MSTKMAD/MK1/02.Hardware/MK1-ATMEGA/EDCPSU_DUAL_MSTK_M1/00. DUAL M1 MSTK PANEL/Panel Layout.jpg

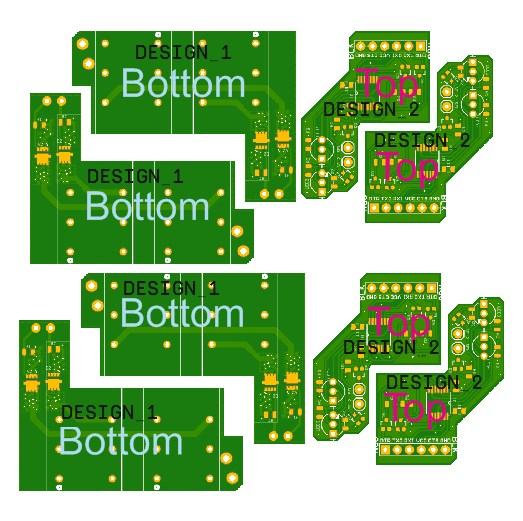
02.Hardware/MK1-ATMEGA/EDCPSU_DUAL_MSTK_M1/00. DUAL M1 MSTK PANEL/Panel Layout.jpg
