MSTKMAD/MK1/README.md

# MK1

Migracion desde Bitbucket del repostorio de la Machete MK1
