MSTKMAD/MK1/01.Documentation/Troubleshoting Display EDCPSU r15.docx

# Troubleshoting Display EDCPSU r15

## Multimeter continuity mode:

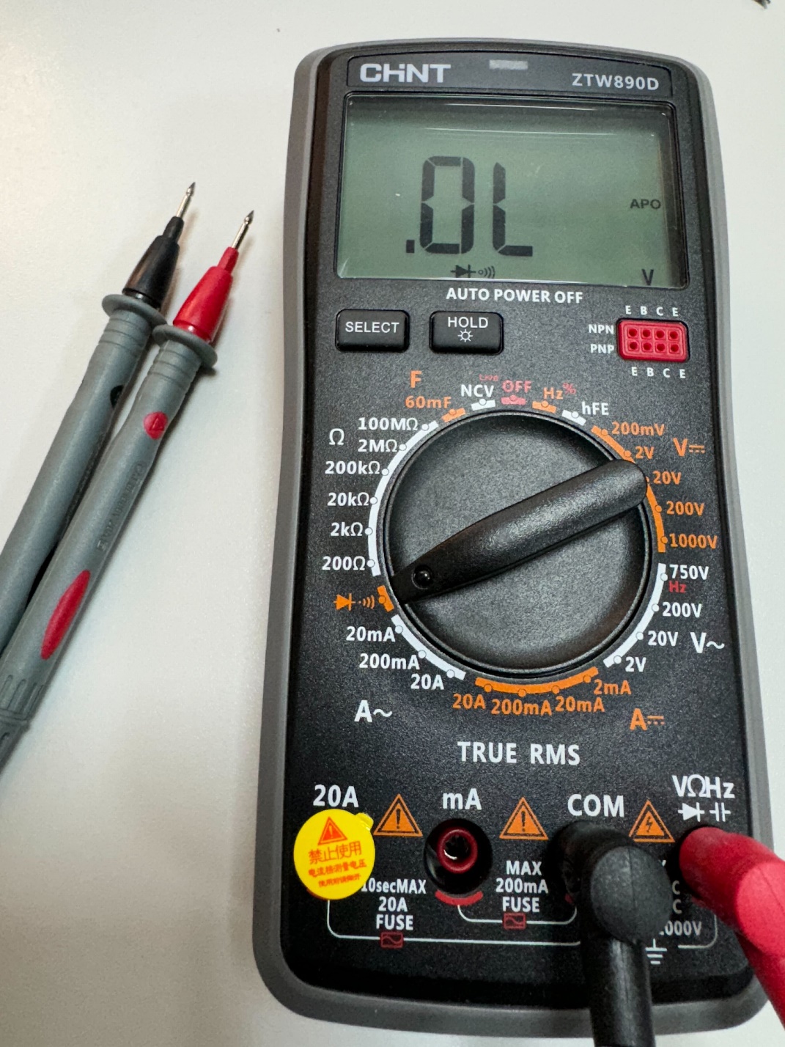
[picture p2: figure]

Pins

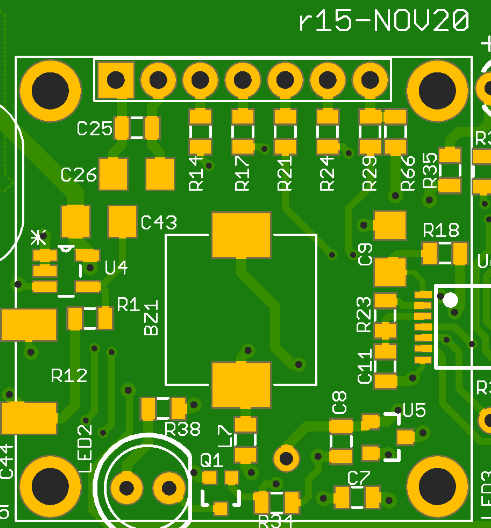
[picture p3: figure]

1

2

3

4

5

6

7

1. GND
2. VCC
3. SCK
4. MOSI
5. DSP_RST
6. MISO
7. SS
1. GND
2. VCC
3. SCK
4. MOSI
5. DSP_RST

4th starting from the Left

6. MISO
7. SS

3th starting from the Right
