MSTKMAD/MK1/02.Hardware/MK1-ATMEGA/EDCPSUr15/GERBER/EUROCIRCUITS-SI_E1262747/EDCPSU r15 files/PI_E1311610.pdf

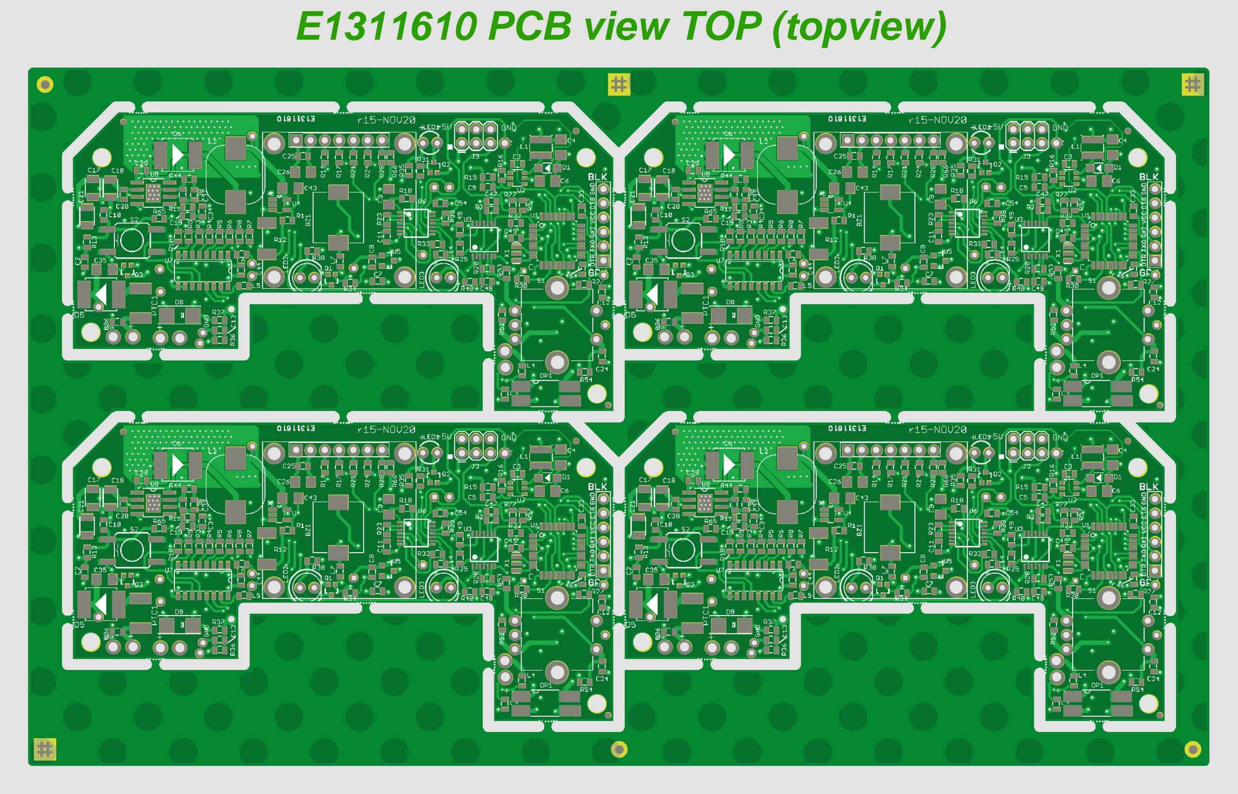
[picture p4: page 1]

E1311610 PCB view TOP (topview)

E1311610 TOP layer Image (topview)

E1311610 Innerlayer 2 Image (topview)

E1311610 Innerlayer 3 Image (topview)

E1311610 BOTTOM layer Image (topview)

E1311610 PCB view BOTTOM (bottomview)

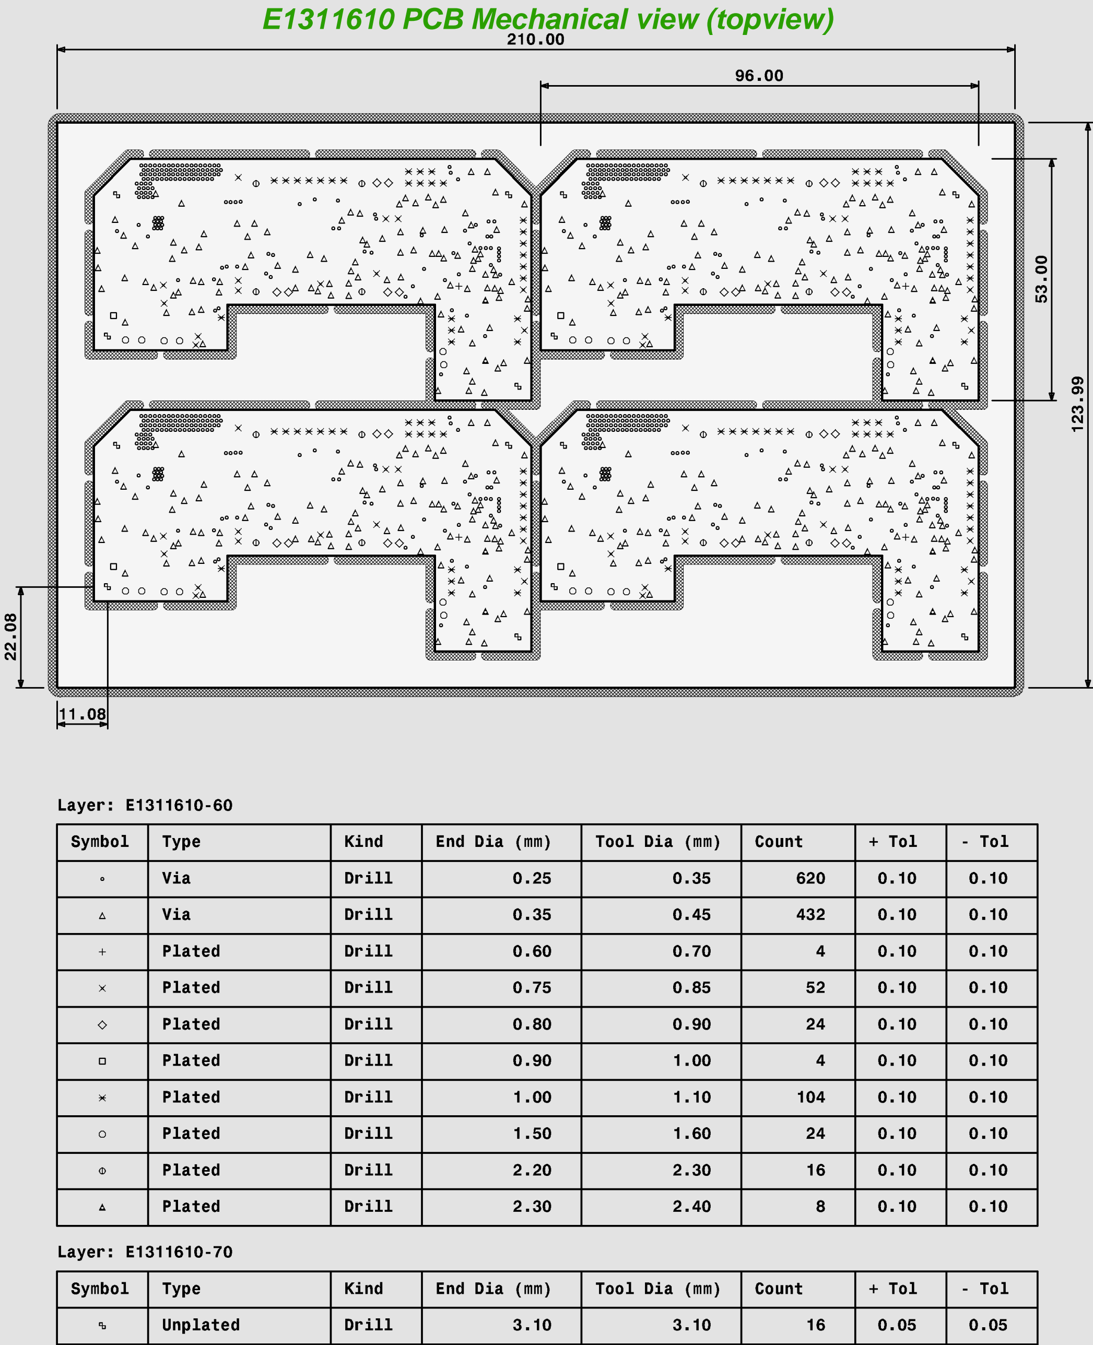
[picture p5: page 7]

E1311610 PCB Mechanical view (topview)
