MSTKMAD/MK1/02.Hardware/MK1-ATMEGA/EDCPSU_DUAL_MSTK_M1/01. DUAL_M1_LEDS/DUAL_M2_LEDS.png

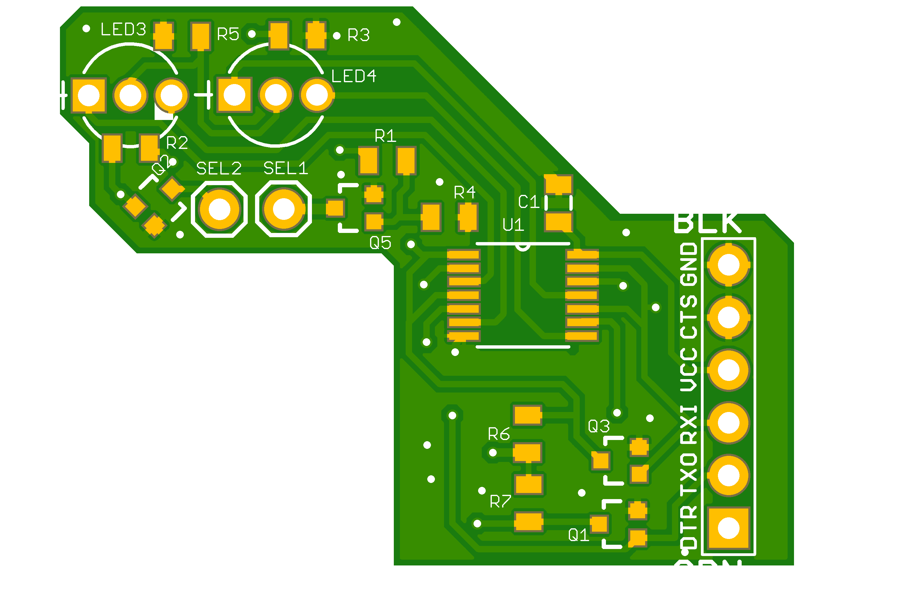
02.Hardware/MK1-ATMEGA/EDCPSU_DUAL_MSTK_M1/01. DUAL_M1_LEDS/DUAL_M2_LEDS.png
