MSTKMAD/MK1/02.Hardware/MK1-ATMEGA/EDCPSUr13/Solucionar Enable.png

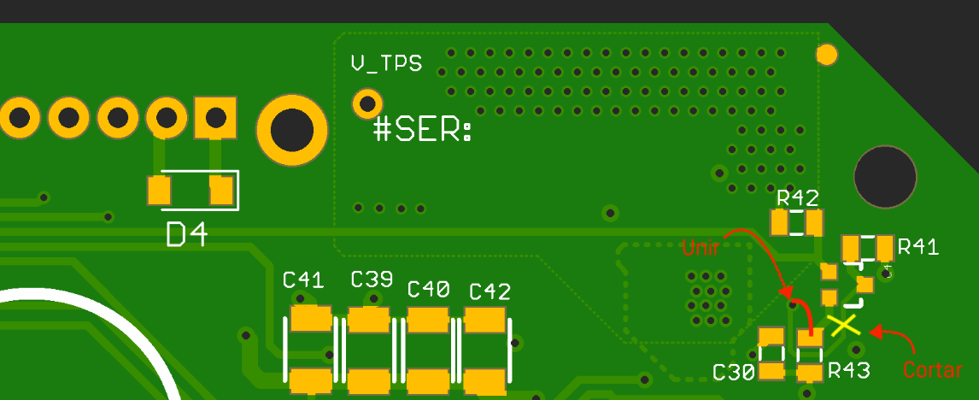
02.Hardware/MK1-ATMEGA/EDCPSUr13/Solucionar Enable.png
