MSTKMAD/MK1/02.Hardware/MK1-ATMEGA/EDCPSUr8v0/EDCPSUr8_BOM_v1.xlsx

Sheet: EDCPSUr7v0enero
 |  |  |  |  |  | BOM VERSION v1
 |  |  |  |  |  | 2016-10-27
 |  |  |  |  |  | EDCPSU_r8v0
Assembly? | Pos | Qty | Parts | Value | Device | Package | Description | Details | DIGIKEY | COST (25pcs) | COST (100pcs) | COST per Board (25pcs)
P | 1 | 1 | R12 | 0.05R / 1W | RESISTOR2512-RES | 2512 | Current sense resistor | 1W, 1%, 75ppm | 985-1555-1-ND | 0.27 | 0.18 | 0.27
P | 2 | 6 | R1, R32, R39, R43, R66, R77 | 10K | RESISTOR0805-RES | 805 | Resistor | 5% |  |  |  | 0
P | 3 | 1 | R11 | 15K | RESISTOR0805-RES | 805 | Resistor | 5%
P | 4 | 1 | R3 | 11K | RESISTOR0805-RES | 805 | Resistor | 5% |  |  |  | 0
P | 5 | 1 | R7 | 180K | RESISTOR0805-RES | 805 | Resistor | 5% |  |  |  | 0
P | 6 | 4 | R2, R19, R20, R25 | 1K | RESISTOR0805-RES | 805 | Resistor | 5% |  |  |  | 0
P | 7 | 1 | R6 | 1K4 | RESISTOR0805-RES | 805 | Resistor | 5% |  |  |  | 0
P | 8 | 1 | R16 | 12K | RESISTOR0805-RES | 805 | Resistor | 5% |  |  |  | 0
P | 9 | 1 | R37 | 220K | RESISTOR0805-RES | 805 | Resistor | 5% |  |  |  | 0
P | 10 | 1 | R10 | 22K | RESISTOR0805-RES | 805 | Resistor | 5% |  |  |  | 0
P | 11 | 7 | R13, R23, R52, R53, R54, R57, R58 | 2K2 | RESISTOR0805-RES | 805 | Resistor | 5% |  |  |  | 0
P | 12 | 1 | R5 | 2K8 | RESISTOR0805-RES | 805 | Resistor | 5% |  |  |  | 0
P | 13 | 10 | R14, R17, R21, R24, R28, R29, R30, R31, R65, R99 | 33 | RESISTOR0805-RES | 805 | Resistor | 5% |  |  |  | 0
P | 14 | 6 | R27, R33, R35, R61 | 330 | RESISTOR0805-RES | 805 | Resistor | 5% |  |  |  | 0
P | 15 | 2 | R22, R26 | 330 | RESISTOR1206-RES | 1206 | Resistor | 5% |  |  |  | 0
P | 16 | 1 | R44 | 33K | RESISTOR0805-RES | 805 | Resistor | 5% |  |  |  | 0
P | 17 | 1 | R9 | 43K | RESISTOR0805-RES | 805 | Resistor | 5% |  |  |  | 0
P | 18 | 1 | R4 | 5K6 | RESISTOR0805-RES | 805 | Resistor | 5% |  |  |  | 0
P | 19 | 1 | R15 | 68K | RESISTOR0805-RES | 805 | Resistor | 5% |  |  |  | 0
P | 20 | 1 | R36 | 75K | RESISTOR0805-RES | 805 | Resistor | 5% |  |  |  | 0
P | 21 | 1 | R8 | 91K | RESISTOR0805-RES | 805 | Resistor | 5% |  |  |  | 0
P | 22 | 30 | C1, C2, C7, C8, C10, C12, C14, C15, C20, C22, C23, C24, C25, C27, C28, C29, C31, C32, C33, C34, C36, C44, C45, C46, C47, C48, C49, C50, C51, C53 | 100n | CAP0805 | 805 | Capacitor | 25V-50V, X7R or XR5 |  |  |  | 0
P | 23 | 6 | C4, C6, C26, C35, C43, C52 | 10uF | CAP1206 | 1206 | Capacitor | 25V-50V, X7R or XR5 |  |  |  | 0
P | 24 | 2 | C3, C30 | 15n | CAP0805 | 805 | Capacitor | 25V-50V, X7R or XR5 |  |  |  | 0
P | 25 | 1 | C38 | 15p | CAP0805 | 805 | Capacitor | 25V-50V, X7R or XR5 |  |  |  | 0
P | 26 | 4 | C11, C13, C16, C54 | 1uF | CAP0805 | 805 | Capacitor | 25V-50V, X7R or XR5 |  |  |  | 0
P | 27 | 1 | C9 | 1uF | CAP1206 | 1206 | Capacitor | 25V-50V, X7R or XR5 |  |  |  | 0
P | 28 | 1 | C37 | 2.2n | CAP0805 | 805 | Capacitor | 25V-50V, X7R or XR5 |  |  |  | 0
P | 29 | 4 | C39, C40, C41, C42 | 22uF | CAP1210 | 1210 | Capacitor | 25V, X5R | 490-6540-1-ND | 0.31 |  | 1.24
P | 30 | 3 | C17, C18, C21 | 4.7uF | CAP1206 | 1206 | Capacitor | 50V, 10% X7R | 1276-2789-1-ND | 0.18 | 0.14 | 0.54
P | 31 | 1 | L2 | 4.7uH | L74437368047 | WE-LHMI |  | 4.7uH, 7A 0.0155 OHM | 732-3389-1-ND | 2.96 | 2.5 | 2.96
P | 32 | 1 | L1 | 6.8uH | L4018 | NR4018T100M | Inductor | 6.8uH, 1A, 0.132R | 587-2657-1-ND | 0.25 | 0.2 | 0.25
P | 33 | 5 | L3, L4, L5, L6, L7 | MMZ2012Y202BT000 | INDUCTOR-0805 | 805 | Inductor | FERRITE CHIP 2000 OHM 400MA | 445-1561-1-ND | 0.08 | 0.045 | 0.4
P | 34 | 2 | U3, U6 | SN74AC14DBR | SN74AC14DBR | SSOP14 | Hex schmitt trigger INVERTER |  | 296-4299-1-ND | 0.38 | 0.28 | 0.76
P | 35 | 1 | U1 | ATMEGA328P-AU | ATMEGA328P-AU | 32-TQFP | MCU 8BIT 32KB FLASH 32TQFP |  | ATMEGA328P-AU-ND (http://www.digikey.es/product-detail/en/ATMEGA328P-AU/ATMEGA328P-AU-ND/1832260) | 2.8 (http://www.digikey.es/product-detail/en/ATMEGA328P-AU/ATMEGA328P-AU-ND/1832260) | 2.56 | 2.8
P | 36 | 1 | U5 | LM3480IM3X-12 | LM3480IM3X-12 | SOT23-3 | Small package linear regulator |  | LM3480IM3X-12/NOPBCT-ND | 0.76 | 0.66 | 0.76
P | 37 | 1 | U4 | MAX9938TEUK+TCT-ND |  | SOT23-5 | Current sense amplifier | X25 GAIN | MAX9938TEUK+TCT-ND | 1 | 0.93 | 1
P | 38 | 1 | U2 | BD9G101G | BD9G101G | SSOP6 | BD9G101G - Simple Step-down |  | BD9G101G-CT-ND | 1.26 | 1.11 | 1.26
P | 39 | 1 | U7 | TPIC2810D | TPIC2810D | SO16 | I2C Led driver |  | 296-21426-5-ND | 1.4 | 1.13 | 1.4
P | 40 | 1 | U8 | TPS54531DDAR | TPS54531DDAR | SOIC8 | BUCK converter |  | 296-40801-1-ND | 2.2 | 1.45 | 2.2
P | 41 | 1 | X1 | 16MHz | RESONATORSMD | 3-SMD, Non-Standard | CER RESONATOR 16.00MHZ SMD | 16MHz | 490-1198-1-ND | 0.39 | 0.31 | 0.39
P | 42 | 1 | S2 | TAC_SWITCH_KSC931G-SMD | TAC_SWITCH_KSC931G-SMD | TAC_SW_SMD_KSC931G | Momentary Switch |  | CKN10432CT-ND | 0.73 | 0.61 | 0.73
P | 43 | 1 | PTC1 | 1,5A HOLD / 3A LIM | PTC | 1812 | PTC RESTTBLE 1.50A 24V CHIP 1812 | 1,5A | 507-1505-1-ND | 0.24 | 0.22 | 0.24
P | 44 | 4 | Q2, Q3, Q9 | 2N7002PW | MOSFET-NCHANNEL2N7002PW | SOT323 | MOSFET N-CH 60V 0.31A, 1.6 Ohm. 2.4 VGS |  | 568-5987-1-ND | 0.24 | 0.18 | 0.96
P | 45 | 2 | D2, D3 | BAV199 | BAV199 | SOT23 | DIODE |  | BAV199INCT-ND | 0.18 | 0.08 | 0.36
P | 46 | 2 | D5, D6 | Diode | DSMC | DO-214AB | SCHOTTKY 40V 5A DO214AB |  | SK54L-TPMSCT-ND | 0.35 | 0.3 | 0.7
P | 47 | 1 | D1 | RB060M-60TR | RB060M-60TR | PMDU | DIODE SCHOTTKY 60V 2A PMDU |  | RB060M-60CT-ND | 0.3 | 0.19 | 0.3
P | 48 | 1 | D8 | B220A-13-F | DIODE | DO-214AC | DIODE SCHOTTKY 20V 2A SMA |  | B220A-FDICT-ND | 0.31 | 0.19 | 0.31
P | 49 | 1 | OP1 | LTV816S | LTV816S | SMD4 Gullwing | OPTO COUPLER | CTRmin=50% @ 5mA, 5KViso | 160-1361-5-ND | 0.28 | 0.18 | 0.28
P | 50 | 1 | BZ1 | PKMCS0909E4000-R1 | PKMCS0909E4000-R1 | SMD | Buzzer 12V |  | 490-9647-1-ND (https://www.digikey.es/product-detail/en/murata-electronics-north-america/PKMCS0909E4000-R1/490-9647-1-ND/4878401) | 1.08 | 0.968 | 1.08
 | 51
NO | 52 | 1 | S1 | ROTARTY_ENCODER | ROTARTY_ENCODER | ROTARY_ENC_PLAIN | Simple no LED rotary encoder
NO | 53 | 1 | LED1 | LED thru hole | LED3MM | LED3MM | LED Yellow
NO | 54 | 13 | TP1, TP2, TP4, TP5, TP6, TP7, TP8, TP9, TP10, TP11, TP12, TP13, TP14 | Test point
NO | 55 | 1 | DC1 | 12V to 5V | NME | NME | DC-DC CONVERTER
NO | 56 | 2 | C5, C19 | N.C. | CAP0805 | 805 | Capacitor
NO | 57 | 1 | R18 | N.C. | RESISTOR0805-RES | 805 | Resistor
NO | 58 | 1 | BZ2 | MCKPT-1340 | BUZZER_MCKPT-1340 | MCKPT-1340 | Buzzer 12V
NO | 59 | 1 | J4 | Connector | Connnector |  | Connector which mates to FTDI basic or FTDI cable.
NO | 60 | 1 | K1 | G6K-2F-RF | RELAY | G6K-RF | OMRON High Frequency Relay G6K-RF
NO | 61 | 1 | LK1 | ISO_12V | LINK | PAD-JUMPER-2-NO_YES_SILK
NO | 62 | 1 | J6 | Display | OLED_LCD | OLED_LCD
NO | 63 | 1 | J3 | Connector | CONNECTOR | 2X3_LOCK | AVR ISP 6 Pin
NO | 64 | 1 | LED2 | LED thru hole | LED 5MM | LED 5MM
NO | 65 |  | LED3

Sheet: Historico
HISTÓRICO
VERSIÓN | FECHA | AUTOR | CAMBIO
0 | 2016-10-17 | D. Garrido | Creación
1 | 2016-10-27 | D. Garrido | Se añade columna de Posicion. Pos30, se corrige encapsulado de condensadores de SMD1210 a 1206 Pos40 , se corrige denominacion de integrado (antes:74HC14). Pos42 , se corrige denominación de integrado (antes: LM3480IM4) Se añade Pos64,65 (sin completar aún)
