MSTKMAD/MK1/02.Hardware/MK1-RP2040/01.EDCPSU/BOM/EDCPSU_MK1_RP2040_BOM-SETI.xlsx

Sheet: EDCPSUMK1
 |  |  | BOM VERSION | 2
 |  |  | 18-ene-24
 |  |  | MK1-RP2040
Assembly? | Pos | Qty | Parts | Value | Device | Package | Description | Details | COST (500pcs) | COST per Board (500 pcs) | DIGIKEY
P | 2 | 1 | BZ1 | PKMCS0909E4000-R1 | PKMCS0909E4000-R1 | PKMCS0909 | PKMCS0909E4000-R1 |  | 0.48 € | 0.48 € | https://www.digikey.es/es/products/detail/murata-electronics/PKMCS0909E4000-R1/4878400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
P | 3 | 3 | C17, C18, C21 | 4.7uF 50V X7R | CAP1210 | SMD1210 | Capacitor |  | 0.11 € | 0.32 € | https://www.digikey.es/en/products/detail/samsung-electro-mechanics/CL32B475KBUYNNE/3886950
NO | 4 | 0 | C19, C65 | N.C. | CAP0805 | SMD0805 | Capacitor |  |  | 0.00 €
P | 5 | 33 | C1, C2, C4, C5, C6, C7, C8, C10, C12, C14, C16, C20, C22, C23, C24, C25, C27, C28, C29, C31, C32, C33, C34, C36, C44, C47, C48, C49, C50, C53, C58, C60, C66 | 100n 50v X7R/X5R | CAP0805 | SMD0805 | Capacitor |  |  | 0.00 €
P | 6 | 4 | C26, C35, C43, C51 | 10uF 50V X5R/X7R | CAP1206 | SMD1206 | Capacitor |  | 0.07 € | 0.28 € | https://www.digikey.es/en/products/detail/samsung-electro-mechanics/CL31A106MBHNNNE/5961220
P | 7 | 2 | C3, C62 | 22uF 10V X5R | CAP0805 | SMD0805 | Capacitor |  | 0.06 € | 0.11 € | https://www.digikey.es/en/products/detail/murata-electronics/GRM21BR61A226ME51L/5027595
P | 8 | 1 | C30 | 33n | CAP0805 | SMD0805 | Capacitor |  |  | 0.00 €
P | 9 | 1 | C37 | 10nF | CAP0805 | SMD0805 | Capacitor |  |  | 0.00 €
P | 10 | 1 | C38 | 16pF | CAP0805 | SMD0805 | Capacitor |  |  | 0.00 €
P | 11 | 4 | C39, C40, C41, C42 | 22uF 25V X5R | CAP1210 | SMD1210 | Capacitor |  | 0.12 € | 0.49 € | https://www.digikey.es/en/products/detail/samsung-electro-mechanics/CL32A226KPJNNNE/3889030
NO | 12 | 0 | C52 | N.C | CAP0805 | SMD0805 | Capacitor |  |  | 0.00 €
P | 13 | 2 | C59, C61 | 27p | CAP0805 | SMD0805 | Capacitor |  |  | 0.00 €
P | 14 | 2 | C63, C64 | 4.7uF 50V X5R | CAP0805 | SMD0805 | Capacitor |  | 0.04 € | 0.09 € | https://www.digikey.es/en/products/detail/murata-electronics/GRT21BR61H475ME13L/5416817
P | 15 | 7 | C9, C11, C13, C15, C45, C46, C54 | 1uF 50V X7R | CAP0805 | SMD0805 | Capacitor |  |  | 0.00 €
NO | 18
P | 17 | 2 | D2, D7 | BAV199 | BAV199 | SOT23 | DIODE |  | 0.11 € | 0.23 € | https://www.digikey.es/es/products/detail/infineon-technologies/BAV199E6327HTSA1/506263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
NO | 18
P | 19 | 1 | D5 | 3SMAJ5923B-TP | 3SMAJ5923B-TP | SMA-DO214 | Zener Diodes 3W 8.2V |  | 0.12 € | 0.12 € | https://www.digikey.es/es/products/detail/micro-commercial-co/3SMAJ5923B-TP/1793169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
NO | 20 | 0 | D6 | N.C | DSMC | DO-214AB |  |  |  | 0.00 €
P | 21 | 1 | D8 | SMAJ18A | SMAJ18A | SMA-DO214 | TVS 18V 400W Unidirectional |  | 0.13 € | 0.13 € | https://www.digikey.es/en/products/detail/littelfuse-inc/SMAJ18A/762282
P | 22 | 1 | DZ1 | MMSZ5228B | MMSZ5228B | SOD123F | Diode Zener 3.9 5% 500mW 2Pin SOD123 Diodes Inc MMSZ5227B-7-F Zener Diode, 3.9V 5% 500 mW SMT 2-Pin SOD-123 |  | 0.09 € | 0.09 € | https://eu.mouser.com/ProductDetail/Diotec-Semiconductor/MMSZ5228B?qs=OlC7AqGiEDkIT4mCF6hrjg%3D%3D
NO | 25 |  |  |  |  |  |  |  | 1.08 € | 0.00 € | https://www.digikey.es/es/products/detail/jae-electronics/DX07S016JA1R1500/11585731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
NO | 26 | 1 | J6 | Display | OLED_LCD | OLED_LCD |  |  |  | 0.00 €
P | 27 | 1 | JP1 | 20021521-00010T1LF | 20021521-00010T1LF | 20021521-00010T1LF | MINITEK 127 SHROUDED HDR |  | 0.64 € | 0.64 € | https://www.digikey.es/en/products/detail/amphenol-cs-fci/20021521-00010T1LF/2414951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
P | 29 | 1 | L1 | NRS4018T4R7MDGJ | NRS4018T4R7MDGJ | NRS4018T100MDGJ | Inductor SMD wirewound 4.7uH |  | 0.12 € | 0.12 € | https://www.digikey.es/en/products/detail/taiyo-yuden/NRS4018T100MDGJ/2648964
P | 30 | 1 | L2 | 4.7uH | L74437368047 | WE-LHMI |  |  | 0.72 € | 0.72 € | https://www.digikey.es/en/products/detail/pulse-electronics/PA4342-472NLT/5436333
P | 31 | 5 | L3, L4, L5, L6, L7 | MMZ2012Y202BT000 | SMD0805 | SMD0805 | Ferrite bead |  | 0.02 € | 0.11 € | https://www.digikey.es/en/products/detail/tdk-corporation/MMZ2012Y202BT000/571868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
P | 32 | 1 | LED1 | LTL1NHSH6D | LTL1NHSH6D | LTL1NHSH6D | LED 3MM LITEON YELLOW 65mcd 60º |  | 0.03 € | 0.03 € | https://www.tme.eu/es/en/details/ltl1nhsh6d/tht-leds-round/liteon/
NO | 33 | 0 | LS1 | SMT-0540-S-R | SMT-0540-S-R | SMT0540SR | Speakers & Transducers SMD TRANSDUCER 3VP-P 100MA |  |  | 0.00 €
P | 34 | 1 | OP1 | LTV816S | LTV816S | SMD4 | OPTO COUPLER |  | 0.13 € | 0.13 € | https://www.digikey.es/es/products/detail/liteon/LTV-816S/385831?s=N4IgTCBcDaIIwDYAMBaOBmBcUFYUDkAREAXQF8g
P | 35 | 1 | PTC1 | 2A NOM / 3.5A LIM | 0ZCC0150BF2C | SMD1812 | PTC RESTTBLE 1.50A 24V CHIP 1812 |  | 0.13 € | 0.13 € | https://www.digikey.es/es/products/detail/bel-fuse-inc/0ZCC0150BF2C/2165288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
P | 36 | 3 | Q2, Q4, Q9 | 2N7002PW | MOSFET-NCHANNEL2N7002PW | SOT323 | N-MOSFET VGS=2.4V 500mA, VDS=60V |  | 0.09 € | 0.26 € | https://www.digikey.es/es/products/detail/nexperia-usa-inc/2N7002PW-115/2296328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
P | 37 | 6 | R1,R32, R39, R40, R42, R66 | 10K | RESISTOR0805 | SMD0805 | Generic Resistor Package |  |  | 0.00 €
P | 38 | 1 | R10 | 22K | RESISTOR0805 | SMD0805 | Generic Resistor Package |  |  | 0.00 €
P | 39 | 1 | R12 | 0.025R / 1W | RR2512 | SMD2512 | 25mR Sensing resistor |  | 0.19 € | 0.19 € | https://www.digikey.es/en/products/detail/yageo/RL2512FK-070R025L/3885847
P | 40 | 7 | R13, R23, R52, R53, R54,R64,R67 | 2K2 | RESISTOR0805 | SMD0805 | Generic Resistor Package |  |  | 0.00 €
P | 41 | 7 | R14, R17, R21, R24, R28, R29, R65 | 33R | RESISTOR0805 | SMD0805 | Generic Resistor Package |  |  | 0.00 €
NO | 42 | 6 | R16, R18, R30, R45, R58, R60 | N.C | RESISTOR0805 | SMD0805 | Generic Resistor Package |  |  | 0.00 €
P | 43 | 6 | R2, R19, R20, R25, R27, R46 | 1K | RESISTOR0805 | SMD0805 | Generic Resistor Package |  |  | 0.00 €
P | 44 | 7 | R22, R26, R31, R33, R61, R99, R57 | 330R | RESISTOR0805 | SMD0805 | Generic Resistor Package |  |  | 0.00 €
P | 45 | 2 | R3, R43 | 11K | RESISTOR0805 | SMD0805 | Generic Resistor Package |  |  | 0.00 €
P | 46 | 2 | R37, R41 | 150K | RESISTOR0805 | SMD0805 | Generic Resistor Package |  |  | 0.00 €
NO | 18
P | 48 | 1 | R4 | 5K6 | RESISTOR0805 | SMD0805 | Generic Resistor Package |  |  | 0.00 €
NO | 49 | 0 | - | - | - | - | - |  |  | 0.00 €
P | 50 | 1 | R36 | 27K | RESISTOR0805 | SMD0805 | Generic Resistor Package |  |  | 0.00 €
P | 51 | 1 | R44 | 25K | RESISTOR0805 | SMD0805 | Generic Resistor Package |  |  | 0.00 €
NO | 52 |  |  |  |  |  |  |  |  | 0.00 €
P | 53 | 1 | R5 | 2K8 | RESISTOR0805 | SMD0805 | Generic Resistor Package |  |  | 0.00 €
P | 54 | 1 | R50 | 56K | RESISTOR0805 | SMD0805 | Generic Resistor Package |  |  | 0.00 €
P | 55 | 1 | R51 | 390K | RESISTOR0805 | SMD0805 | Generic Resistor Package |  |  | 0.00 €
NO | 56 |  |  |  |  |  |  |  |  | 0.00 €
NO | 57 | 0 | - | - | - | - | - |  |  | 0.00 €
P | 58 | 1 | R6 | 1K4 | RESISTOR0805 | SMD0805 | Generic Resistor Package |  |  | 0.00 €
NO | 59 |  |  |  |  |  |  |  |  | 0.00 €
P | 60 | 1 | R7 | 180K | RESISTOR0805 | SMD0805 | Generic Resistor Package |  |  | 0.00 €
P | 61 | 1 | R8 | 91K | RESISTOR0805 | SMD0805 | Generic Resistor Package |  |  | 0.00 €
P | 62 | 1 | R9 | 43K | RESISTOR0805 | SMD0805 | Generic Resistor Package |  |  | 0.00 €
P | 63 | 1 | R35 | 130R | RESISTOR0805 | SMD0805 | Generic Resistor Package |  |  | 0.00 €
NO | 64 |  |  |  |  |  |  |  | 0.06 € | 0.00 € | https://www.digikey.es/en/products/detail/bourns-inc/CRL1206-FW-R100ELF/3593165
P | 65 | 1 | S1 | PEC12R-3220F-S0024 | ROTARTY_ENCODER | PEC12R-3220F-S0024 | ROTARY ENCODER MECHANICAL 24PPR |  | 0.91 € | 0.91 € | https://www.digikey.es/en/products/detail/bourns-inc/PEC12R-3220F-S0024/4699265
P | 66 | 1 | S2 | KSC931G LFS | KSC931G LFS | KSC931G LFS | Momentary switch |  | 0.54 € | 0.54 € | https://www.digikey.es/en/products/detail/c-k/KSC931G-LFS/3533878
P | 67 | 1 | U1 | RP2040TR7 | RP2040TR7 | 56-QFN (7x7) | ARM MCU, RP2040 Series Microcontrollers, ARM Cortex-M0+, 32 bit, 133 MHz, 16 MB, 56 Pins |  | 0.65 € | 0.65 € | https://www.digikey.es/es/products/detail/raspberry-pi/SC0914-13/14306010?s=N4IgTCBcDaIE4AcwAYAsyQF0C%2BQ
NO | 68 |  |  |  |  |  |  |  |  | 0.00 €
P | 69 | 1 | U11 | AP63203 | AP63203WU-7 | SOT23-6 | Switching Voltage Regulators DCDC Conv HV Buck TSOT26 T&R 3K |  | 0.43 € | 0.43 € | https://www.digikey.es/es/products/detail/diodes-incorporated/AP63203WU-7/9858426
P | 70 | 1 | U12 | AP64501SP-13 | AP64501SP-13 | SOIC8 | Conv DC-DC 3.8V to 40V Synchronous Step Down Single-Out 0.8V to 39V 5A 8-Pin SO EP T/R |  | 1.25 € | 1.25 € | https://www.digikey.es/es/products/detail/diodes-incorporated/AP64501SP-13/10419715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
NO | 71 | 0 | U2 | MCP4725A1T-E/CH | MCP4725A1T-E/CH | SOT23-6 | MCP4725 DAC |  |  | 0.00 € | https://www.digikey.es/es/products/detail/microchip-technology/MCP4725A1T-E-CH/1827895
P | 72 | 2 | U3, U6 | SN74AC14PWR | 7414 | TSSOP14 | Hex schmitt trigger INVERTER |  | 0.27 € | 0.54 € | https://www.digikey.es/es/products/detail/texas-instruments/SN74AC14PWR/376031
P | 73 | 1 | U4 | MAX9938TEUK+TCT-ND | integrated Circuit | SOT23-5 | Current sense amplifier. GAIN=25 |  | 1.08 € | 1.08 € | https://www.digikey.es/es/products/detail/analog-devices-inc-maxim-integrated/MAX9938TEUK-T/1937784
P | 74 | 1 | U5 | W25Q64JVSSIQ | W25Q64JVSSIQ | SOIC8-WIDE | 64M-bit Serial Flash Memory with uniform 4KB sectors and Dual/Quad SPI |  | 0.76 € | 0.76 € | https://www.digikey.es/es/products/detail/winbond-electronics/W25Q64JVSSIQ/5803992
P | 75 | 1 | U7 | TPIC2810D | TPIC2810D | SOIC16 |  |  | 1.03 € | 1.03 € | https://www.digikey.es/es/products/detail/texas-instruments/TPIC2810D/509926
P | 76 | 1 | U8 | LM4040C30FTA | LM4040C30FTA | SOT23 | Diodes Inc LM4040C30FTA, Shunt Precision Voltage Reference 3V, 0.5%, 3-Pin SOT-23 |  | 0.28 € | 0.28 € | https://www.digikey.es/es/products/detail/diodes-incorporated/LM4040C30FTA/4249970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
NO | 77 |  |  |  |  |  |  |  | 0.86 € | 0.00 € | https://www.digikey.es/es/products/detail/analog-devices-inc-maxim-integrated/MAX9064EUK-T/1937852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
P | 78 | 1 | X1 | ABM3C-12.000MHZ-D4Y-T | ABM3C-12.000MHZ-D4Y-T | ABM3C-12.000MHZ-D4Y-T | Abracon 12MHz Crystal +/-30ppm 4-SMD, No Lead 5 x 3 x 1.3mm |  | 0.57 € | 0.57 € | https://www.digikey.es/es/products/detail/abracon-llc/ABM3C-12-000MHZ-D4Y-T/2639882
P | 79 | 1 | R15 | 0R | RESISTOR0805 | SMD0805 | Generic Resistor Package |  |  | 0.00 €
NO | 80 | 0 | D3 | N.C | BAV199 | SOT23 | DIODE |  |  | 0.00 €
P | 81 | 1 | R11 | 15K | RESISTOR0805 | SMD0805 | Generic Resistor Package |  |  | 0.00 €
 |  |  |  |  |  |  |  |  | 13.18 € | 12.72 €

Sheet: Historico
HISTÓRICO
VERSIÓN | FECHA | AUTOR | CAMBIO
1 | 2023-11-16 | JRC | Creacion.
 |  |  | Modificaciones frente a la v4 de la MK2-RP2040: La posicion 5 pasa de Qty 34 a 32. Se eliminan los parts C55 y C57. La posicion 15 pasa de Qty 8 a 7. Se elimina el part C56. La posicion 36 pasa de Qty 4 a 3. Se elimina el part Q5. La posicion 37 pasa de Qty 7 a 6. Se elimina el part R49. La posicion 40 pasa de Qty 5 a 7. Se agregan los parts R64 y R67. La posicion 42 pasa de Qty 7 a 6. Se elimina el part R34 La posicion 43 pasa de Qty 7 a 6. Se elimna el part R59. Se elimina la posicion 18, part D4. Se elimina la posicion 25, part J1 Se elimina la posicion 52, parts R47 y R48 Se elimina la posicion 56, parts R55. R56 Se elimina la posicion 59, part R62 Se elimina la posicion 64, part RSENSE Se elimina la posicion 68, part U10 Se elimina la posicion 77, part U9 Se elimina la posicion 16, part D1 Se elimina la posicion 47, part R38 y R63
2 | 18-ene-24 | DGB | Se añade C1 Pos.5
