MSTKMAD/MK1/02.Hardware/MK1-ATMEGA/EDCPSU_DUAL_MSTK_M1/03. BOM/BOM-DUAL-MCHT.xlsx

Sheet: BOM-DUAL-MCHT
 |  |  | VERSION | 2
 |  | PCB-LEDs
Qty | Value | Device | Package | Parts | Description | Link
1 | 100n | CAPACITOR | SMD-0805 | C1
4 | 2N7002PW | TRANSISTOR | SOT323 | Q1, Q2, Q3, Q5 | Common NMOSFET Parts | https://www.digikey.es/product-detail/es/infineon-technologies/2N7002H6327XTSA2/2N7002H6327XTSA2CT-ND/5409977
1 | 74AC08MTCX | INTEGRATED CIRCUIT | SOP65P640X120-14N | U1 | Quad 2-Input AND Gate | https://www.digikey.es/product-detail/es/texas-instruments/SN74AC08PWR/296-4292-1-ND/375335
2 | xlvgmyk34m | DIODE LED | xlvgmyk34m | LED3, LED4 |  | https://www.digikey.es/products/en?keywords=xlvgmyk34m
2 | 1k | RESISTOR | SMD-0805 | R1,R2
3 | 10k | RESISTOR | SMD-0805 | R4, R6,R7
1 | 240 | RESISTOR | SMD-0805 | R5
1 | Not mounted | RESISTOR | SMD-0805 | R3 |  | Do not mount
 |  | PCB-JACK
Qty | Value | Device | Package | Parts | Description | Columna1
2 | 10k | RESISTOR | SMD-0805 | R1, R2 | Generic Resistor Package
2 | NVTFS9D6P04M8LTAG | TRANSISTOR | NVTFS5124PLTWG | Q1, Q2 | MOSFET MV8 P INITIAL PROGRAM | https://www.digikey.es/product-detail/es/on-semiconductor/NVTFS9D6P04M8LTAG/488-NVTFS9D6P04M8LTAGCT-ND/11593208

Sheet: History
 | HISTORY
BOM version | PCB version | PBA version | Date | Author | Description
1 | 1 | 1 | 2021-07-20 | JRC | Creacion
2 | 1 | 1 | 2022-03-14 | DGB | Se consolidan las unidades de 10k en una sola linea (LEDS PCB). R3 no debe de montarse pq forma un divisor resistivo con R6 q hace que no funcione

Sheet: Contact
Document property of:
EXINOM CORE SL
Calle Aranjuez, 513
28805
Alcala de Henares
Spain
mail | david@exinom.com
mobile | +34 603486681
