MSTKMAD/MK1/03.Firmware/MK1-ATMEGA/HW_R9. dual/728/BOM-DUAL-MCHT.xlsx

Sheet: DUAL_M2_LEDS
 |  | PCB-LEDs
Qty | Value | Device | Package | Parts | Description | Link
1 | 100n | Capacitor | SMD-0805 | C1
4 | 2N7002PW | Transistor | SOT323 | Q1, Q2, Q3, Q5 | Common NMOSFET Parts | https://www.digikey.es/product-detail/es/infineon-technologies/2N7002H6327XTSA2/2N7002H6327XTSA2CT-ND/5409977
1 | 74AC08MTCX | integrated circuit | SOP65P640X120-14N | U1 | Quad 2-Input AND Gate | https://www.digikey.es/product-detail/es/texas-instruments/SN74AC08PWR/296-4292-1-ND/375335
2 | XLVGMYK34M | Led | 3mm | LED3, LED4 | bi-color led yellow-green | https://www.digikey.es/products/en?keywords=xlvgmyk34m
2 | 1k | RESISTOR | SMD-0805 | R1,R2
2 | 10k | RESISTOR | SMD-0805 | R3,R4
1 | 240 | RESISTOR | SMD-0805 | R5
2 | 10k | RESISTOR | SMD-0805 | R6,R7

Sheet: JACK_DUAL_M2
 |  | PCB-JACK
Qty | Value | Device | Package | Parts | Description
2 | 10k | RESISTOR0805 | 805 | R1, R2 | Generic Resistor Package
2 | NVTFS9D6P04M8LTAG | NVTFS9D6P04M8LTAG | NVTFS5124PLTWG | Q1, Q2 | MOSFET MV8 P INITIAL PROGRAM | https://www.digikey.es/product-detail/es/on-semiconductor/NVTFS9D6P04M8LTAG/488-NVTFS9D6P04M8LTAGCT-ND/11593208
