MSTKMAD/MK1/02.Hardware/MK1-ATMEGA/EDCPSUr12/EDCPSU.dxf

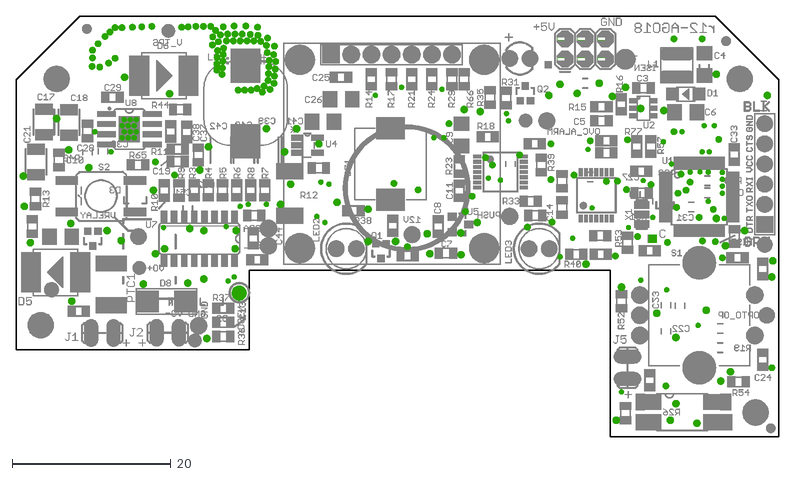
[picture p8: CAD file, 2023-06-05]
02.Hardware/MK1-ATMEGA/EDCPSUr12/EDCPSU.dxf
96.0 x 53.0
