MSTKMAD/MK1/02.Hardware/MK1-ATMEGA/EDCPSUr14/EDCPSUr14.dxf

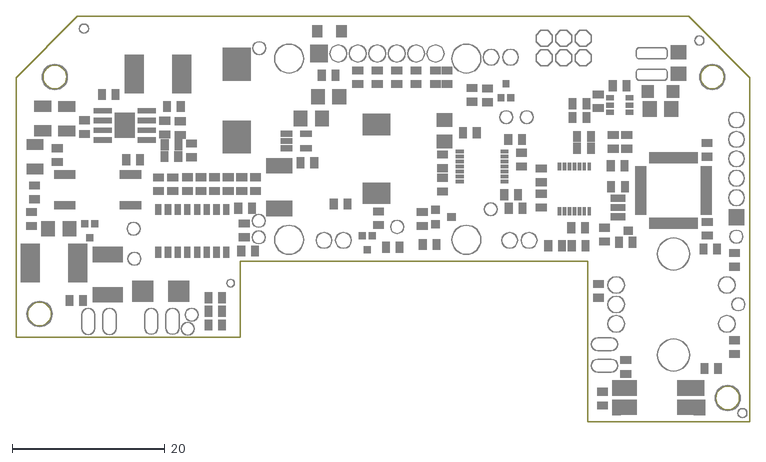
[picture p9: CAD file, 2023-06-05]
02.Hardware/MK1-ATMEGA/EDCPSUr14/EDCPSUr14.dxf
96.0 x 53.0
