MSTKMAD/MK1/02.Hardware/MK1-ATMEGA/EDCPSUr9/EDCPSUr9v0.dxf

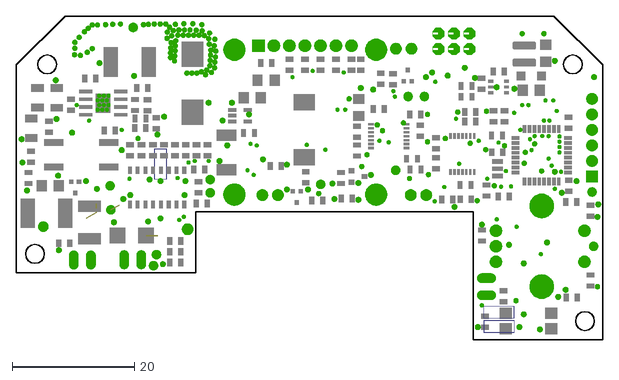
[picture p11: CAD file, 2023-06-05]
02.Hardware/MK1-ATMEGA/EDCPSUr9/EDCPSUr9v0.dxf
96.0 x 53.0
