MSTKMAD/MK1/02.Hardware/MK1-ATMEGA/EDCPSUr15/EDCPSU_r15.dxf

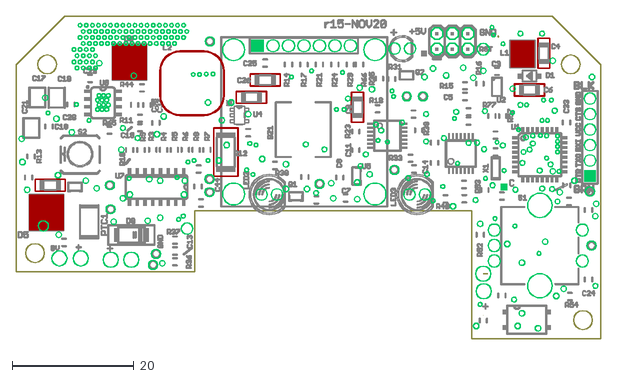
[picture p12: CAD file, 2023-06-05]
02.Hardware/MK1-ATMEGA/EDCPSUr15/EDCPSU_r15.dxf
96.0 x 53.0
