MSTKMAD/MK1/02.Hardware/MK1-ATMEGA/EDCPSUr9/EDCPSUr9v0_bot.dxf

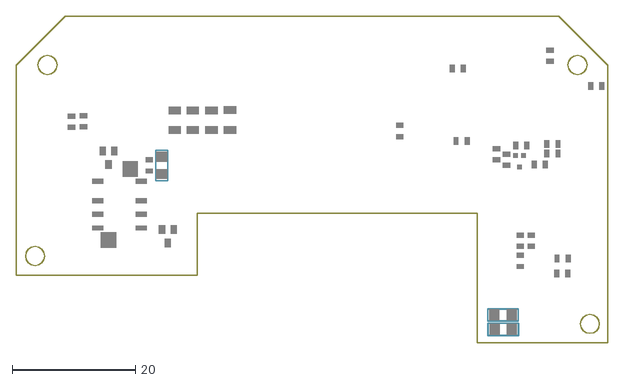
[picture p13: CAD file, 2023-06-05]
02.Hardware/MK1-ATMEGA/EDCPSUr9/EDCPSUr9v0_bot.dxf
96.0 x 53.0
