MSTKMAD/MK1/02.Hardware/MK1-ATMEGA/EDCPSUr14/EDCPSUr14_bot.dxf

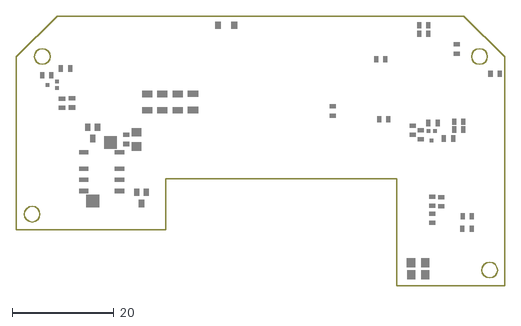
[picture p14: CAD file, 2023-06-05]
02.Hardware/MK1-ATMEGA/EDCPSUr14/EDCPSUr14_bot.dxf
96.0 x 53.0
