MSTKMAD/MK1/02.Hardware/MK1-ATMEGA/EDCPSU_DUAL_MSTK_M1/01. DUAL_M1_LEDS/HISTORY/V1/DUAL_OUT_LEDs.dxf

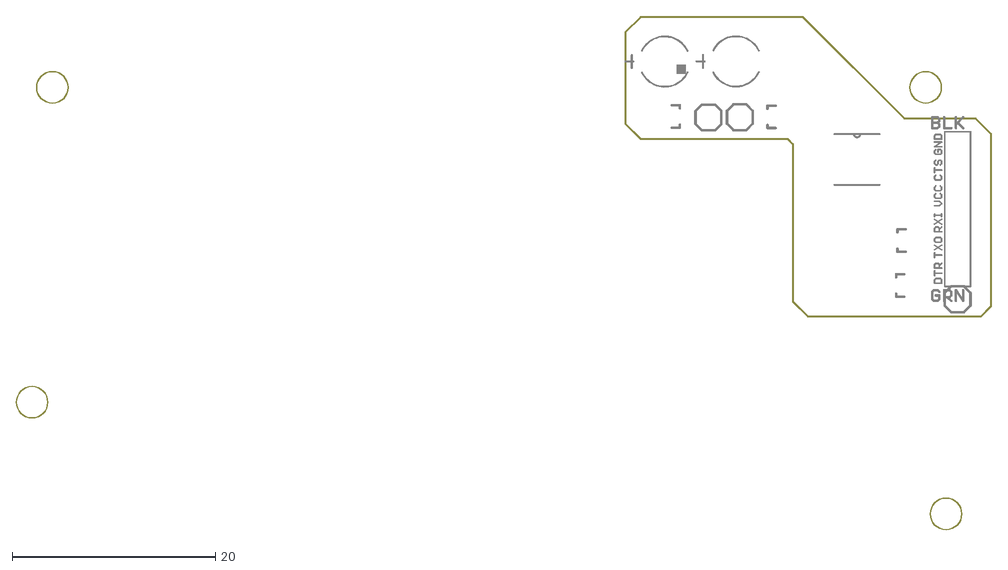
[picture p15: CAD file, 2023-06-05, an earlier design]
02.Hardware/MK1-ATMEGA/EDCPSU_DUAL_MSTK_M1/01. DUAL_M1_LEDS/HISTORY/V1/DUAL_OUT_LEDs.dxf
96.0 x 50.5
