MSTKMAD/MK1/02.Hardware/MK1-ATMEGA/EDCPSU_DUAL_MSTK_M1/01. DUAL_M1_LEDS/HISTORY/V1/Top v22.dxf

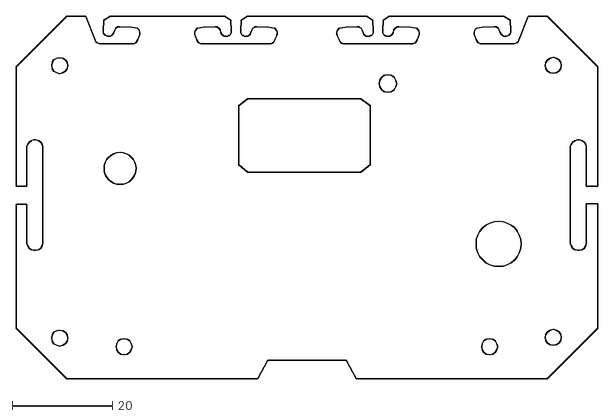
[picture p16: CAD file, 2023-06-05, an earlier design]
02.Hardware/MK1-ATMEGA/EDCPSU_DUAL_MSTK_M1/01. DUAL_M1_LEDS/HISTORY/V1/Top v22.dxf
116.0 x 72.3
