MSTKMAD/MK1/02.Hardware/MK1-ATMEGA/EDCPSUr15/Montaje de pantalla r15 sobre PCB r14-como solucionar.docx

Cambios EDCSPU 14 –A – EDCPSU15

El circuito de sensado de voltaje para el ENABLE está mal diseñado y siempre deja encendida el pedal.

Cambio

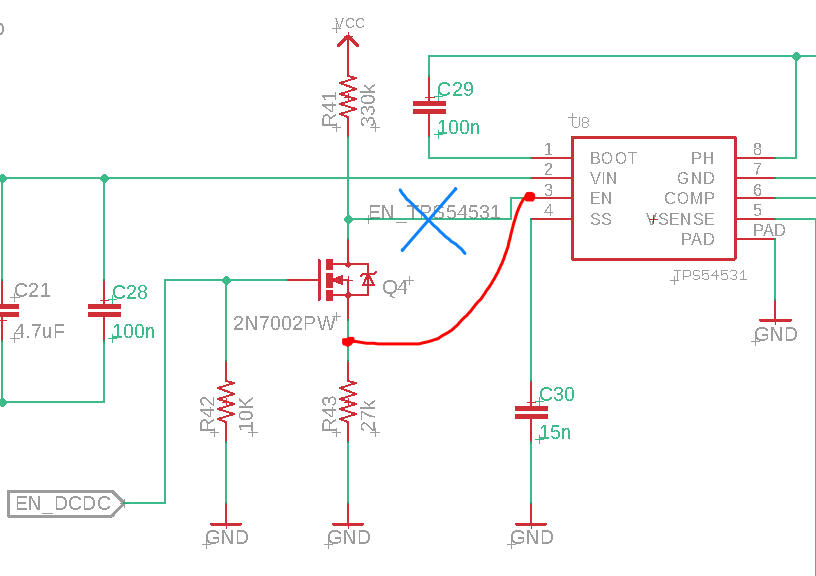
[picture p17: figure]

El enable del DCDC está mal enganchado al MOSFET. Hay que llevar el pin 3 de U8 a N$35 como se ve en la imagen.

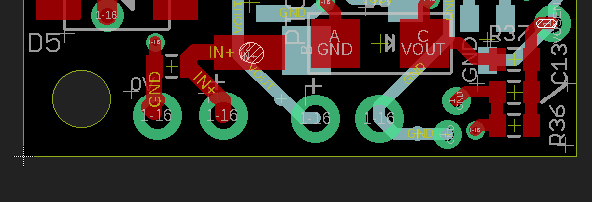
[picture p18: figure]

Hacer los pines de los cables de entrada más grandes

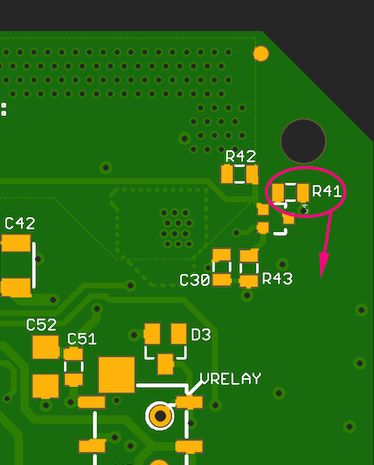
[picture p19: figure]

Mover R41 fuera del alcance del separador

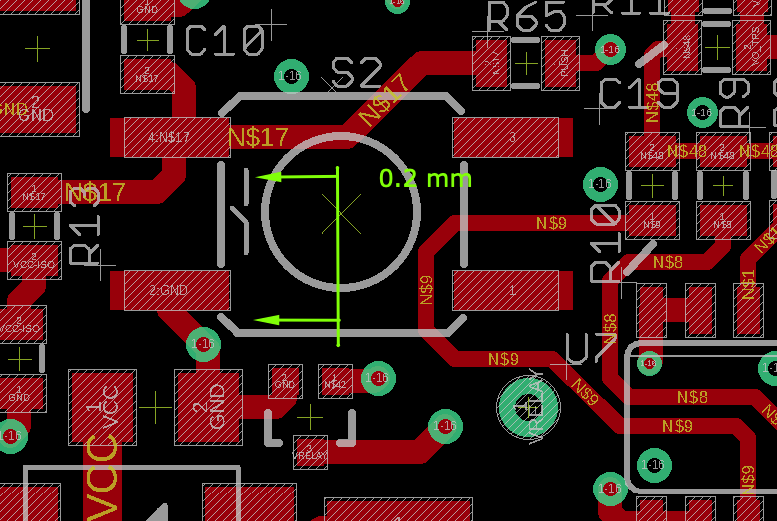
[picture p20: figure]

Desplazamos a la izquierda S2 0,2mm. He intentado añadir soldermask pero no es posible, solo retirarlo. También he probado a hacer un tRestrict para que retire cobre, pero no lo hace.

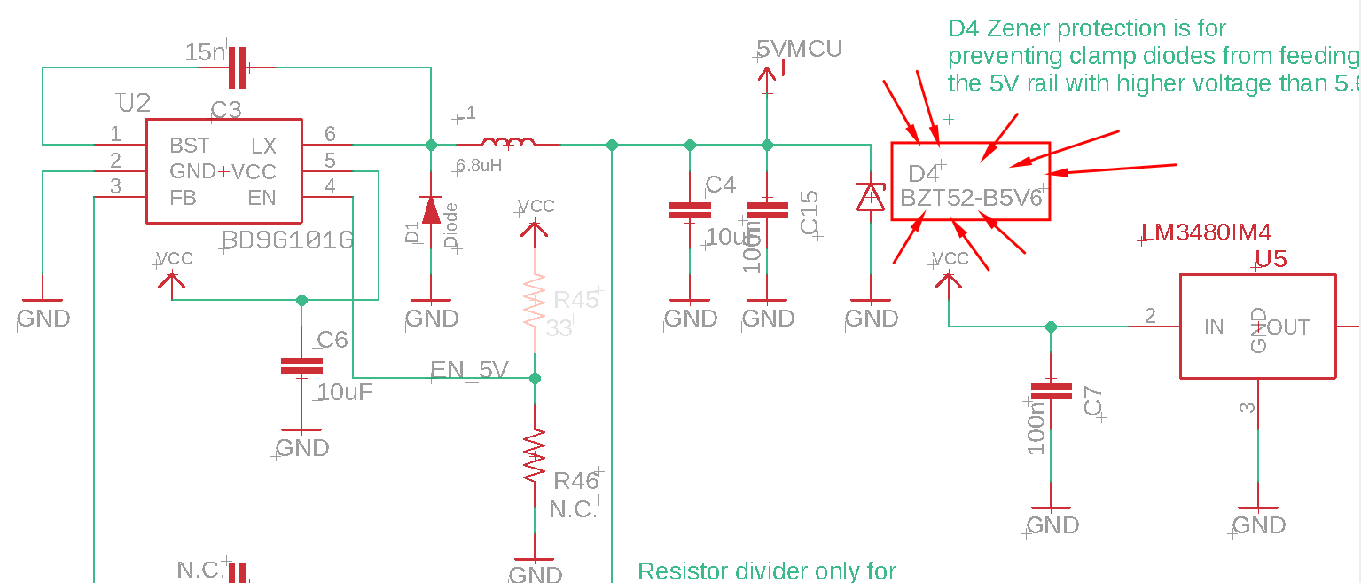
[picture p21: figure]

Añadimos zener de 5v6 en paralelo a 5V para evitar que pueda subir el voltaje cuando los diodos de clamp entran en funcionamiento por una sobre corriente

Nuevas aberturas en la pantalla BOTTOM

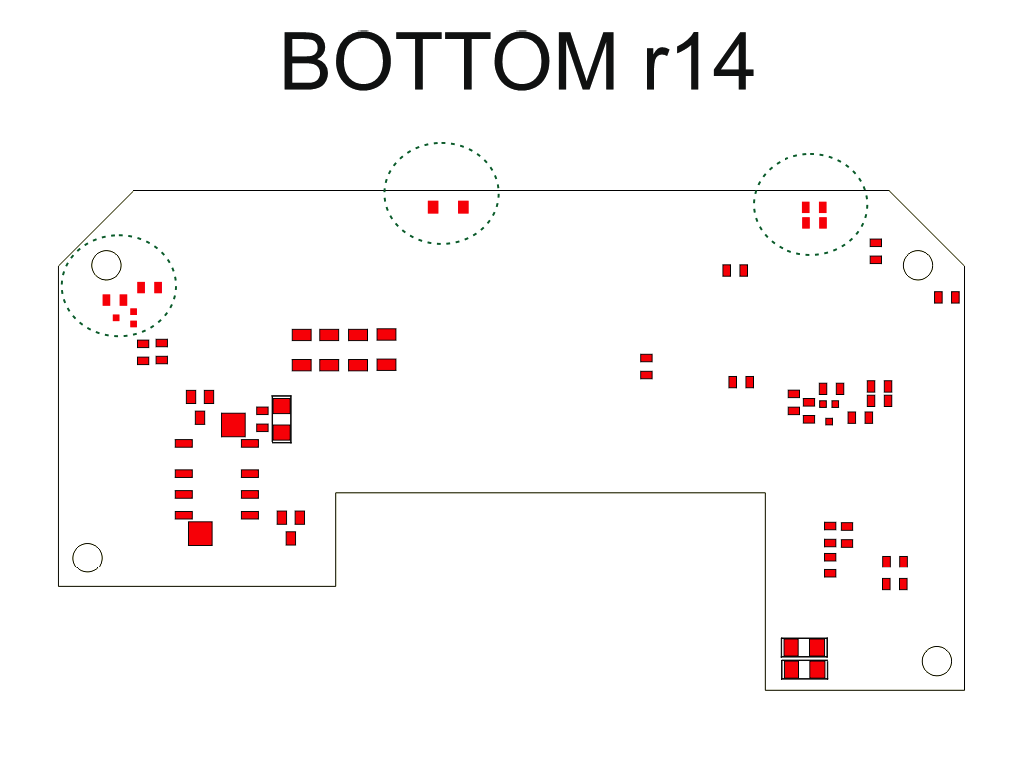
[picture p22: figure]
