MSTKMAD/MK1/02.Hardware/MK1-ATMEGA/EDCPSUr8v0/PRINT/POWER.png

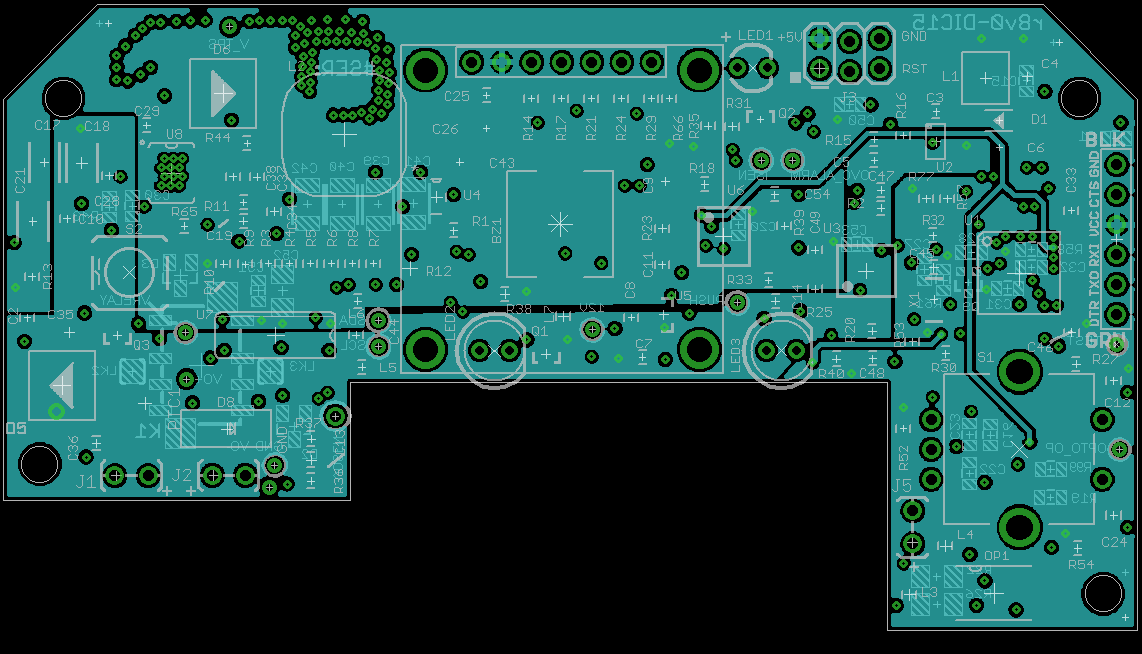
02.Hardware/MK1-ATMEGA/EDCPSUr8v0/PRINT/POWER.png
