MSTKMAD/MK1/02.Hardware/MK1-ATMEGA/EDCPSUr12/Cambios EDCSPU r11 a r12.docx

Cambios EDCSPU 11 –A – EDCPSU12

  - ISENSE al lado de conector de programación con la idea de dejarlo preparado para M2
- PIN de Test (ahora maneja los leds) con un pad “soldable” para usarlo conjuntamente con una posible tarjeta hija en M2 que controle la detección de cambio de memoria del HUB

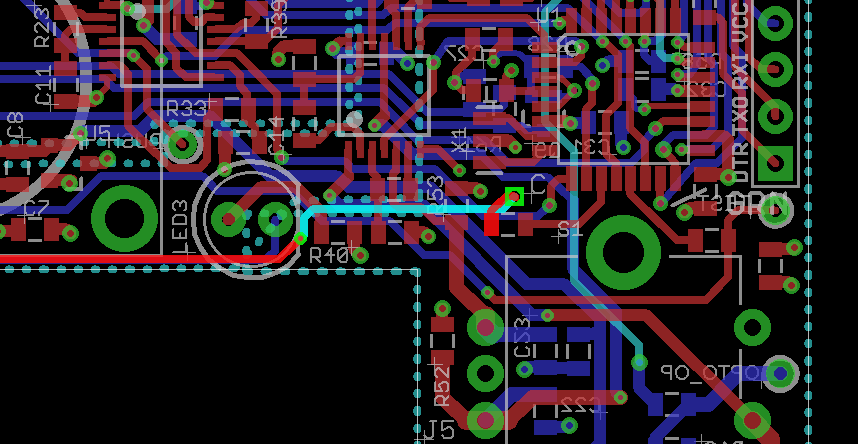
[picture p24: figure]
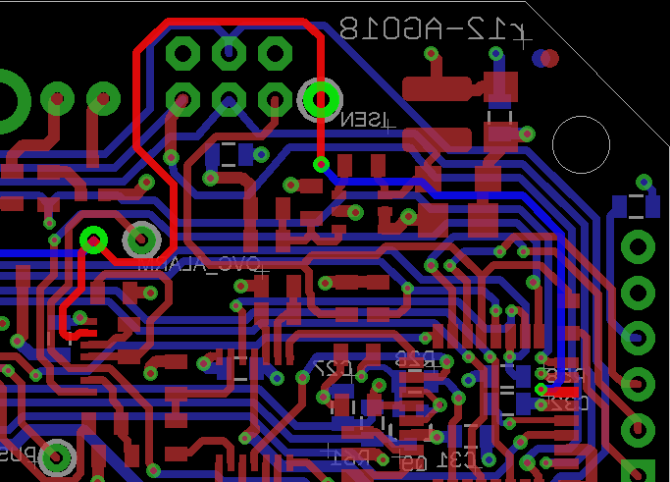
[picture p25: figure]
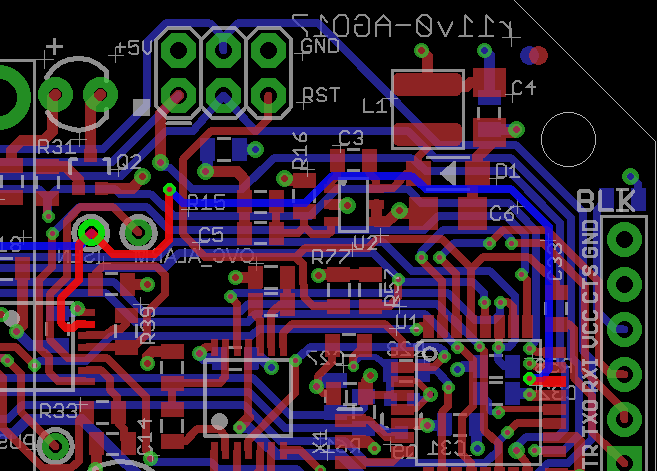
[picture p26: figure]
