MSTKMAD/MK1/02.Hardware/MK1-ATMEGA/EDCPSUr14/Cambios EDCSPU r13 a r14.docx

Cambios EDCSPU 13 –A – EDCPSU14

He intentado hacer una comparación de gerbers entre la versión r12 a r13 pero ni siquiera tienen la misma referencia espacial, es decir que no es fácil superponerlos y ver qué ha cambiado.

En un principio, como no sé qué ha cambiado en r13, así que voy a dejarlo en barbecho y daré un salto de la r12 a r14 sin haber cambio en la r13 porque no sé qué es lo que hay.

Cambio

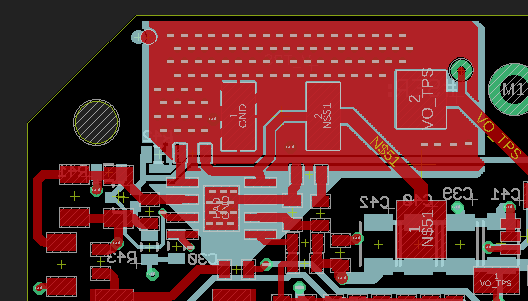
[picture p27: figure]

El pad térmico de disipación del DCDC voy a unirlo a GND en vez de dejarlo unido al OUT. Este diseño es un error que descubrí haciendo la MSTK muscle para bishop.

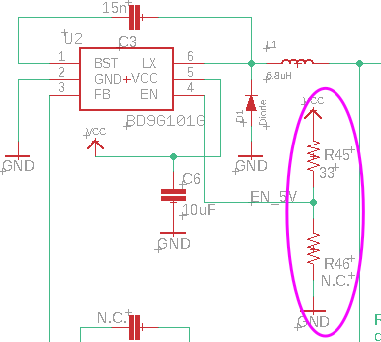
[picture p28: figure]

Añadir una resistencia para hacer un divisor de tensión en el ENABLE del DCDC de 5V para que sea compatible con otros modelos de DCDC que no aguantan tanto voltaje en esta entrada

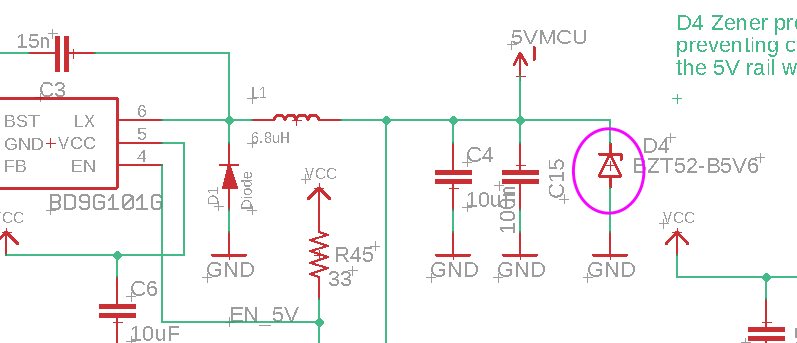
[picture p29: figure]

Añadir un zéner de 5.6V en paralelo al rail de 5V para evitar que subidas de tensión en el medidor de corriente de salida hagan conducir los diodos de clamp de CPU y Schmidth trigger y subir el voltaje de todo el rail

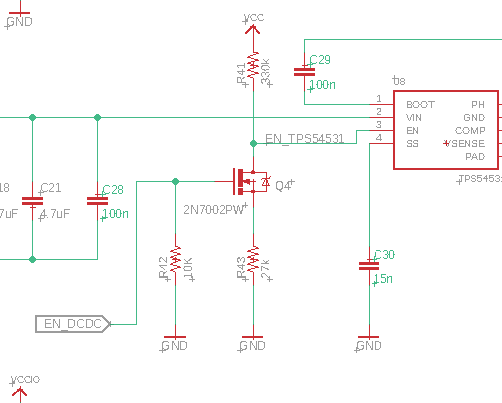
[picture p30: figure]

Añadir un circuito de Enable con sensado de Vin en la entrada del DCDC de voltaje de salida para que si la tensión de entrada cae se deshabilite la salida.

Nuevas aberturas en la pantalla BOTTOM
