MSTKMAD/MK1/02.Hardware/MK1-ATMEGA/EDCPSUr15/Cambios EDCSPU r14 a r15.docx

Cambios EDCSPU 14 –A – EDCPSU15

El circuito de sensado de voltaje para el ENABLE está mal diseñado y siempre deja encendida el pedal.

Cambio


El enable del DCDC está mal enganchado al MOSFET. Hay que llevar el pin 3 de U8 a N$35 como se ve en la imagen.


Hacer los pines de los cables de entrada más grandes


Mover R41 fuera del alcance del separador


Desplazamos a la izquierda S2 0,2mm. He intentado añadir soldermask pero no es posible, solo retirarlo. También he probado a hacer un tRestrict para que retire cobre, pero no lo hace.

Nuevas aberturas en la pantalla BOTTOM
