MSTKMAD/MK1/02.Hardware/MK1-RP2040/02.JACKS_EDCPSU/GERBER v5/Cambios Jack v4 a v5.docx

Cambios PCB JACK – de GERBER v4 a v5

23 agosto 2021

Cambio

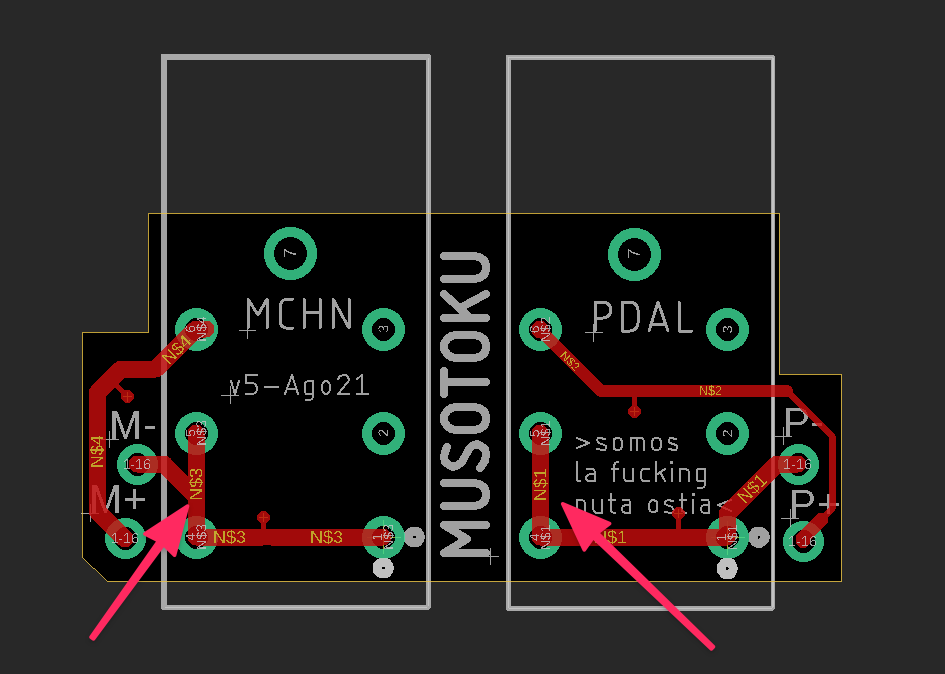
[picture p31: figure]
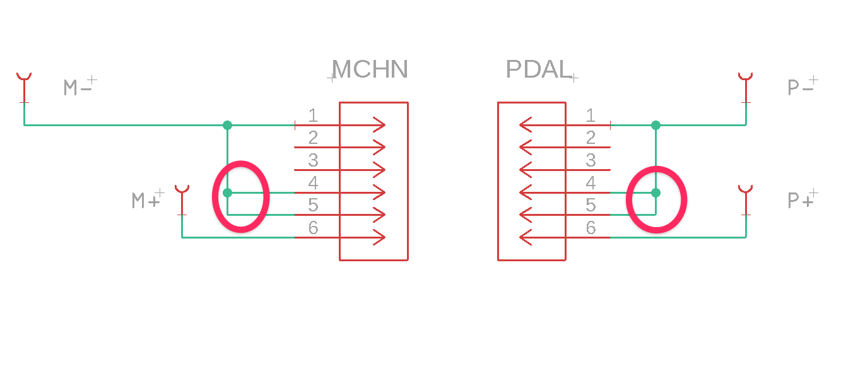
[picture p32: figure]

El GND del jack hace contacto practicamente por proximidad y el ancho del jack va a depender mucho de como de bueno sea el contacto. El pin intermedio de los conectores de audio que hace contacto también en la zona del macho para los conectores mono lo vamos a unir a este punto y así tener una doble conexión
