MSTKMAD/MK1/02.Hardware/MK1-RP2040/02.JACKS_EDCPSU/GERBER v4/Cambios Jack v3 a v4.docx

Cambios PCB JACK – de GERBER v3 a v4

1 marzo 2021

Cambio

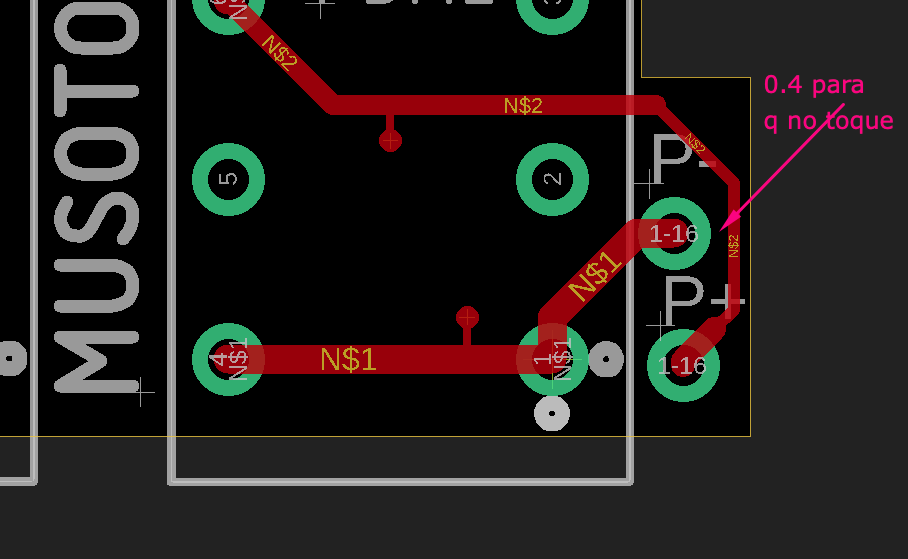
[picture p33: figure]

La fabricación en China da fallos en este punto, hay cortocircuitos de PCB así que se hace la pista más estrecha.
