MSTKMAD/MK1/02.Hardware/MK1-ATMEGA/EDCPSU_DUAL_MSTK_M1/02. JACK_DUAL_M1/HISTORY/v2/HISTORY JACK_DUAL_M2_v3.docx

HISTORY JACK_DUAL_M2

V2 → V3

VERSION
V3 | 16 sept 2021 | Los agujeros de los conectores jack son demasiado pequeños para que pueda entrar el conector. Se cambia el componente para que los taladros sean más grandes.
