MSTKMAD/MK1/(threads)

Thread 1 (2023-12-14):

Fallo del Nitro en los modelos de RP2040.

Jmusotoku, 2023-12-14:
Se observado que en los modelos MK1 y MK2 el Nitro es excesivamente corto (<10ms). AL conectar una maquina en la salida es inapreciable la presencia de dicho NITRO.

Es necesario realizar una modificación en el código para asegurar un mínimo de 200ms en el periodo de arranque.

Jmusotoku, 2023-12-14:
Durante la inspeccion del codigo se descubre que este carece de delay durante la escalera ascendente del NITRO.
Esto puede haber pasado desapercibido en el modelo ATMEGA debido a que la comunicacio I2C y la ejecucion de las instrucciones podian estar durando el tiempo suficiente (~5ms) como para que la escalera fuera observable y nostable.
Al pasar a un uControlador mas rapido, este tiempo se habria reducido drasticamente.

Se decide incluir un delay de 5 ms para recuperar el Nitro Previo.

Jmusotoku, 2023-12-14:
Tras la modificacion y con el testeo sobre maquina se decide aumentar el delay hasta 15ms (aprox) para conseguir que la escalera ascente del Nitro durase un minimo de 200ms y fuese claramente apreciable en el arranque de las maquinas.

Jmusotoku, 2023-12-14:
670cd97033ff4cc34f19513ee4c990023002b1e9

Jmusotoku, 2023-12-14:
Nuevo Nitro para la version RP2040 b8968b4c17f73f6b3615b1d3bd8d975693161ef1

Closed 2024-04-02.

Thread 3 (2024-04-02):

Fallo en MK1 RP2040 Code

Jmusotoku, 2024-04-02:
Debido a un fallo de transcripción de la versión MK2 rp2040, el protección de Undervoltage quedaba supeditada a un sentencia condicional que nunca permitiría que la protección se chequear y por lo tanto nunca salaria.

La solución era la eliminación de la sentencia else del condicional previo.

Solución en commit:
c5dcad650f31a7d970b2462c0603de8243b23b94

Closed 2024-04-02.

Thread 4 (2024-04-09):

Cambio de timing en la proteccion de cortocircuito.

Jmusotoku, 2024-04-09:
Observacion:

Tras la programación, se comprueba que  SOLO entorno a los 3 voltios, la fuenta de cortocircuito. A partir e 3,6v ya no salta el aviso.
Se comprueban y validan los valores softaware sean correctos. Posteriormente se verifica con el voltimetro que la tension en la linea de VOSEN sea correcta, validando asi los valores del divisor de tension.
Posteriormente se conecta el osciloscopio a la linea de VOSEN y se observa que la tension sube realtivamente despacio,

Diagnostico:
La proteccion detecta si la tension no sube por encima de los 2 voltios en menos de 20ms. Debido a la red RC del sensado de la tension de salida, la tension en la linea VOSEN tarda mas de 20ms en subir cuando la tension de salida es menos a 3,5 v aporximadamente, dispartando la proteccion.

Solucion:
La proteccion tiene esa temporalidad derivada de la version de la MK2, donde es necesario que sean valores tan pequeños para prevenir malfuncionamiento en los transistores de la salida. En el caso de la MK1, dichos transistores no estan por lo que es factible aumentar los tiempos de la proteccion y de esta manera no tener que eliminar el consensador de la red de sensado.
Los valores seleecionados son 80ms para el minimo y una ventana de comprobacion de 100ms.

Thread 5 (2024-04-09):

Serigrafia del Pedal Curzada en la EDCPSU

Jmusotoku, 2024-04-09:
Observación:

Al montar la placa de conectores a la EDCPSU, la fuente marca como que la salida esta permanentemente activada.

Diagnostico:

Al seguir la linea y los posibles agentes que activaran la salida se comprueba que proviene de la placa de conectores. Tras timbrar y comprobar que las conexiones de la placa de conectores sea correcta, se pasa a examinar el camino eléctrico de las señales del pedal en la placa EDCPSU. En este punto se verifica que la serigrafia de las conexiones del pedal se encuentran intercambiadas con sus respectivos conectores.

Solucion:

Se recoloca la serigrafia correctamente para que se corresponda con su conector correcto.

Thread 6 (2024-04-09):

La señal PEDAL - de la placa de conectores se encuentra en corto con el chasis

Jmusotoku, 2024-04-09:
Observación:

Investigando el issue #5 se descubre que el chasis se encentra cortocircuitado a la señal P- de la placa de conectores.

Del mismo modo, el chasis se encuentra conectado a la señal GND.

Diagnostico:

Esta situación produce que en el diseño del pedal, la resistencia que une la señal Pedal - con GND, se encuentra cortocircuita y por lo tanto resulta inutilizada.

Solucion:

De momento, se considera un problema endémico y cuya solución no esta clara ser necesaria.
