MSTKMAD/MK1/02.Hardware/MK1-ATMEGA/EDCPSUr8v0/PRINT/BOTTOM.pdf

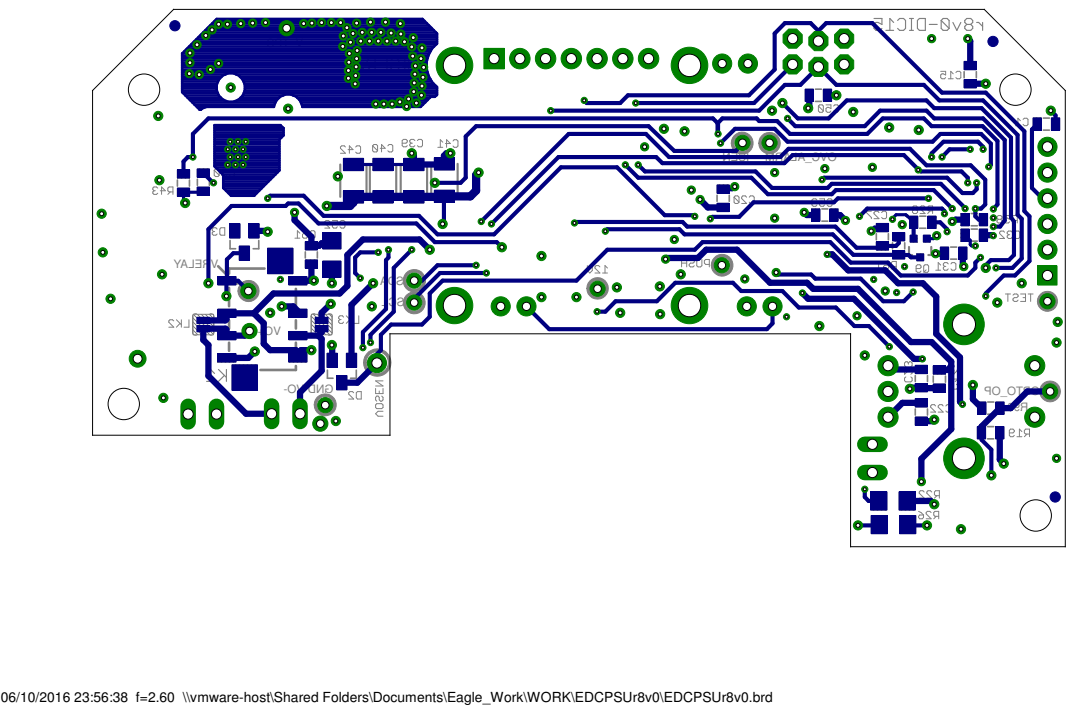
[picture p34: page 1]
V_TPS; GND; SDA; SCL; ISEN; VRELAY; OVC_ALARM OPTO_OP

06/10/2016 23:56:38 f=2.60 \\vmware-host\Shared Folders\Documents\Eagle_Work\WORK\EDCPSUr8v0\EDCPSUr8v0.brd
