MSTKMAD/MK1/02.Hardware/MK1-ATMEGA/EDCPSUr8v0/PRINT/GND.pdf

+

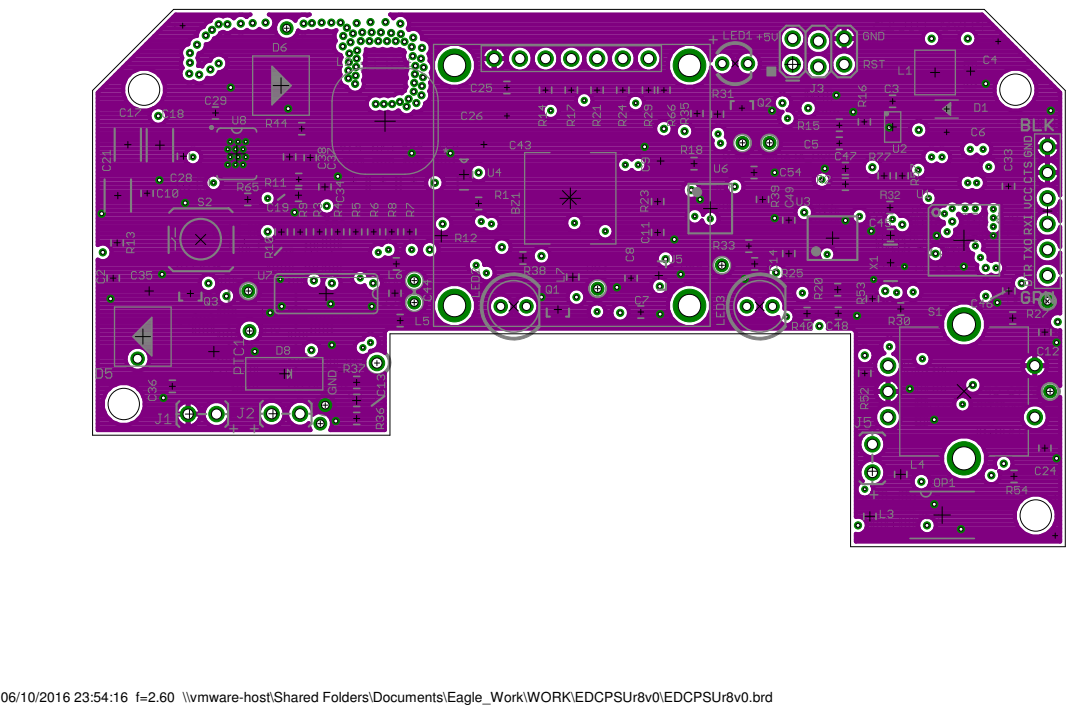
[picture p35: page 1]
GND OPTO_OP

06/10/2016 23:54:16 f=2.60 \\vmware-host\Shared Folders\Documents\Eagle_Work\WORK\EDCPSUr8v0\EDCPSUr8v0.brd
