MSTKMAD/MK1/02.Hardware/MK1-ATMEGA/EDCPSUr8v0/PRINT/POWER.pdf

+

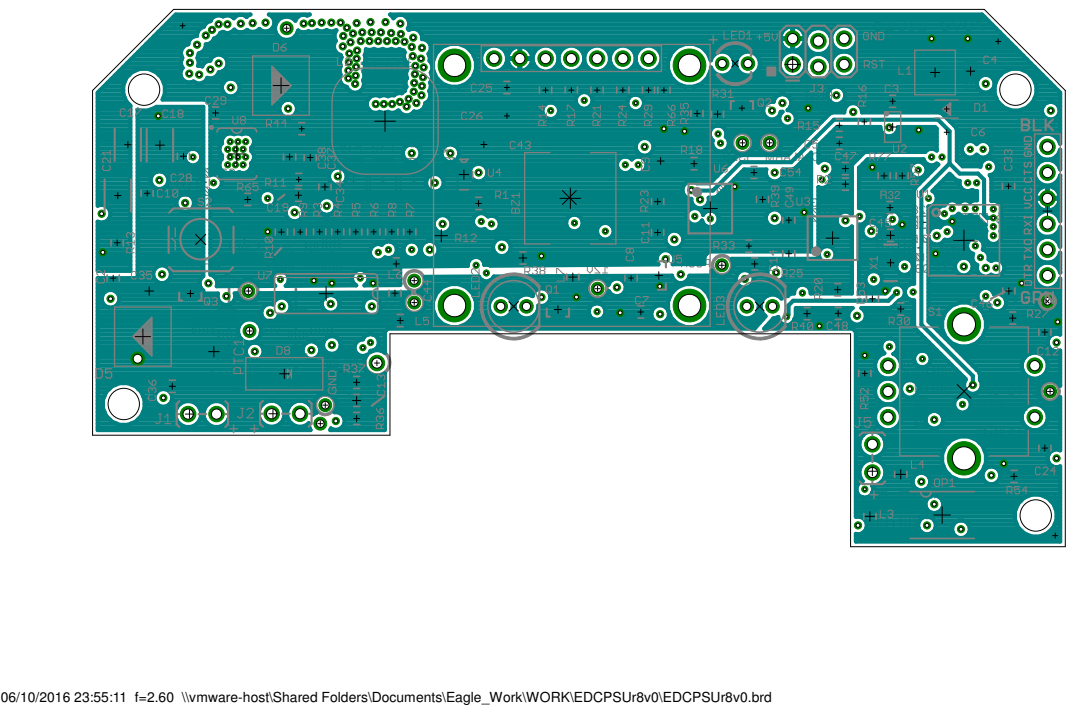
[picture p36: page 1]
GND OPTO_OP

06/10/2016 23:55:11 f=2.60 \\vmware-host\Shared Folders\Documents\Eagle_Work\WORK\EDCPSUr8v0\EDCPSUr8v0.brd
