MSTKMAD/MK1/02.Hardware/MK1-ATMEGA/EDCPSUr8v0/PRINT/TOP.pdf

+

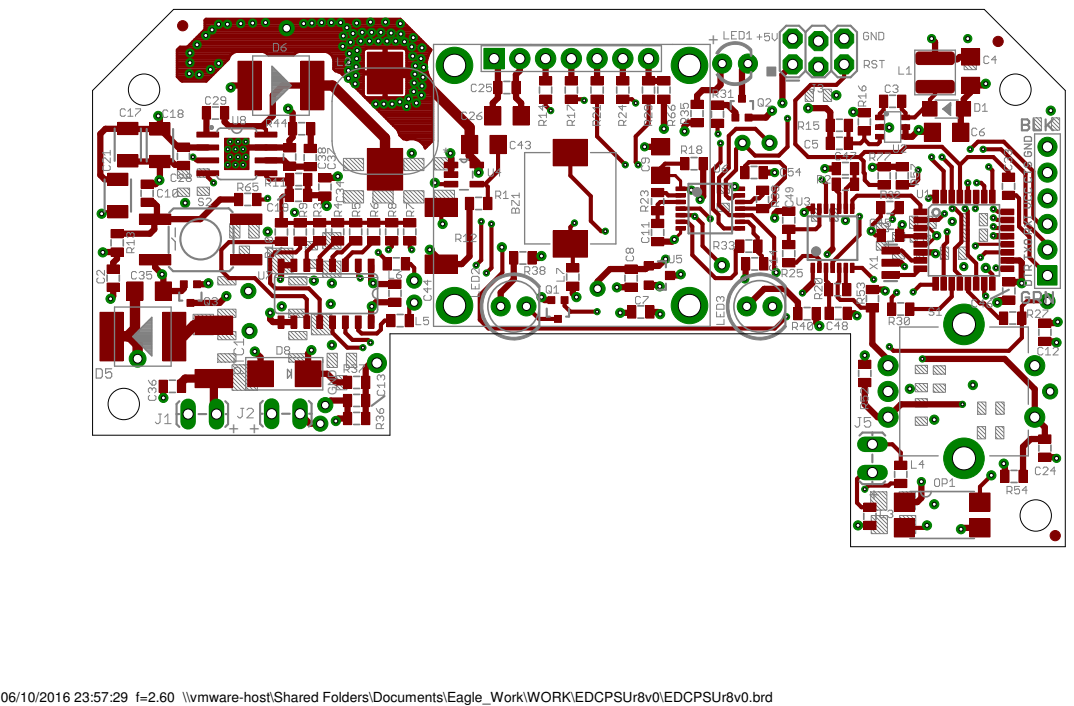
[picture p37: page 1]
GND

06/10/2016 23:57:29 f=2.60 \\vmware-host\Shared Folders\Documents\Eagle_Work\WORK\EDCPSUr8v0\EDCPSUr8v0.brd
