MSTKMAD/MK1/02.Hardware/MK1-ATMEGA/EDCPSUr8v0/PRINT/Schematic EDCPSUr8v0.pdf

# DIGITAL LDO + ROUTING + ISENSING

# EDCPSU r7V0

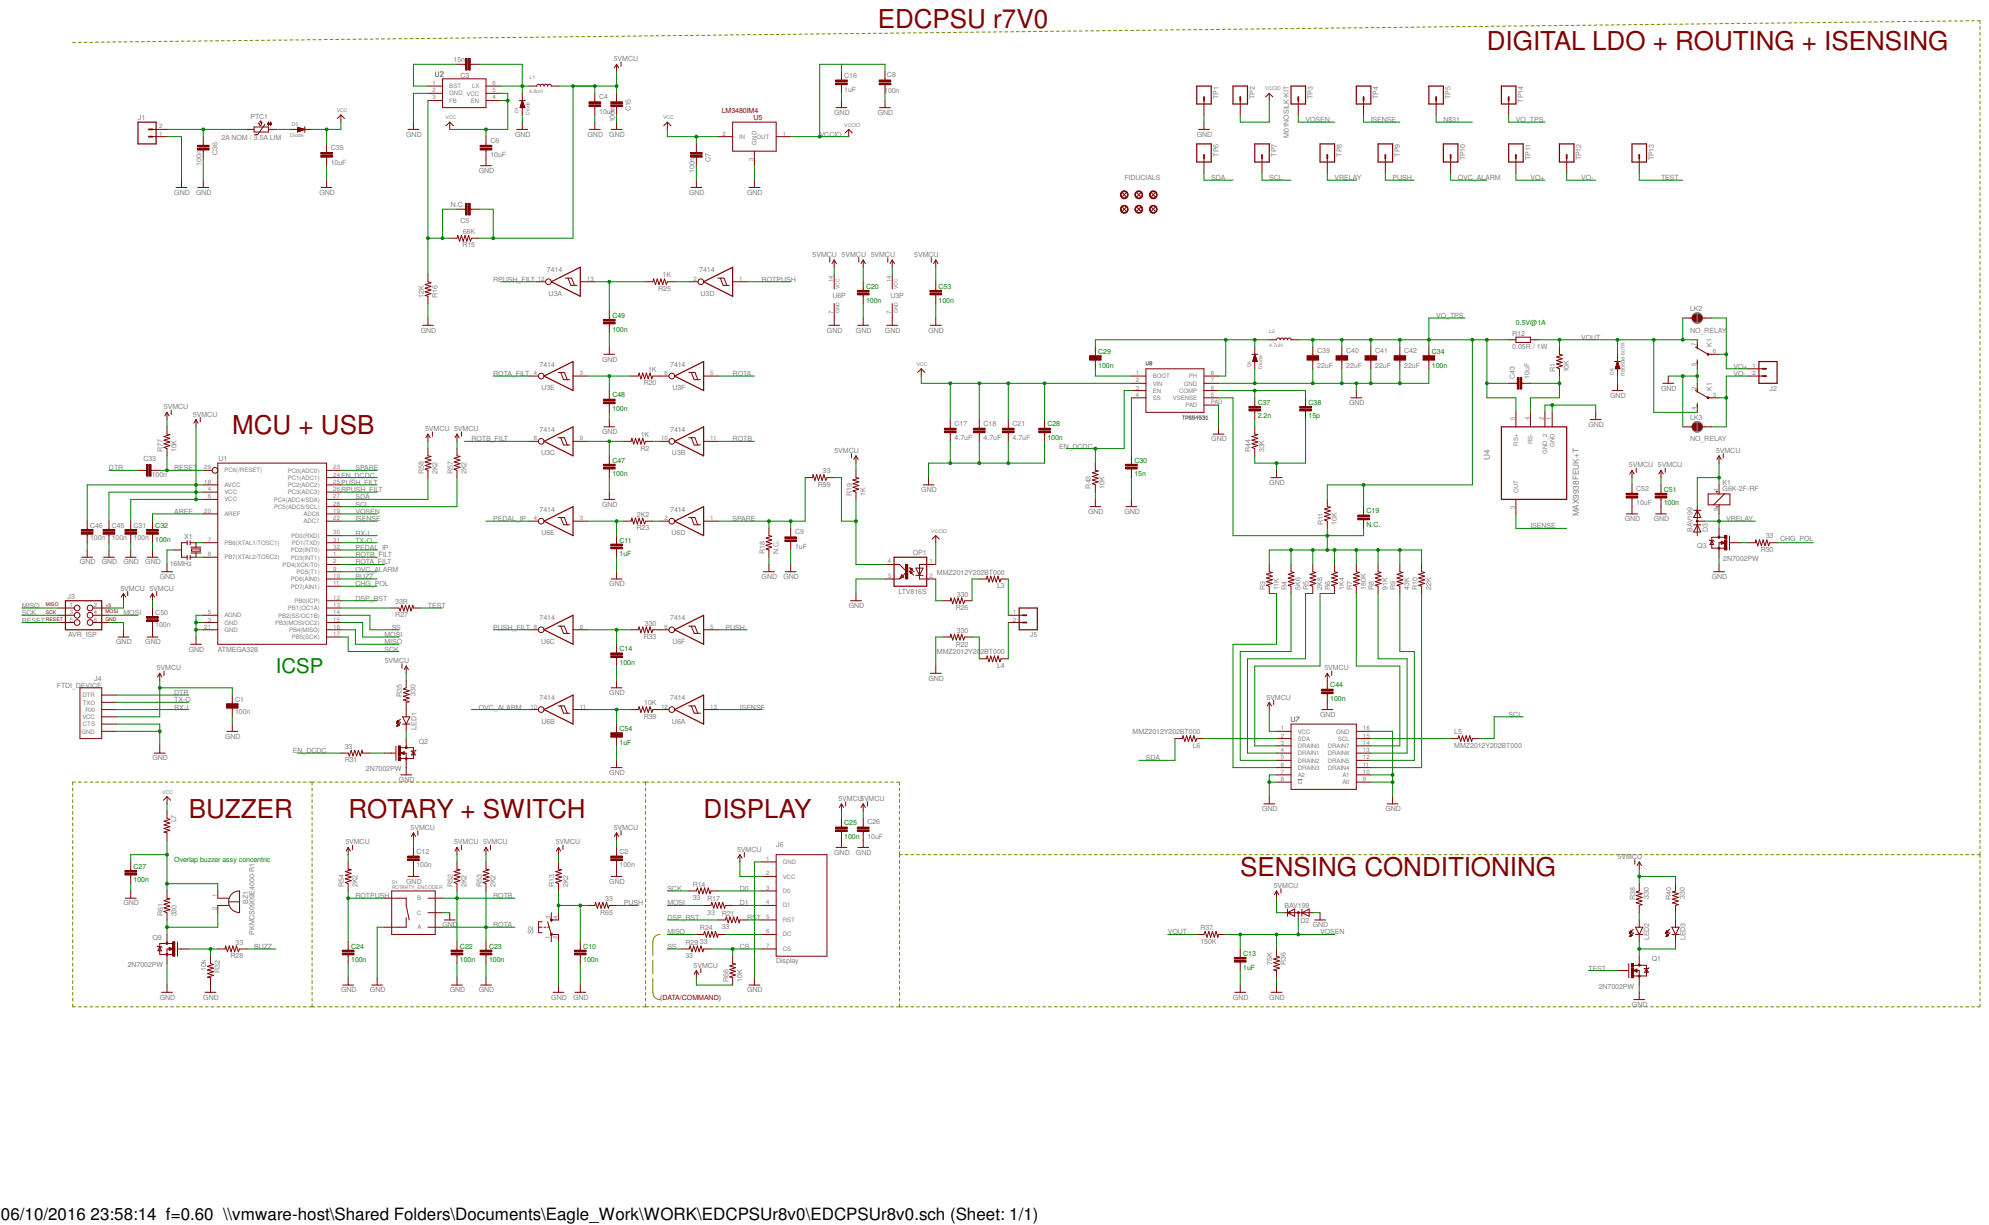
[picture p38: page 1]

AREF | AREF 20 | SCL

VCC 6 | SDA

Overlap buzzer assy concentric

06/10/2016 23:58:14 f=0.60 \\vmware-host\Shared Folders\Documents\Eagle_Work\WORK\EDCPSUr8v0\EDCPSUr8v0.sch (Sheet: 1/1)
