MSTKMAD/MK1/02.Hardware/MK1-ATMEGA/EDCPSU_DUAL_MSTK_M1/00. DUAL M1 MSTK PANEL/MANUFACTURING FILES PCBWAY/W29700AXK47 panel files.pdf

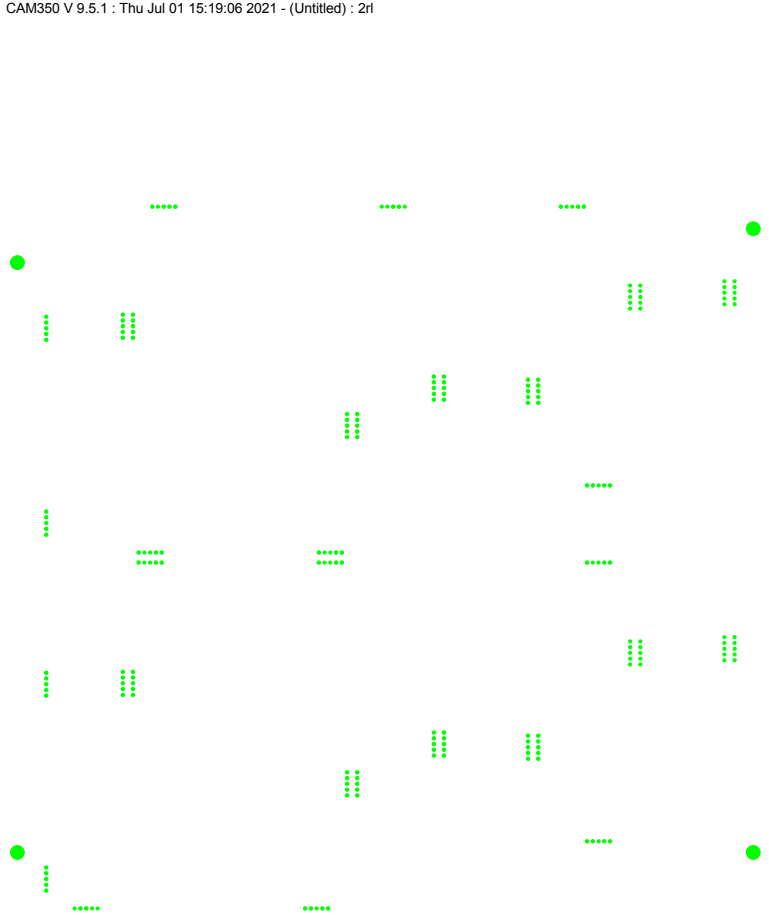
[picture p39: page 1]

CAM350 V 9.5.1 : Thu Jul 01 15:19:06 2021 - (Untitled) : 2rl

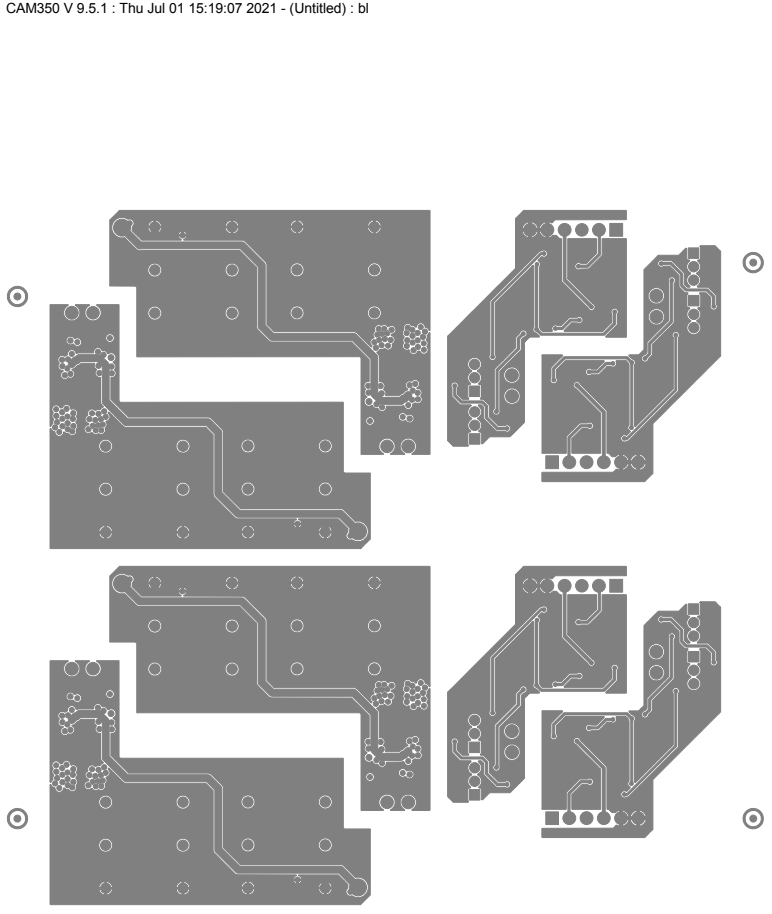
[picture p40: page 2]

CAM350 V 9.5.1 : Thu Jul 01 15:19:07 2021 - (Untitled) : bl

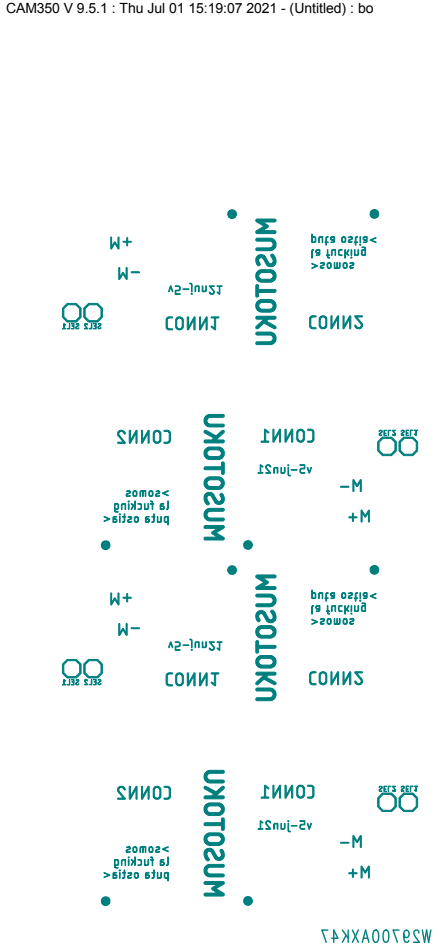
[picture p41: page 3]

CAM350 V 9.5.1 : Thu Jul 01 15:19:07 2021 - (Untitled) : bo

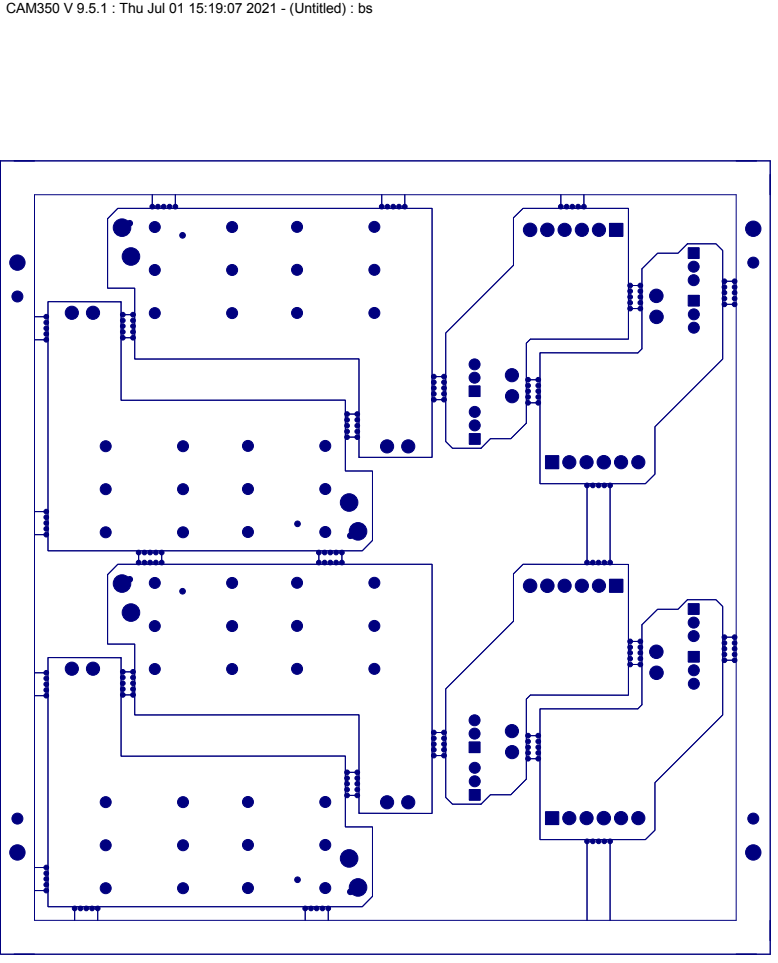
[picture p42: page 4]

CAM350 V 9.5.1 : Thu Jul 01 15:19:07 2021 - (Untitled) : bs

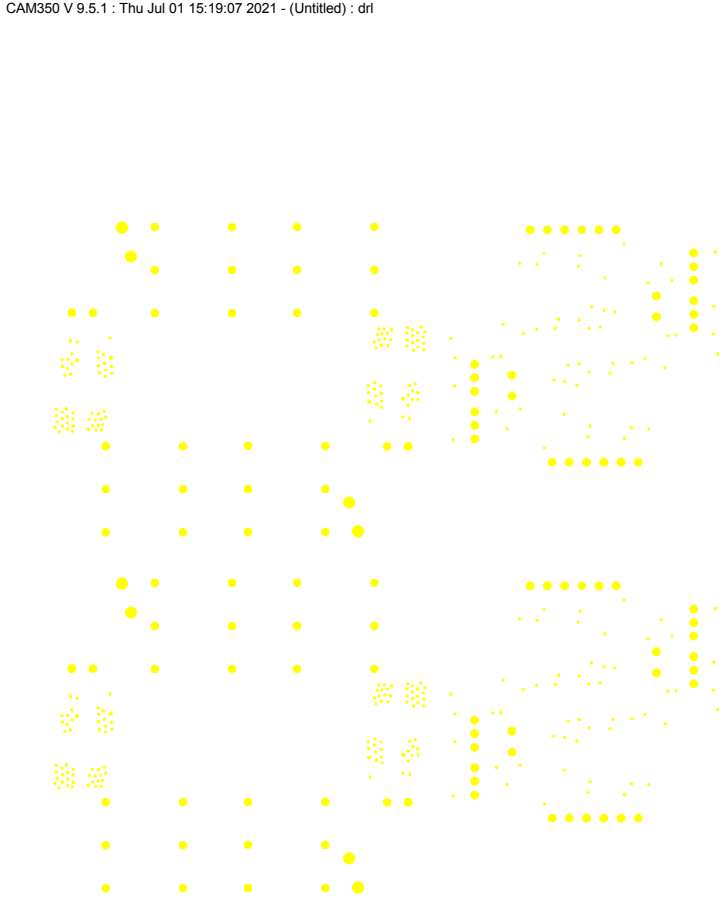
[picture p43: page 5]

CAM350 V 9.5.1 : Thu Jul 01 15:19:07 2021 - (Untitled) : drl

CAM350 V 9.5.1 : Thu Jul 01 15:19:07 2021 - (Untitled) : gtp

CAM350 V 9.5.1 : Thu Jul 01 15:19:07 2021 - (Untitled) : ko

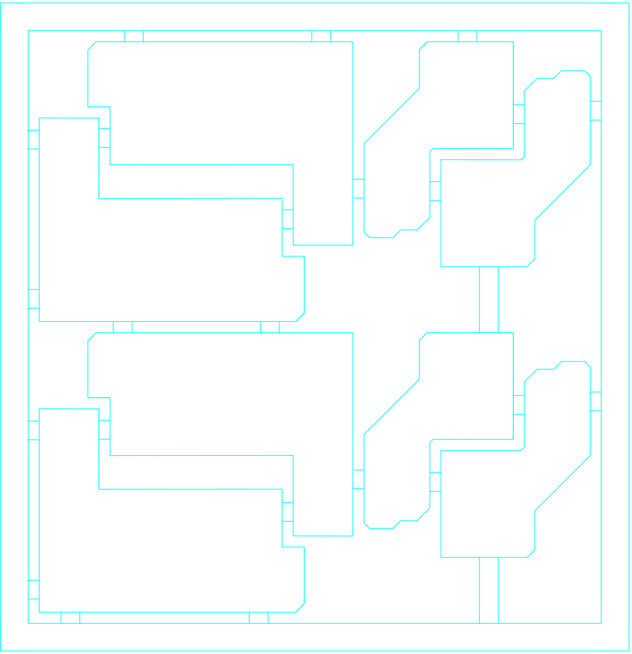
[picture p44: figure]
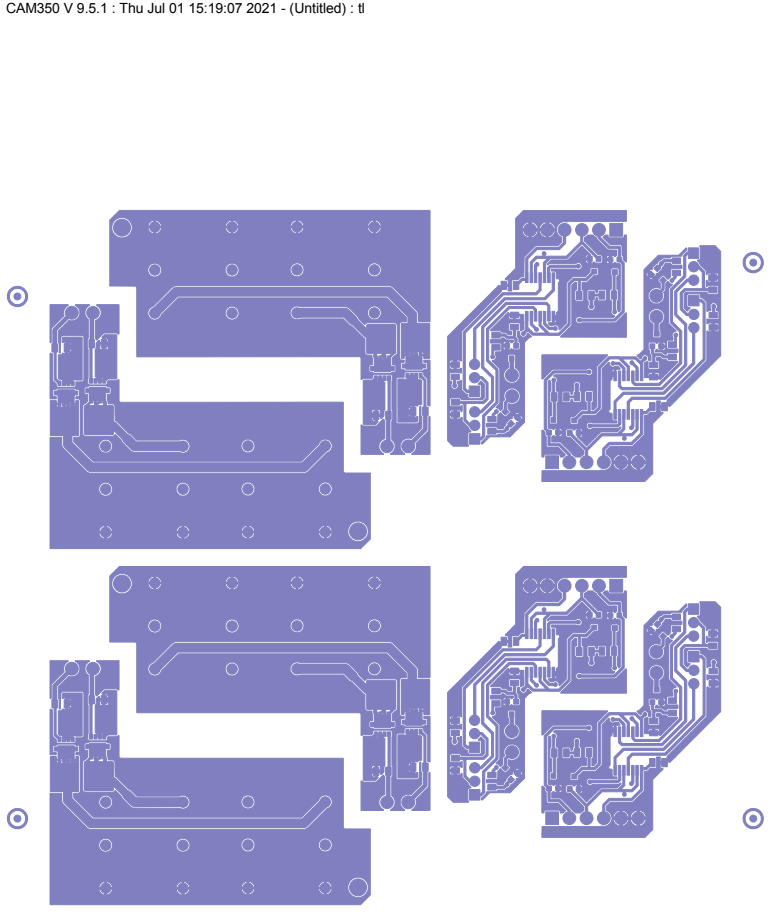
[picture p45: page 8]

CAM350 V 9.5.1 : Thu Jul 01 15:19:07 2021 - (Untitled) : tl

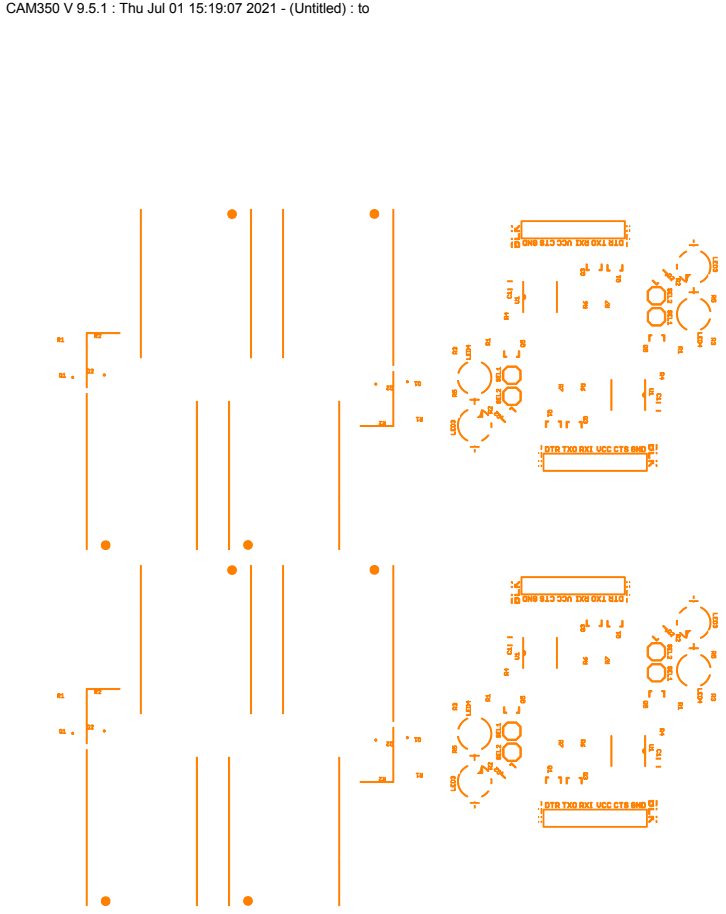
[picture p46: page 9]

CAM350 V 9.5.1 : Thu Jul 01 15:19:07 2021 - (Untitled) : to

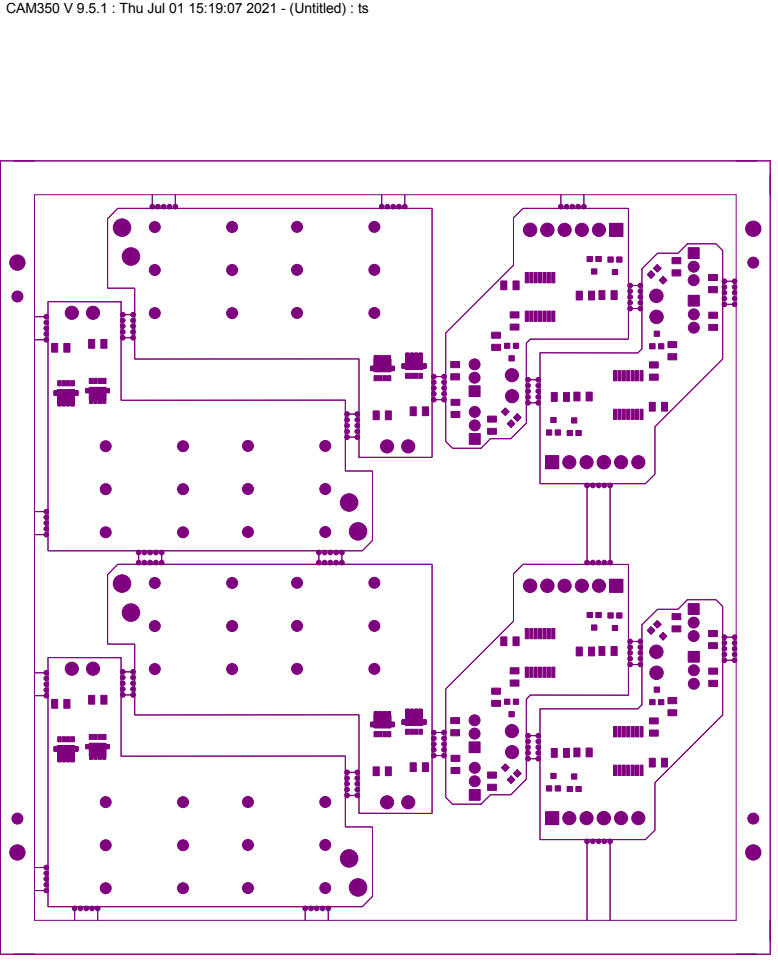
[picture p47: page 10]

CAM350 V 9.5.1 : Thu Jul 01 15:19:07 2021 - (Untitled) : ts
