MSTKMAD/MK1/02.Hardware/MK1-RP2040/02.JACKS_EDCPSU/GERBER v4/panel design.pdf

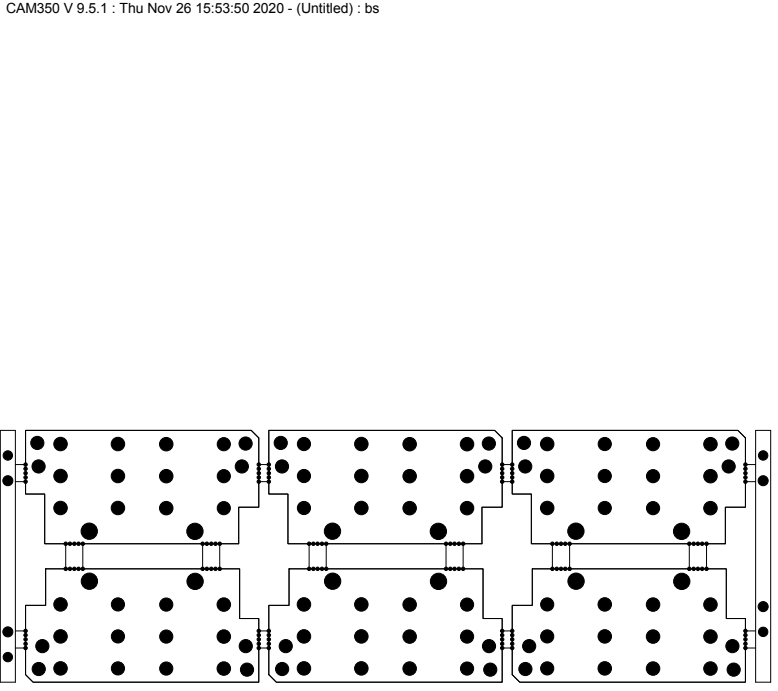
[picture p48: page 1]

CAM350 V 9.5.1 : Thu Nov 26 15:53:50 2020 - (Untitled) : bs
