MSTKMAD/MK1/02.Hardware/MK1-RP2040/02.JACKS_EDCPSU/GERBER v4/W29700AXJ29/PDF.pdf

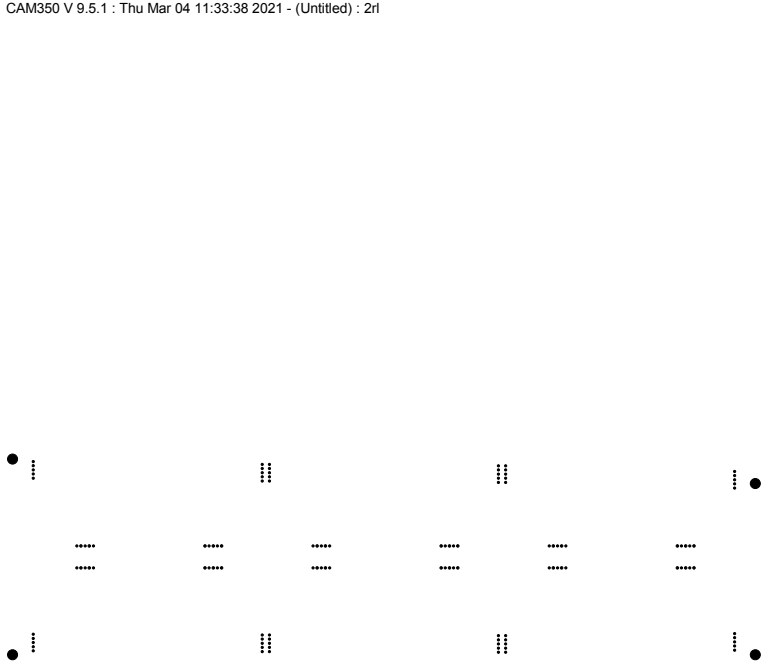
[picture p49: page 1]

CAM350 V 9.5.1 : Thu Mar 04 11:33:38 2021 - (Untitled) : 2rl

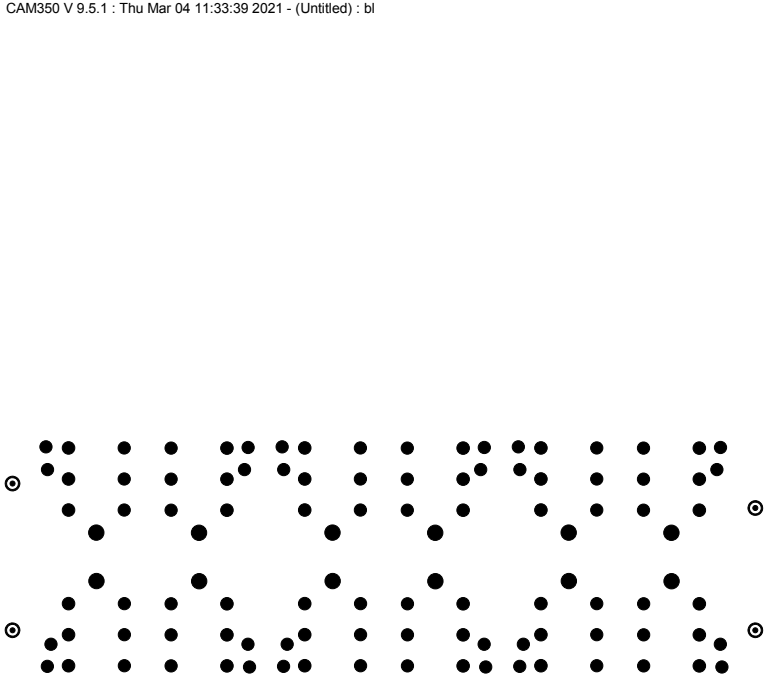
[picture p50: page 2]

CAM350 V 9.5.1 : Thu Mar 04 11:33:39 2021 - (Untitled) : bl

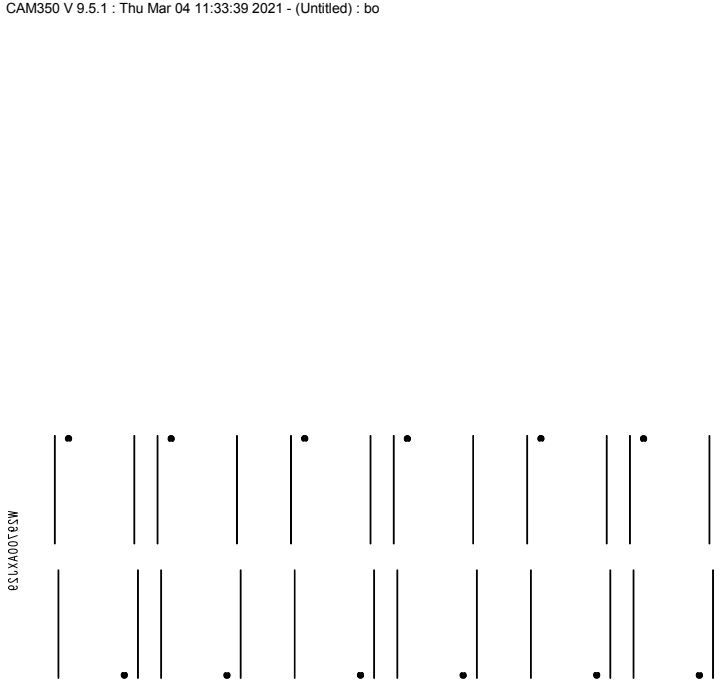
[picture p51: page 3]

CAM350 V 9.5.1 : Thu Mar 04 11:33:39 2021 - (Untitled) : bo

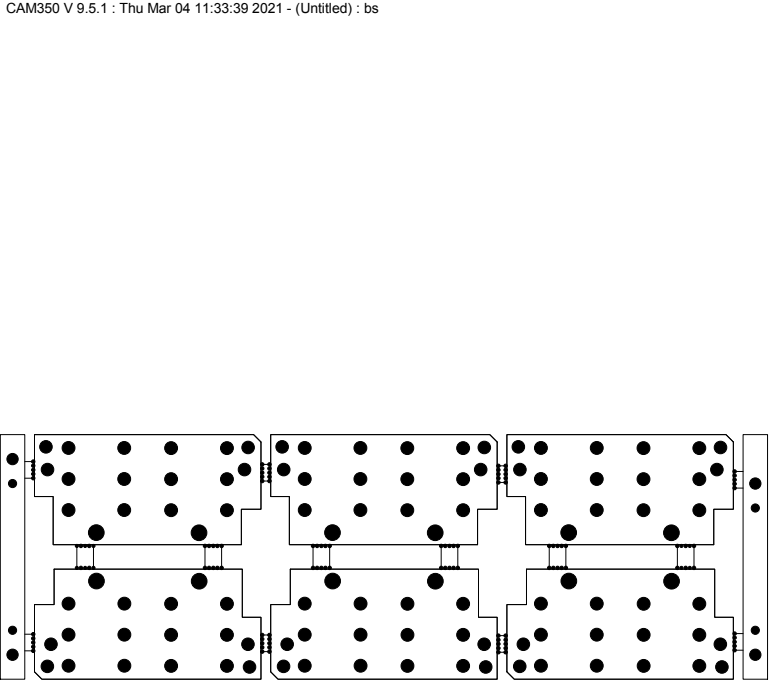
[picture p52: page 4]

CAM350 V 9.5.1 : Thu Mar 04 11:33:39 2021 - (Untitled) : bs

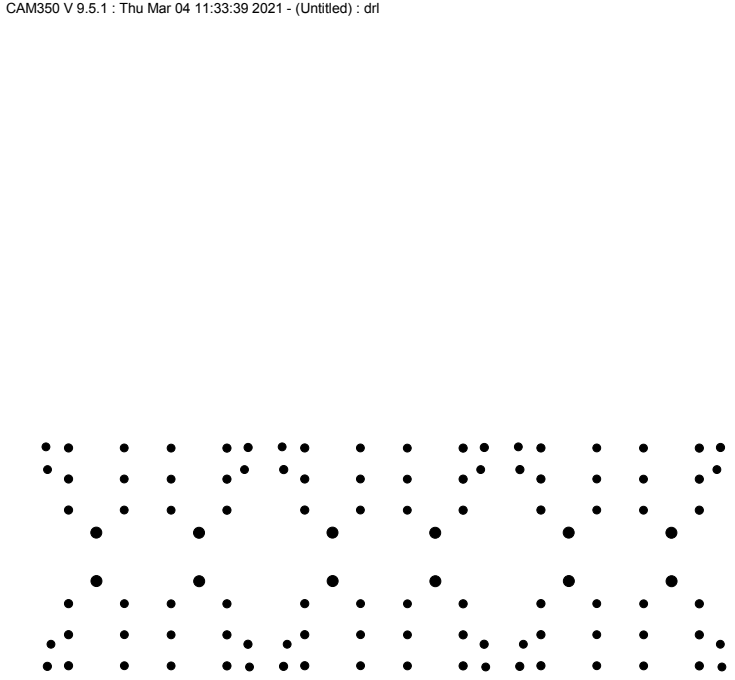
[picture p53: page 5]

CAM350 V 9.5.1 : Thu Mar 04 11:33:39 2021 - (Untitled) : drl

CAM350 V 9.5.1 : Thu Mar 04 11:33:39 2021 - (Untitled) : ko

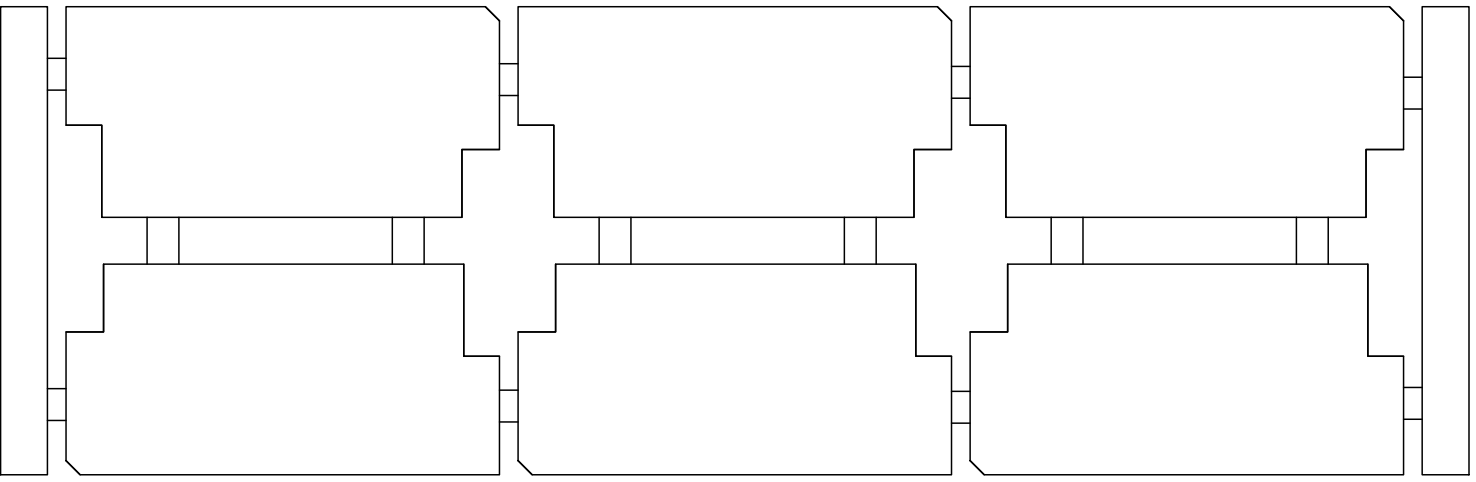
[picture p54: figure]
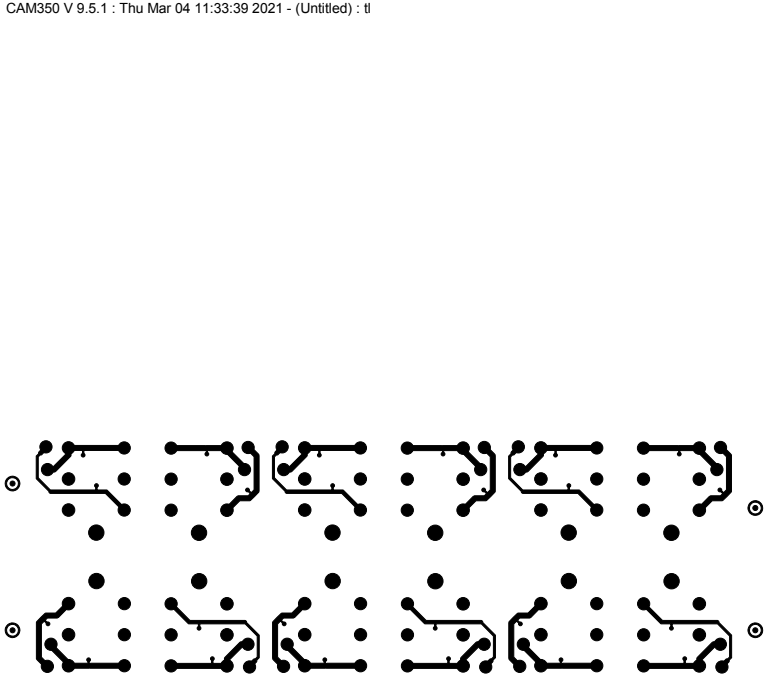
[picture p55: page 7]

CAM350 V 9.5.1 : Thu Mar 04 11:33:39 2021 - (Untitled) : tl

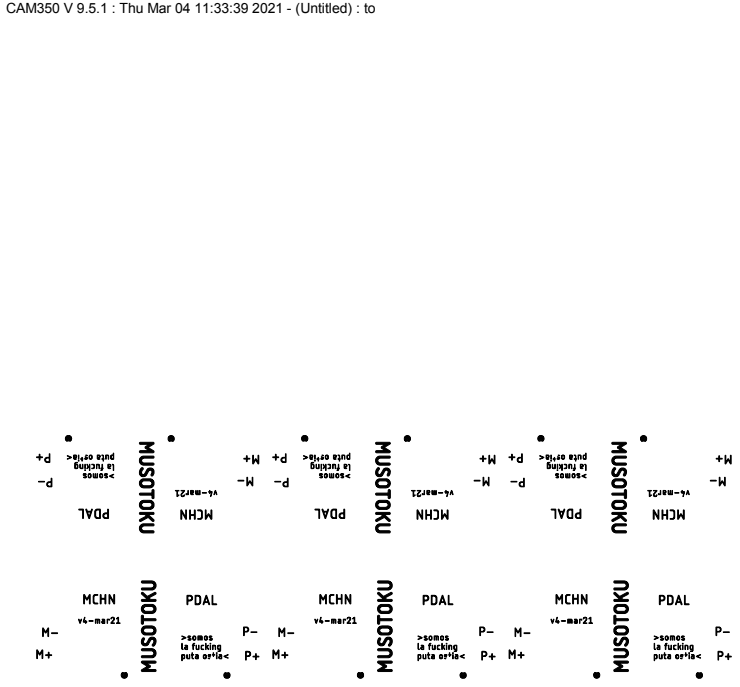
[picture p56: page 8]

CAM350 V 9.5.1 : Thu Mar 04 11:33:39 2021 - (Untitled) : to

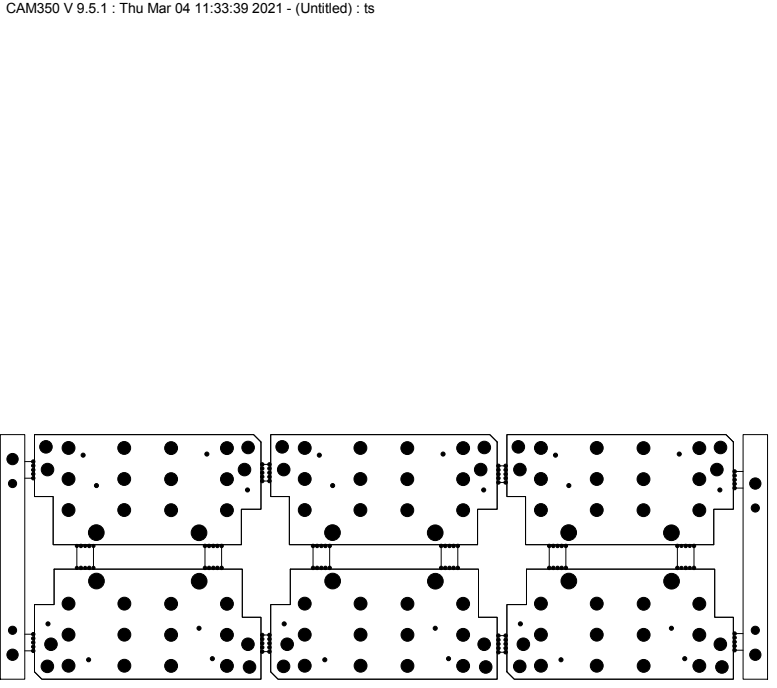
[picture p57: page 9]

CAM350 V 9.5.1 : Thu Mar 04 11:33:39 2021 - (Untitled) : ts
