MSTKMAD/MK1/02.Hardware/MK1-RP2040/02.JACKS_EDCPSU/GERBER v3/PANEL PCBWAY/Panel de pcbway. W29700AXJ25/pdf.pdf

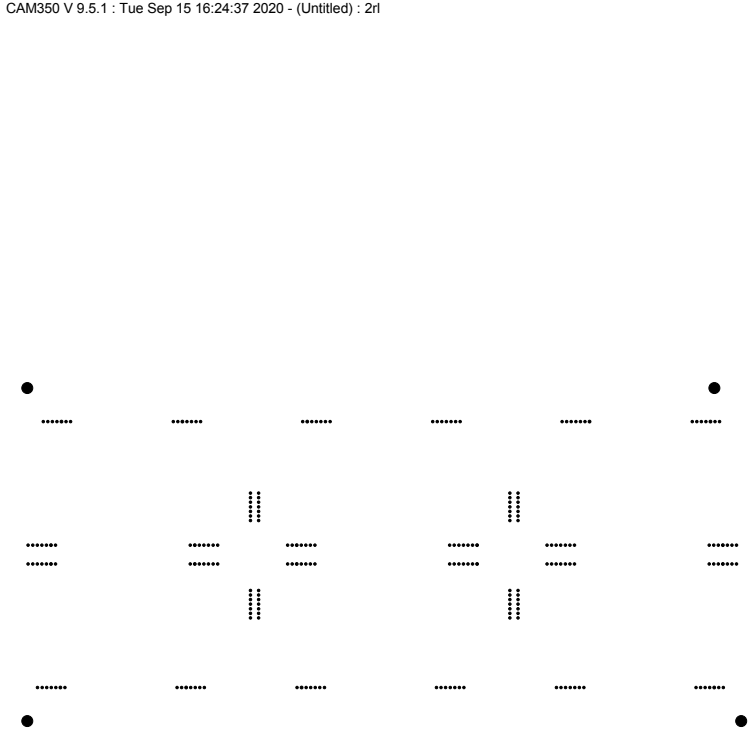
[picture p58: page 1]

CAM350 V 9.5.1 : Tue Sep 15 16:24:37 2020 - (Untitled) : 2rl

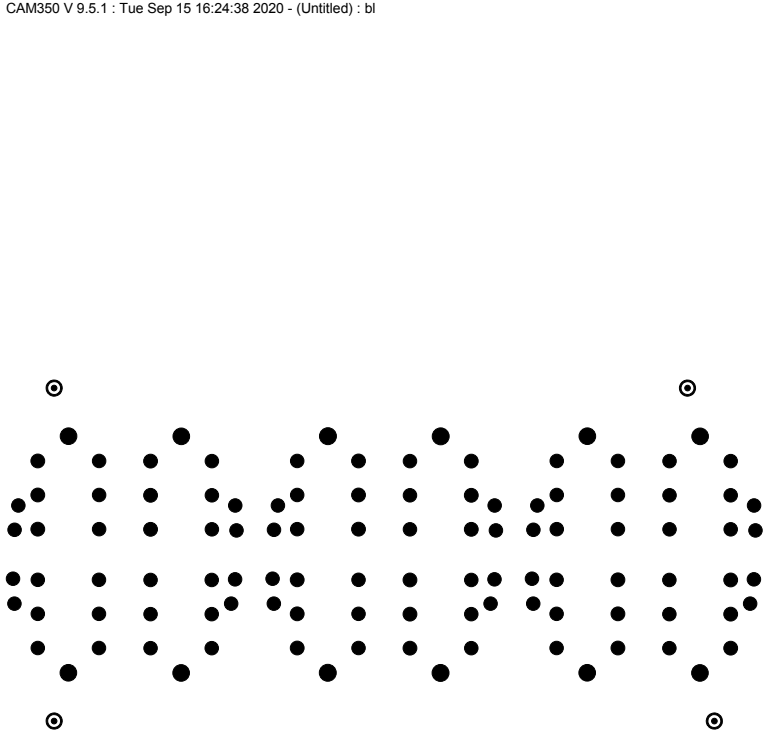
[picture p59: page 2]

CAM350 V 9.5.1 : Tue Sep 15 16:24:38 2020 - (Untitled) : bl

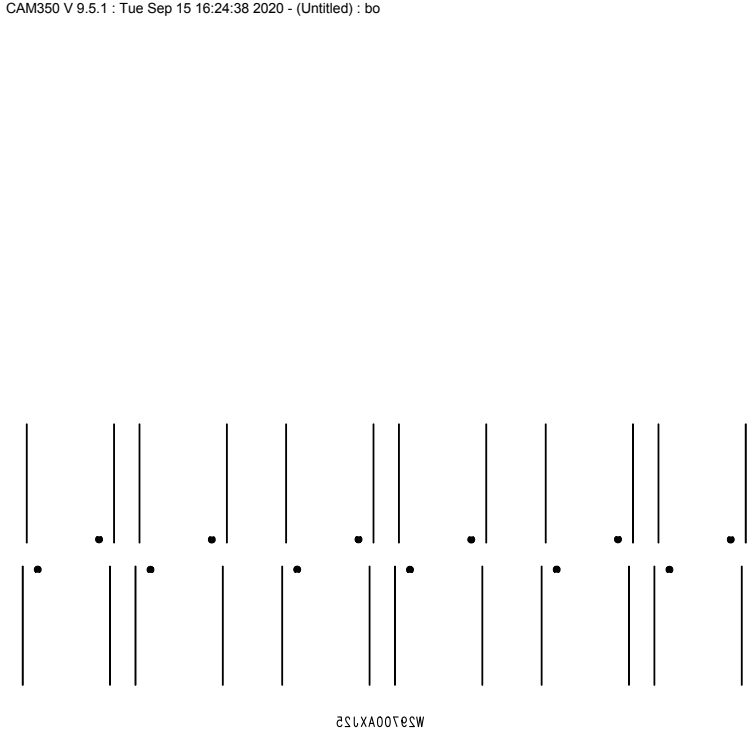
[picture p60: page 3]

CAM350 V 9.5.1 : Tue Sep 15 16:24:38 2020 - (Untitled) : bo

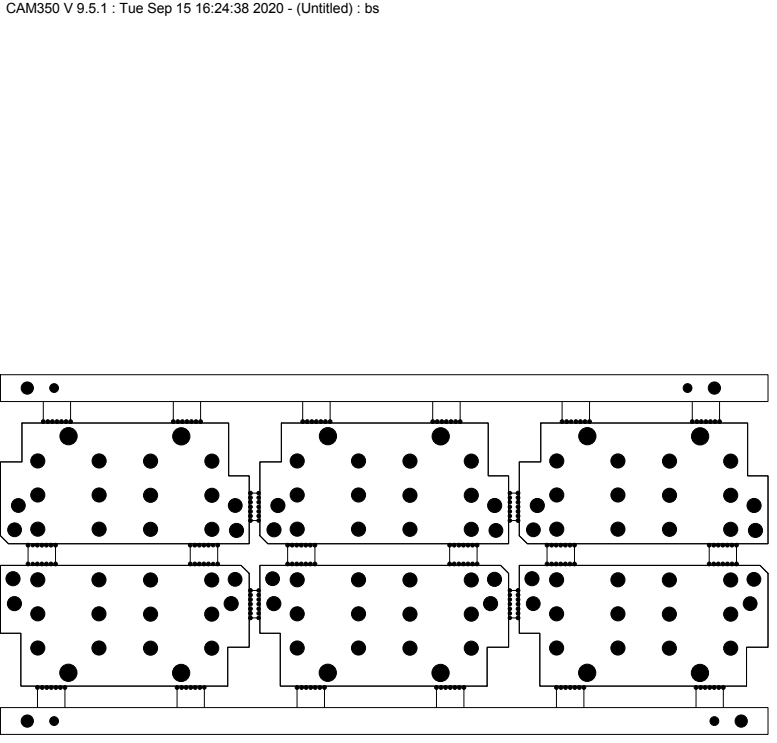
[picture p61: page 4]

CAM350 V 9.5.1 : Tue Sep 15 16:24:38 2020 - (Untitled) : bs

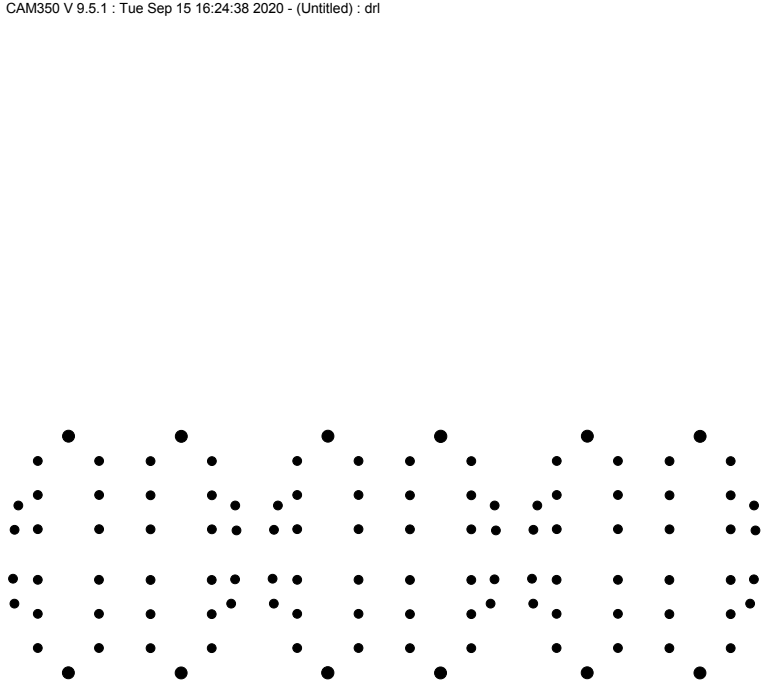
[picture p62: page 5]

CAM350 V 9.5.1 : Tue Sep 15 16:24:38 2020 - (Untitled) : drl

CAM350 V 9.5.1 : Tue Sep 15 16:24:38 2020 - (Untitled) : ko

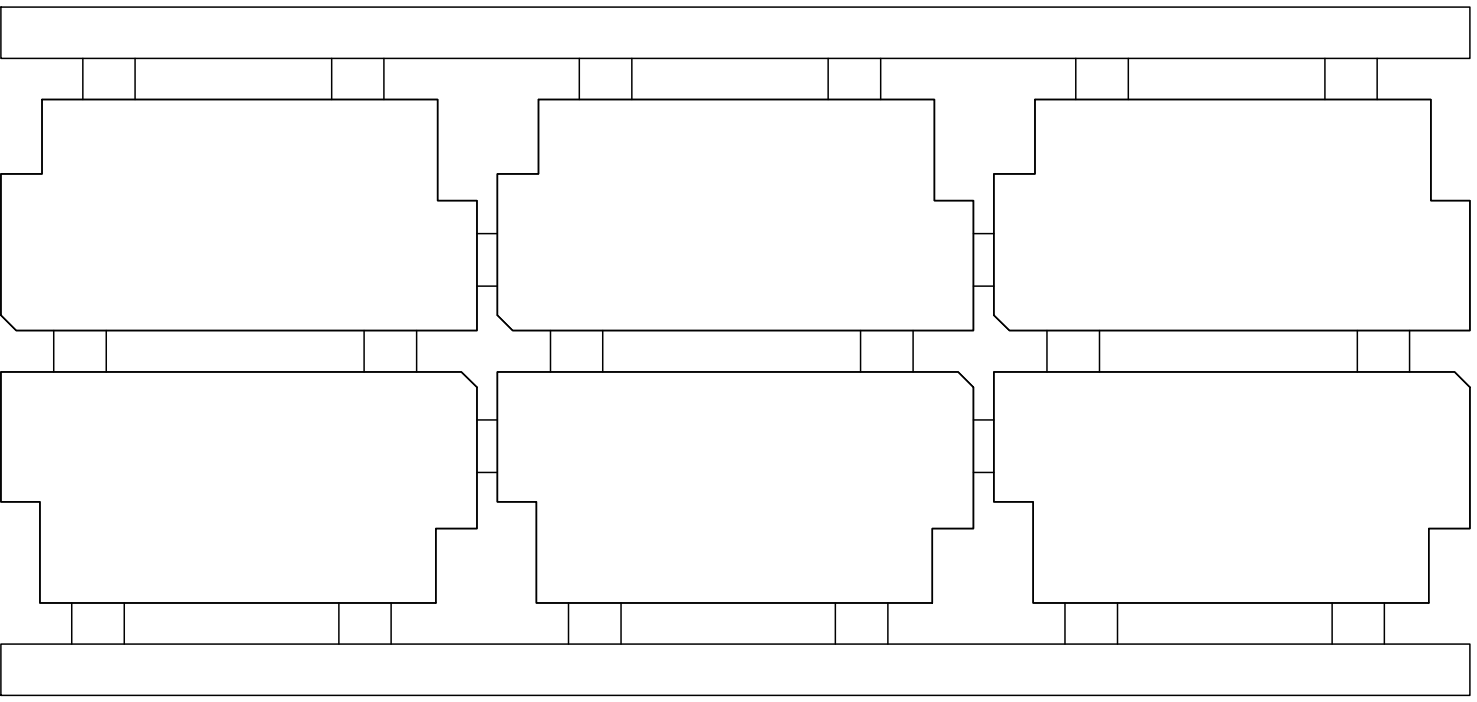
[picture p63: figure]
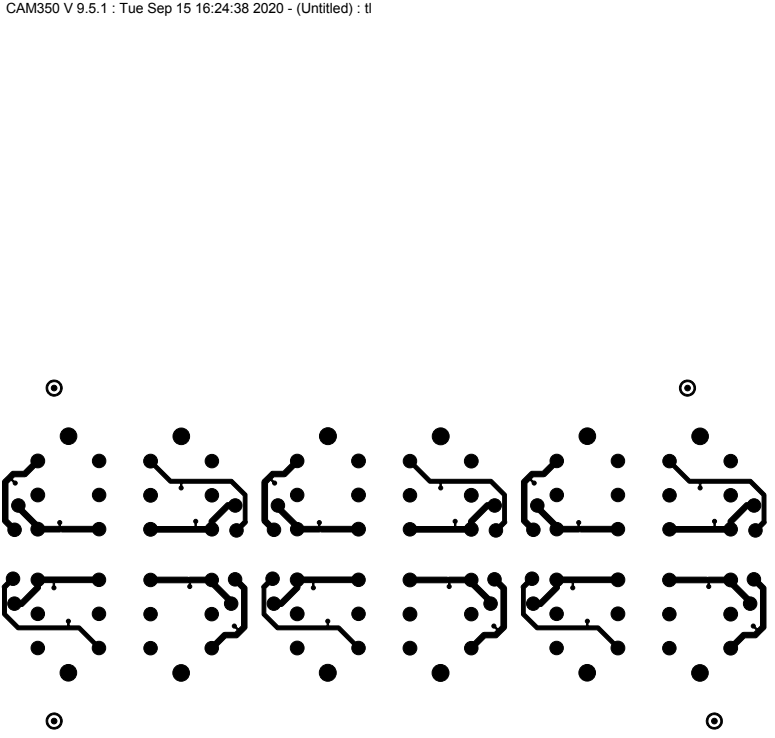
[picture p64: page 7]

CAM350 V 9.5.1 : Tue Sep 15 16:24:38 2020 - (Untitled) : tl

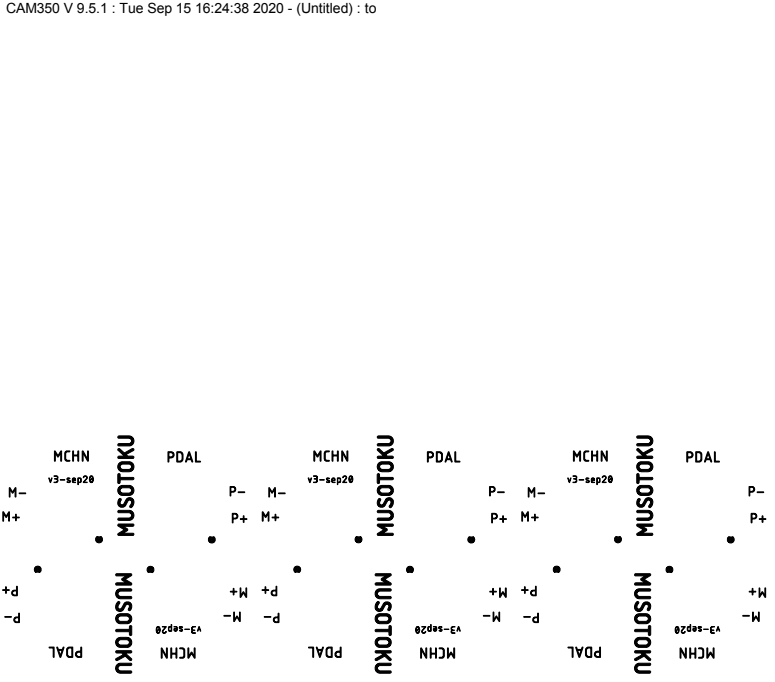
[picture p65: page 8]

CAM350 V 9.5.1 : Tue Sep 15 16:24:38 2020 - (Untitled) : to

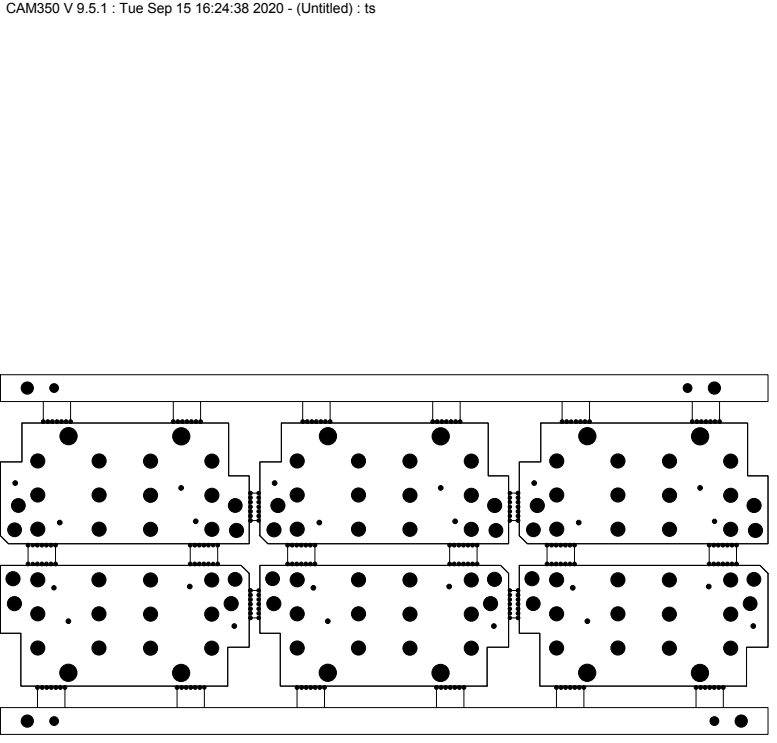
[picture p66: page 9]

CAM350 V 9.5.1 : Tue Sep 15 16:24:38 2020 - (Untitled) : ts
