MSTKMAD/MK1/02.Hardware/MK1-RP2040/01.EDCPSU/EDCPSUMK1-RP2040.brd

## EAGLE design 02.Hardware/MK1-RP2040/01.EDCPSU/EDCPSUMK1-RP2040.brd (2026-01-16)

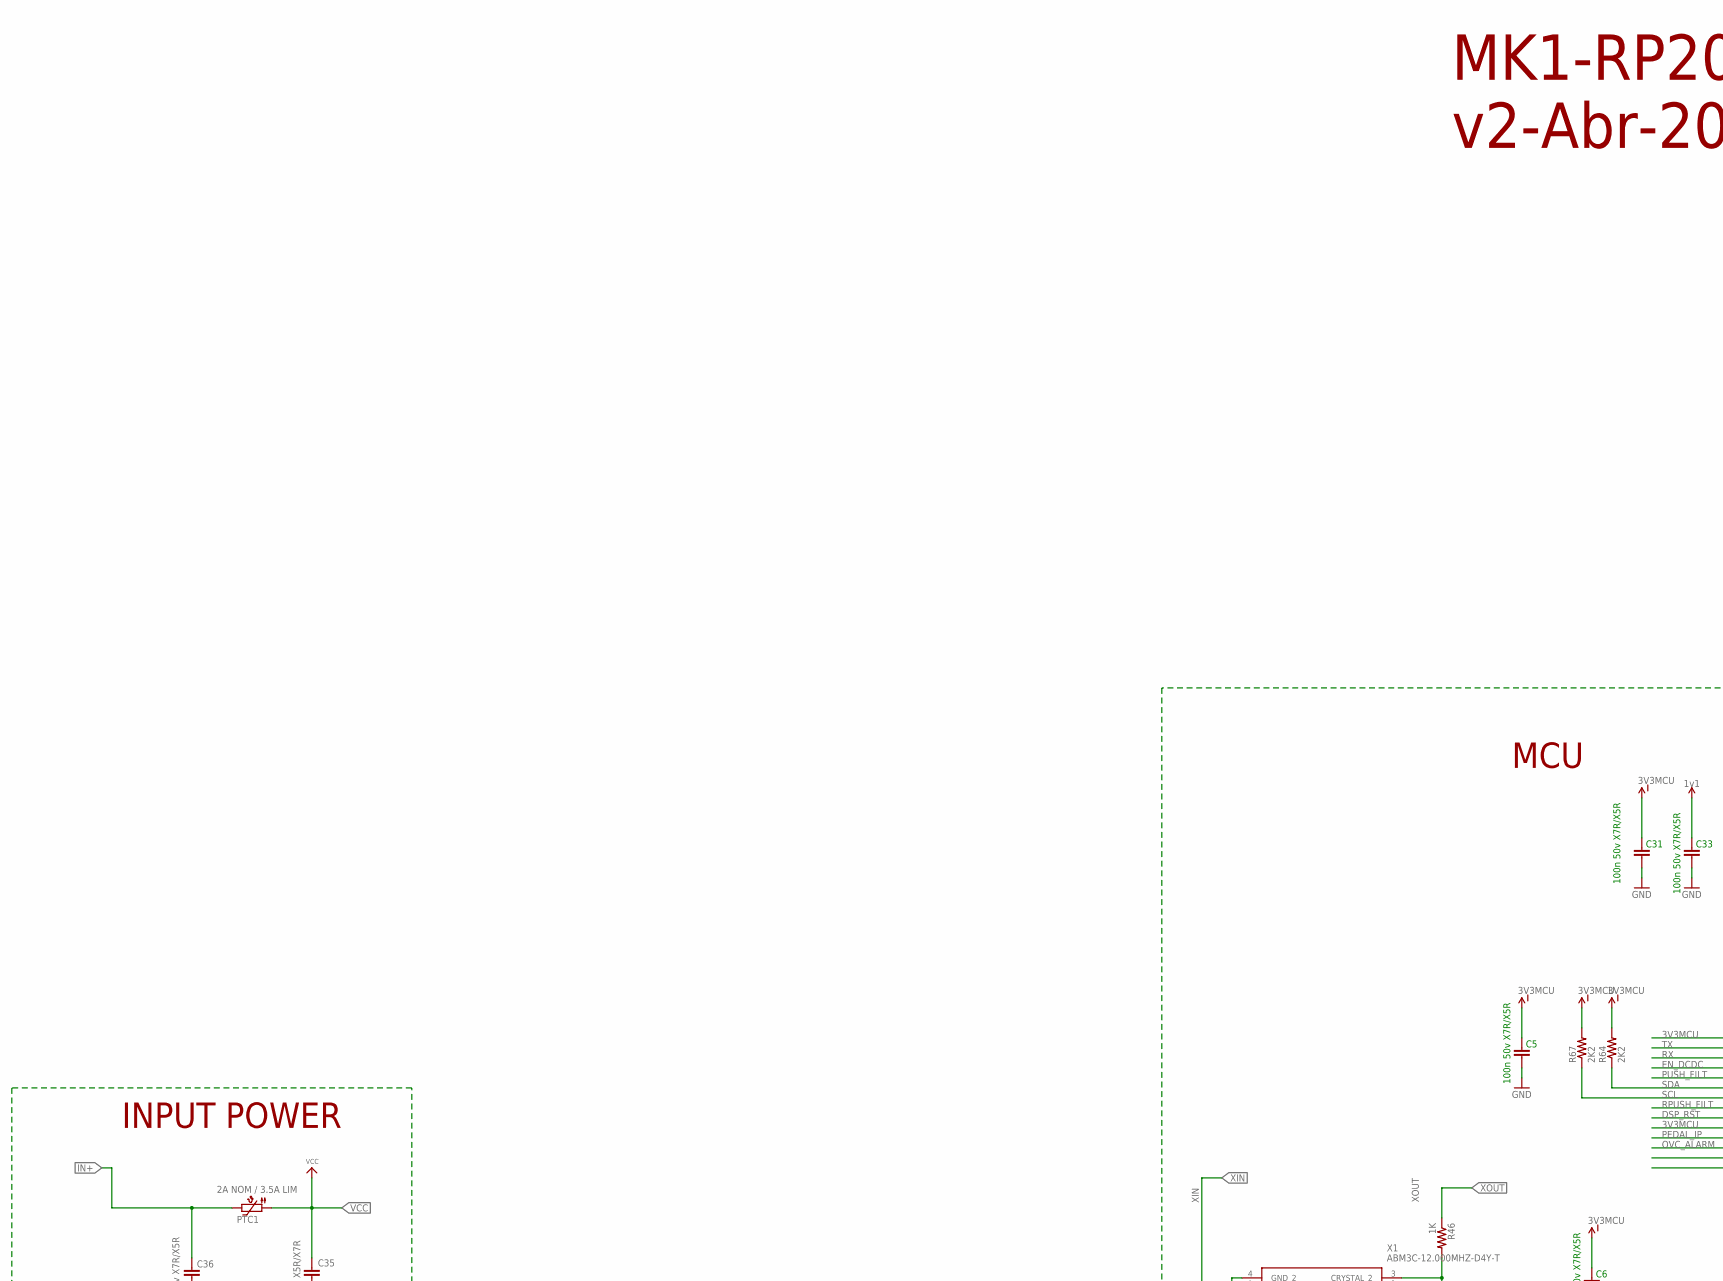
[picture p67: schematic EDCPSUMK1-RP2040.sch, part in row 1, column 1]

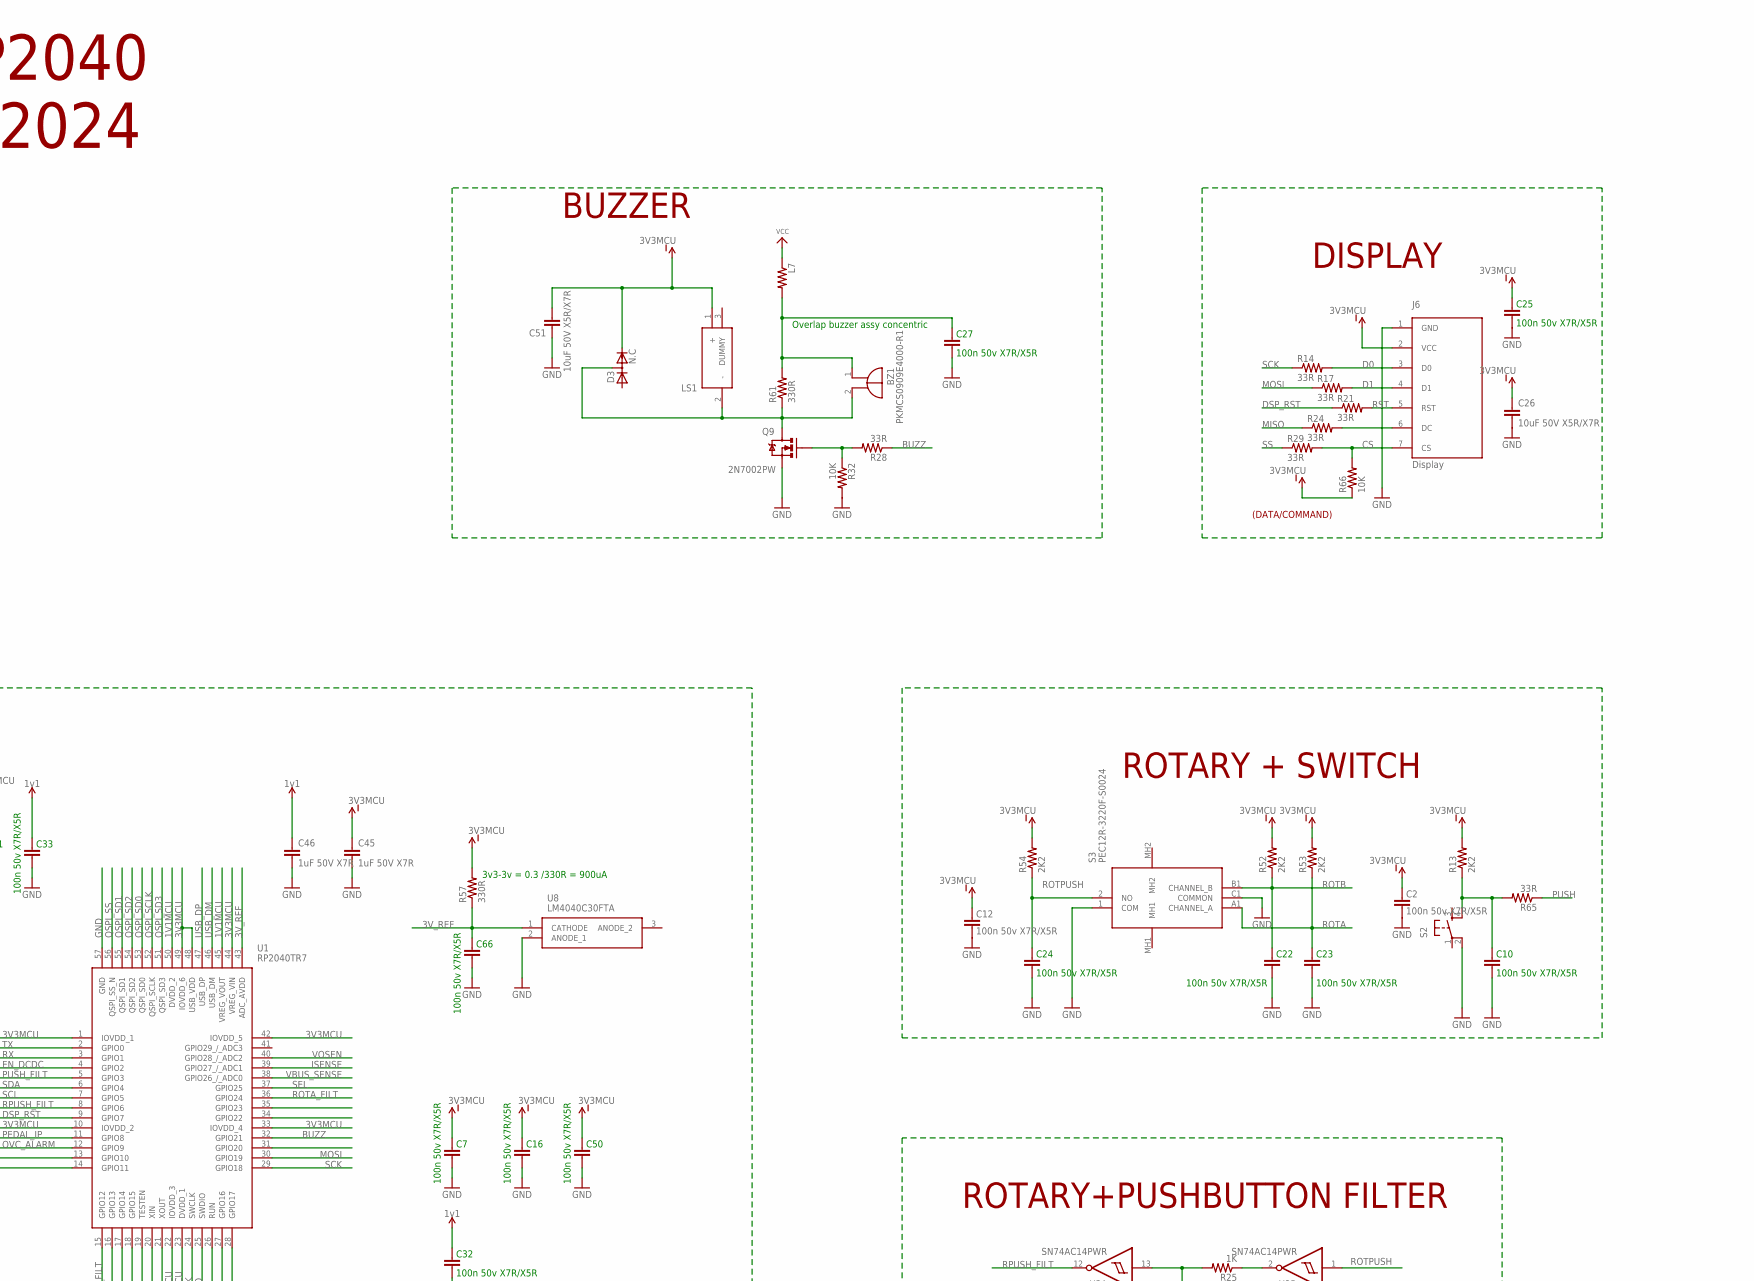
[picture p68: schematic EDCPSUMK1-RP2040.sch, part in row 1, column 2]

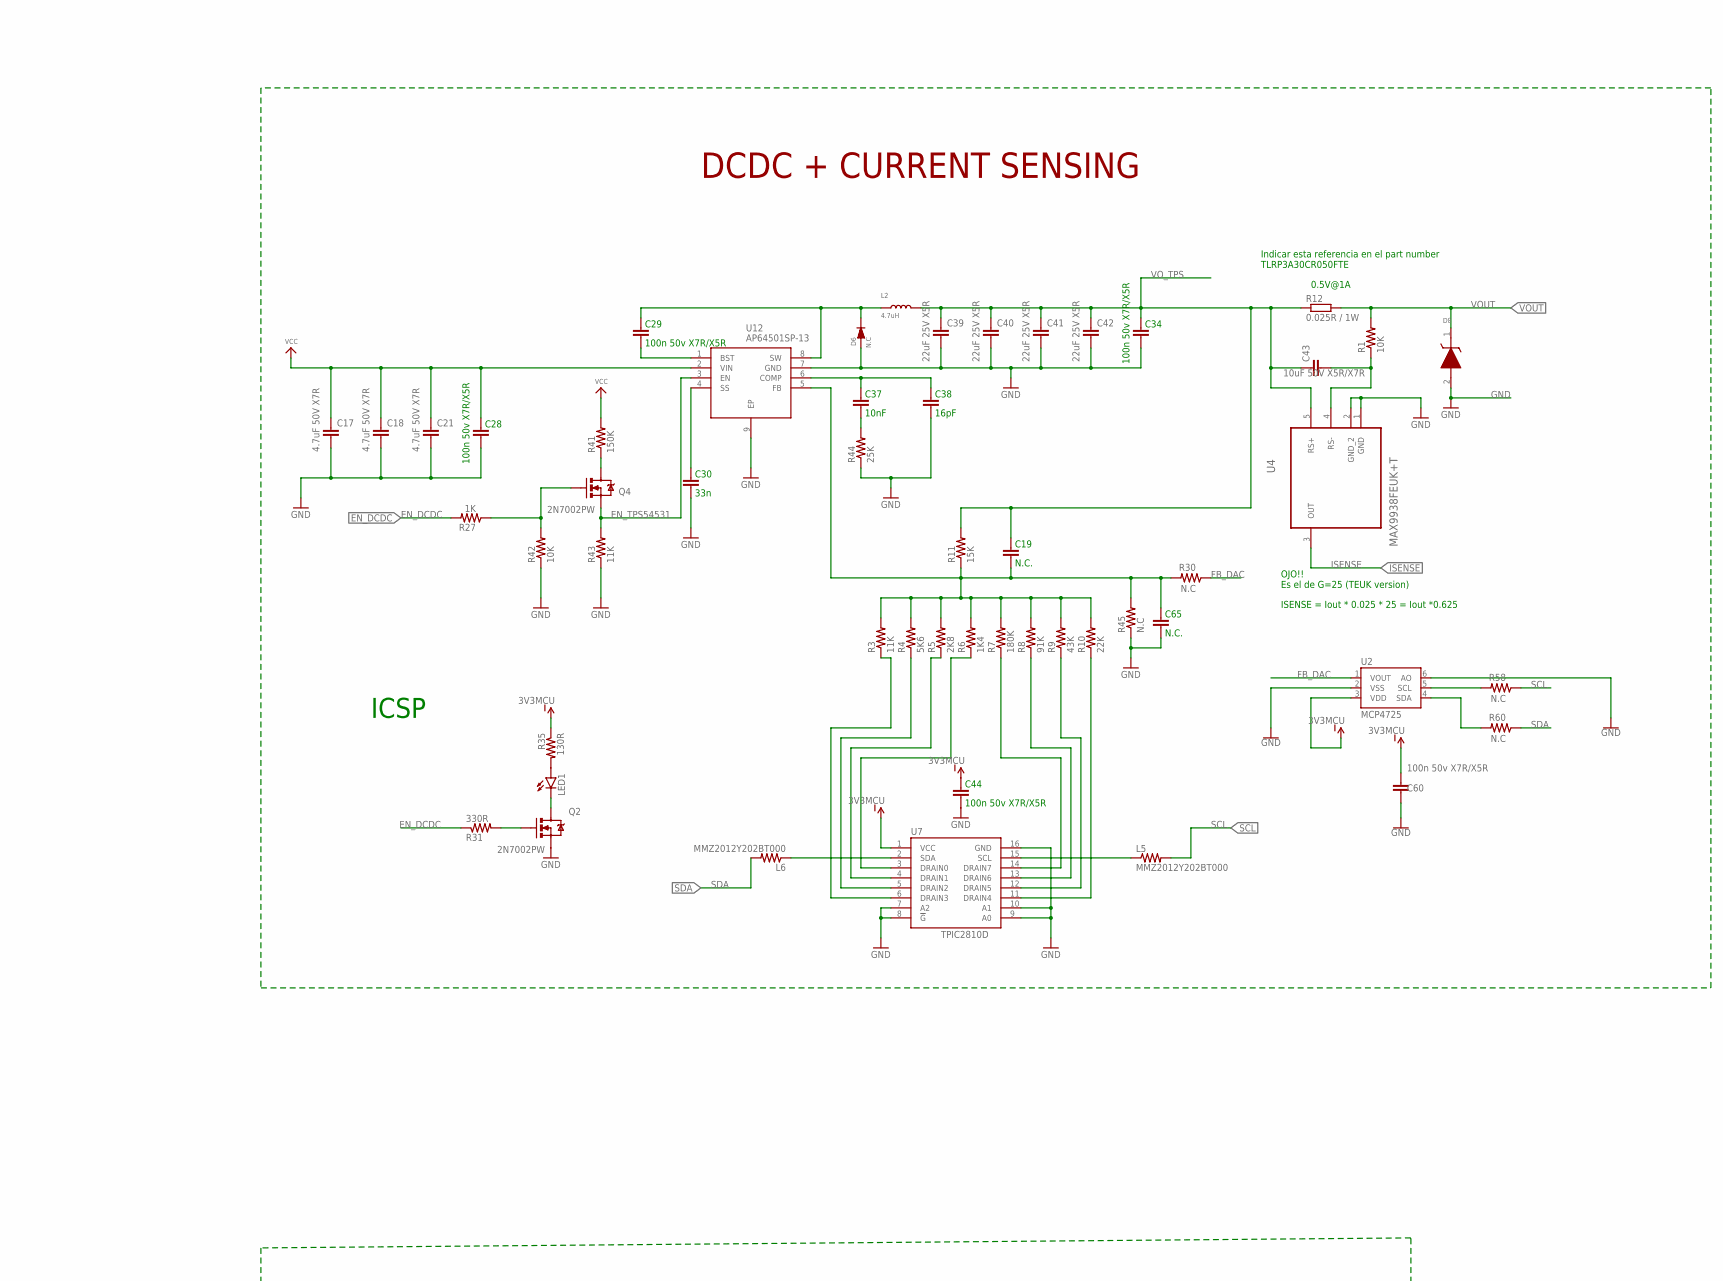
[picture p69: schematic EDCPSUMK1-RP2040.sch, part in row 1, column 3]

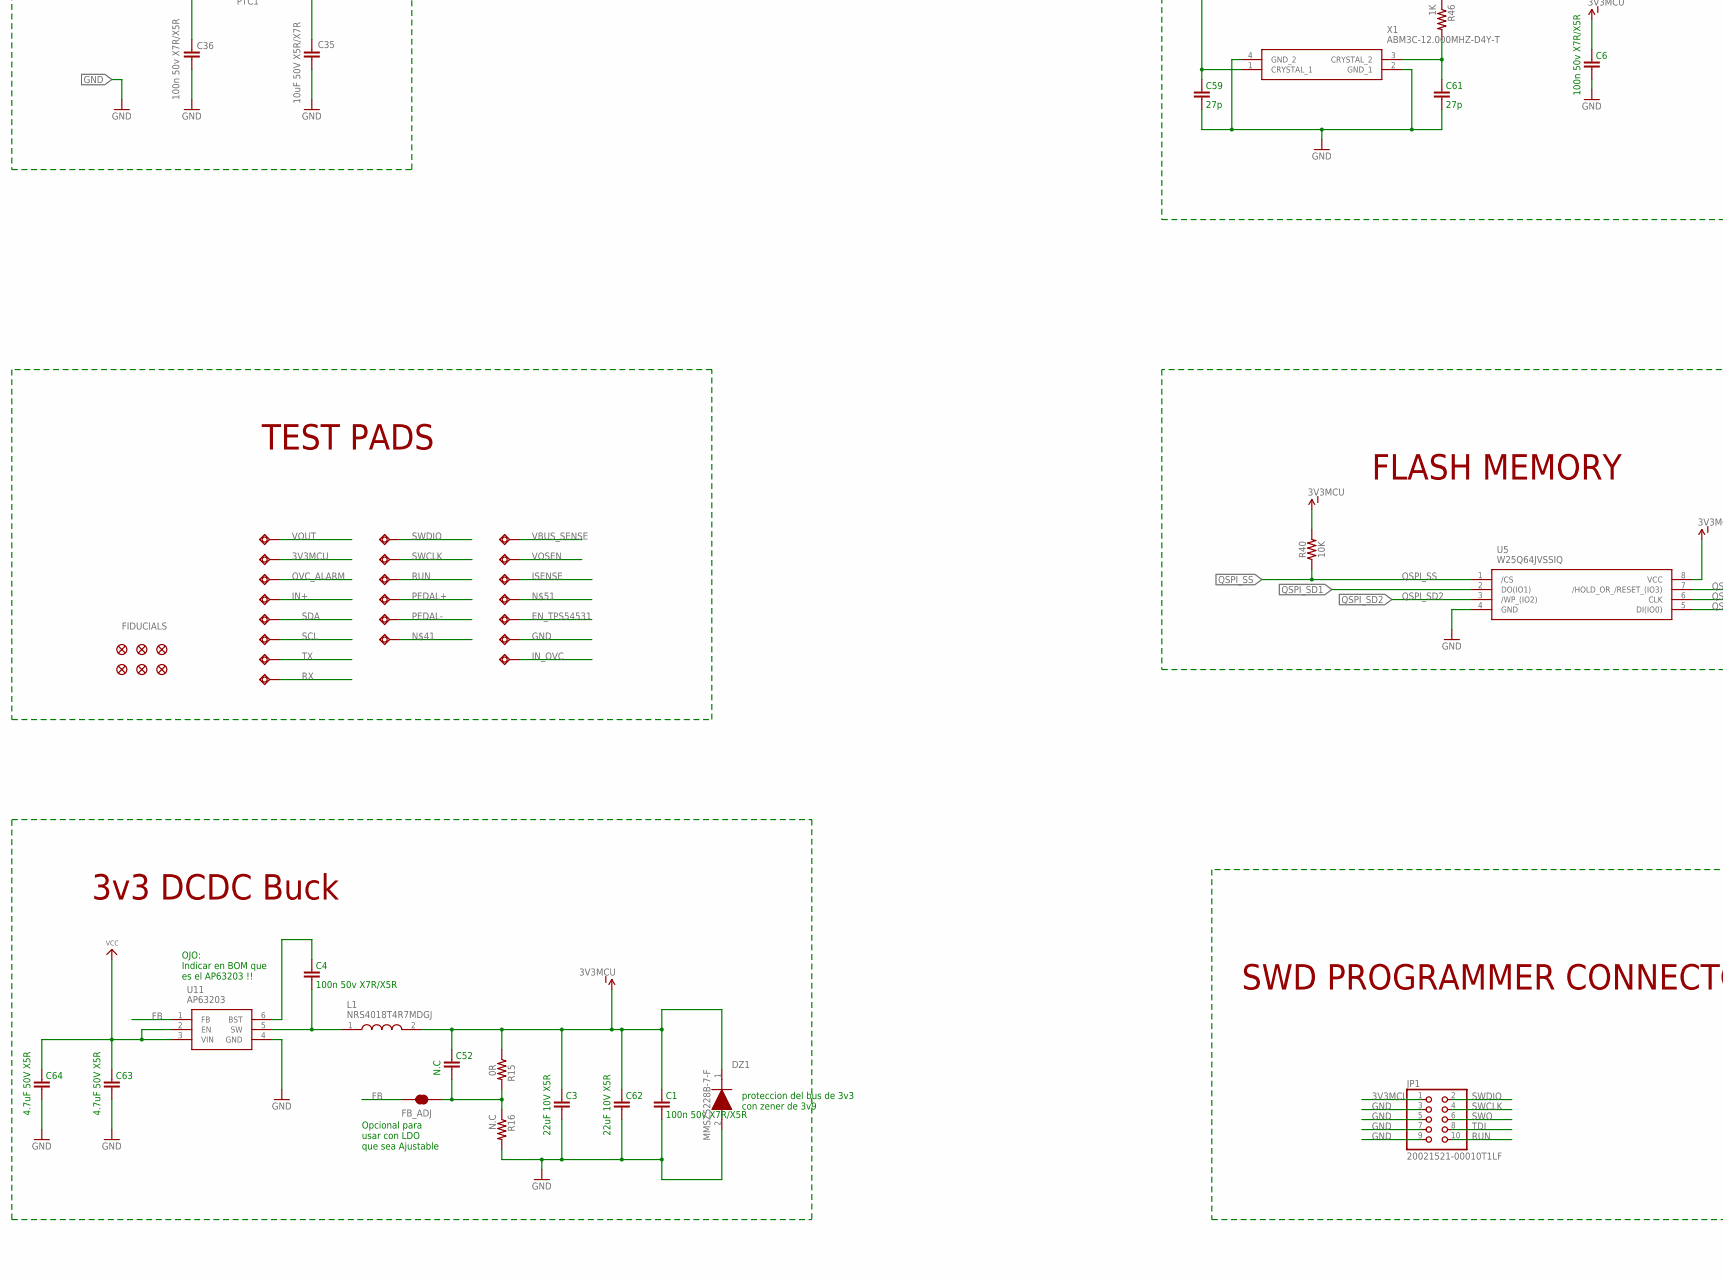
[picture p70: schematic EDCPSUMK1-RP2040.sch, part in row 2, column 1]

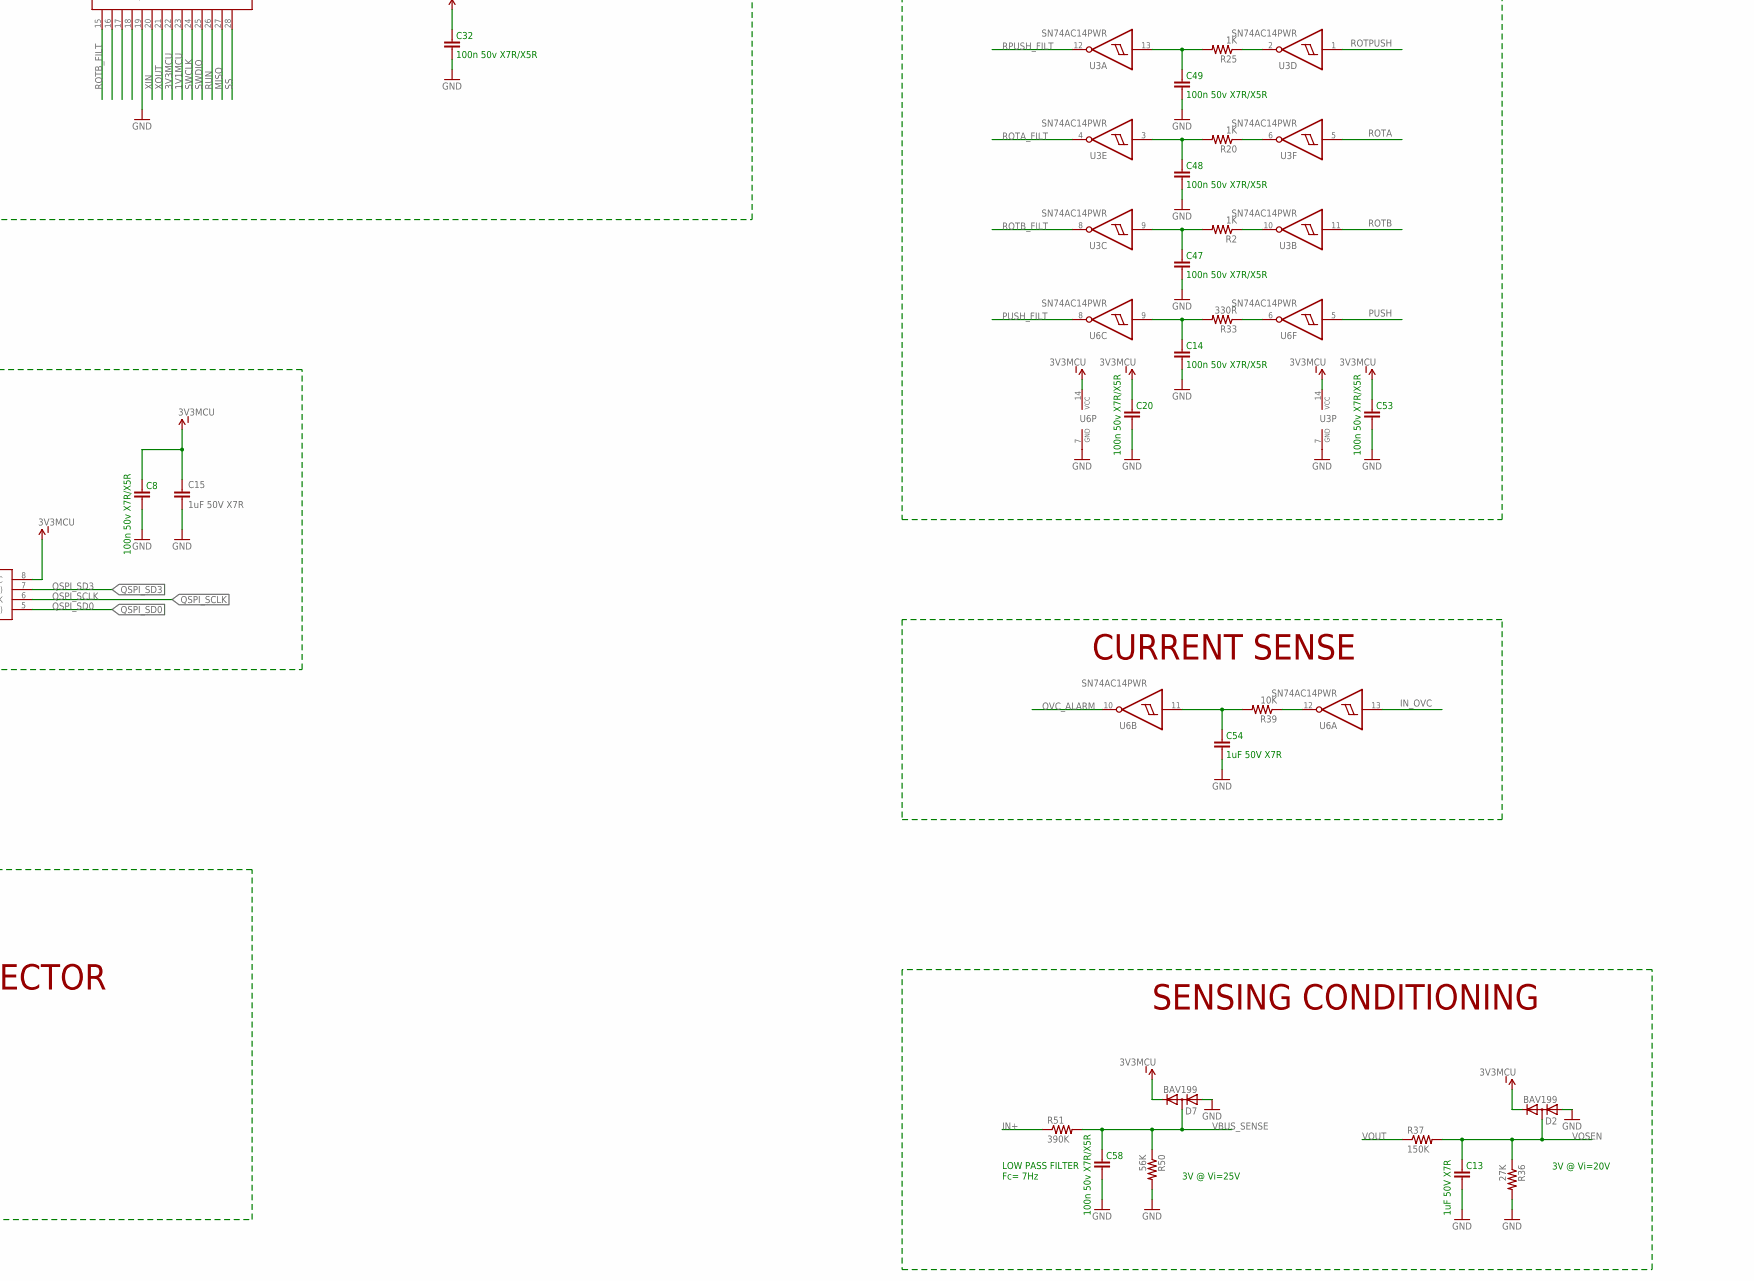
[picture p71: schematic EDCPSUMK1-RP2040.sch, part in row 2, column 2]

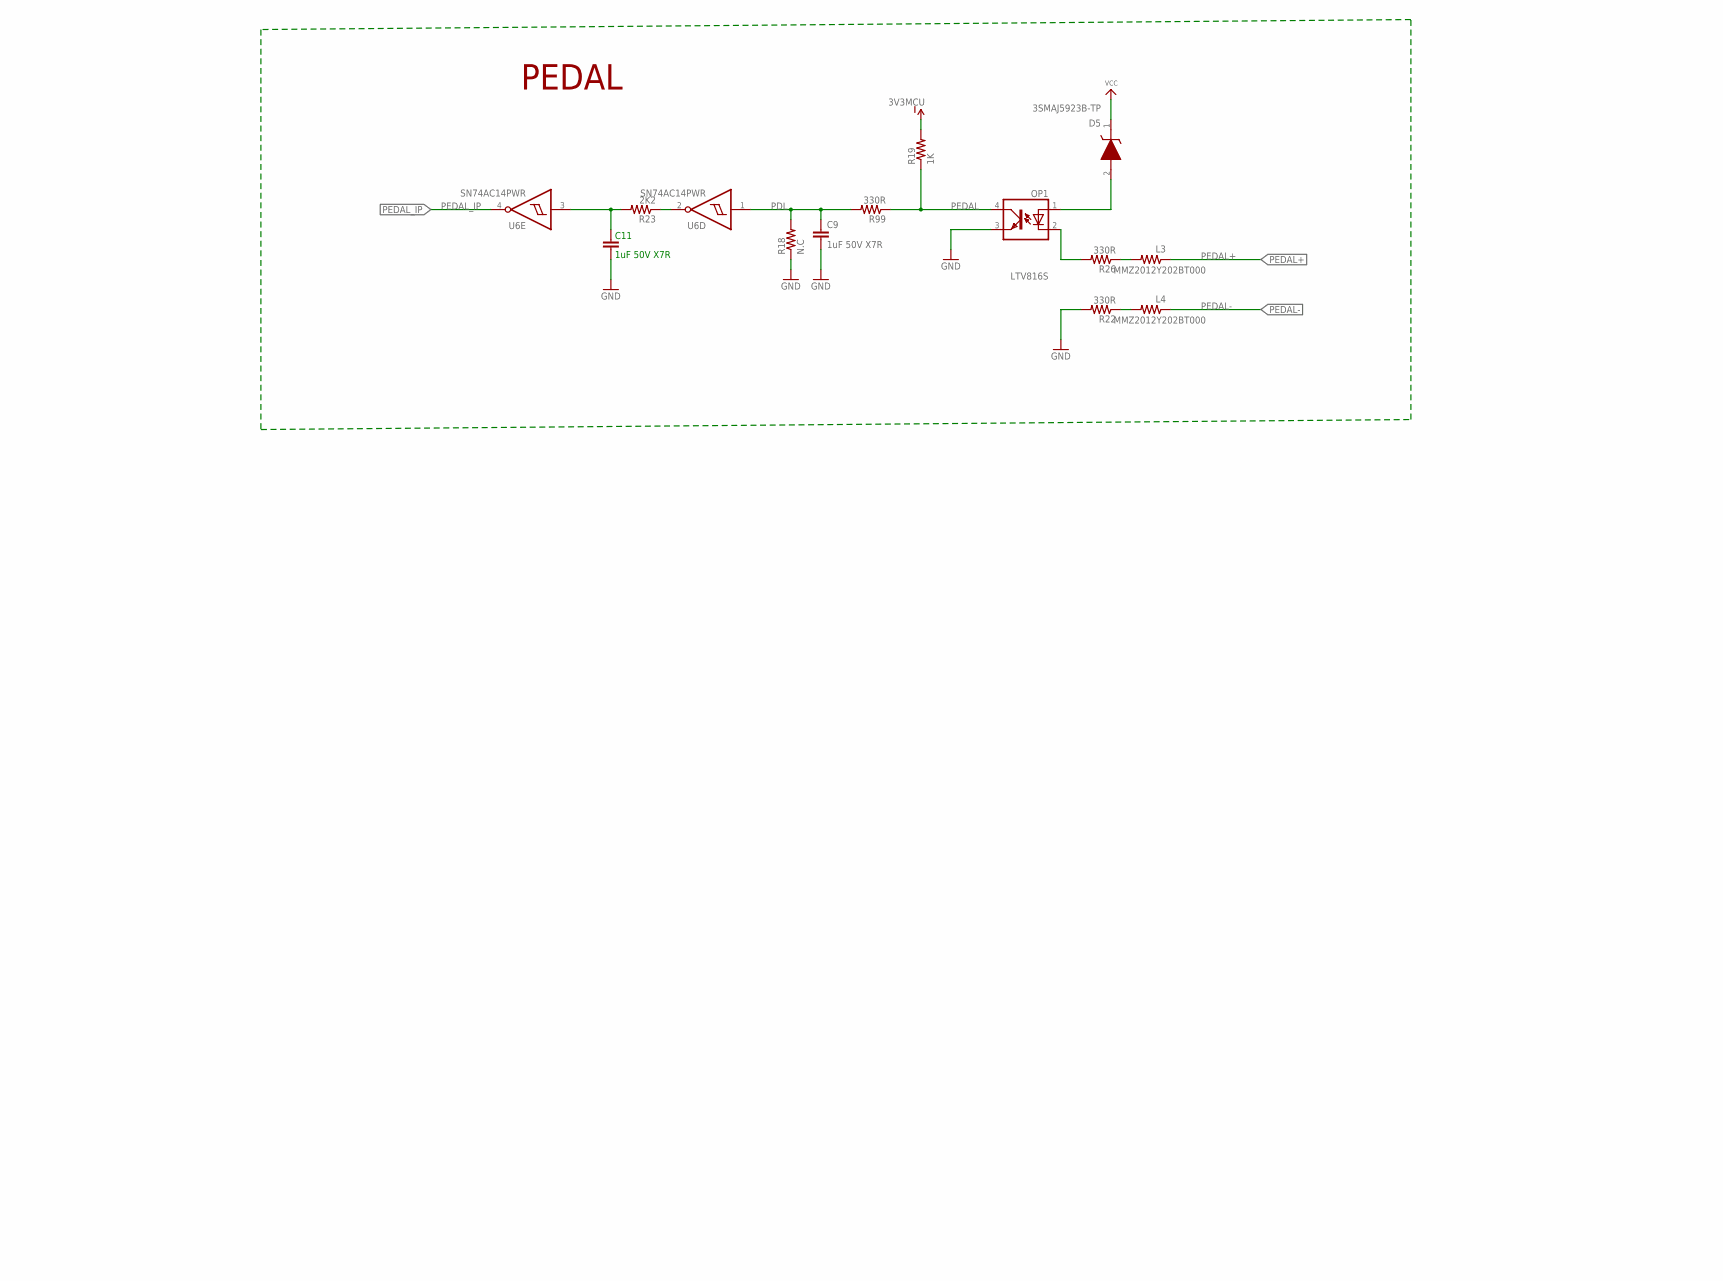
[picture p72: schematic EDCPSUMK1-RP2040.sch, part in row 2, column 3]

Parts:
3V3MCU: TESTPAD_TPSQB1,27; TESTPAD_B1,27
BZ1: PKMCS0909E4000-R1; PKMCS0909
C1, C2, C4, C5, C6, C7, C8, C10, C12, C14, C16, C20, C22, C23, C24, C25, C27, C28, C29, C31, C32, C33, C34, C36, C44, C47, C48, C49, C50, C53, C58, C60, C66: 100n 50v X7R/X5R; 0805
C3, C62: 22uF 10V X5R; 0805
C9, C11, C13, C15, C45, C46, C54: 1uF 50V X7R; 0805
C17, C18, C21: 4.7uF 50V X7R; 1210
C19, C65: N.C.; 0805
C26, C35, C43, C51: 10uF 50V X5R/X7R; 1206
C30: 33n; 0805
C37: 10nF; 0805
C38: 16pF; 0805
C39, C40, C41, C42: 22uF 25V X5R; 1210
C52: N.C; 0805
C59, C61: 27p; 0805
C63, C64: 4.7uF 50V X5R; 0805
D2, D7: BAV199; SOT23
D3: N.C; SOT23
D5: 3SMAJ5923B-TP; DIOM5226X244N
D6: N.C; DO-214AB
D8: RB060M-60TR; DIOM5226X244N
DZ1: MMSZ5228B-7-F; SODFL3518X115N
EN_TPS54531: TESTPAD_TPSQB1,27; TESTPAD_B1,27
FB_ADJ: JUMPER-SMT_2_NC_TRACE_NO-SILK; SMT-JUMPER_2_NC_TRACE_NO-SILK
FID1, FID2, FID3, FID4, FID5, FID6: FIDUCIAL1X2; FIDUCIAL-1X2
GND: TESTPAD_TPSQB1,27; TESTPAD_B1,27
IN+: TESTPAD_TPSQB1,27; TESTPAD_B1,27
IN_OVC: TESTPAD_TPSQB1,27; TESTPAD_B1,27
ISENSE: TESTPAD_TPSQB1,27; TESTPAD_B1,27
J6: Display; OLED_LCD
JP1: 20021521-00010T1LF
L1: NRS4018T4R7MDGJ; NRS4018T100MDGJ
L2: 4.7uH; WE-LHMI
L3, L4, L5, L6, L7: MMZ2012Y202BT000; 0805
LED1: LED3MM
LS1: SMT-0540-S-R; SMT0540SR
N$41, N$51: TESTPAD_TPSQB1,27; TESTPAD_B1,27
OP1: LTV816S; SMD4
OVC_ALARM: TESTPAD_TPSQB1,27; TESTPAD_B1,27
PEDAL+: TESTPAD_TPSQB1,27; TESTPAD_B1,27
PEDAL-: TESTPAD_TPSQB1,27; TESTPAD_B1,27
PTC1: 2A NOM / 3.5A LIM; 1812L
Q2, Q4, Q9: 2N7002PW; SOT323
R1, R32, R39, R40, R42, R66: 10K; 0805
R2, R19, R20, R25, R27, R46: 1K; 0805
R3, R43: 11K; 0805
R4: 5K6; 0805
R5: 2K8; 0805
R6: 1K4; 0805
R7: 180K; 0805
R8: 91K; 0805
R9: 43K; 0805
R10: 22K; 0805
R11: 15K; 0805
R12: 0.025R / 1W; R2512
R13, R23, R52, R53, R54, R64, R67: 2K2; 0805
R14, R17, R21, R24, R28, R29, R65: 33R; 0805
R15: 0R; 0805
R16, R18, R30, R45, R58, R60: N.C; 0805
R22, R26, R31, R33, R57, R61, R99: 330R; 0805
R35: 130R; 0805
R36: 27K; 0805
R37, R41: 150K; 0805
R44: 25K; 0805
R50: 56K; 0805
R51: 390K; 0805
RUN: TESTPAD_TPSQB1,27; TESTPAD_B1,27
RX: TESTPAD_TPSQB1,27; TESTPAD_B1,27
S2: TAC_SWITCH_KSC931G-SMD; TAC_SW_SMD_KSC931G
S3: PEC12R-3220F-S0024; PEC12R3220FS0024
SCL: TESTPAD_TPSQB1,27; TESTPAD_B1,27
SDA: TESTPAD_TPSQB1,27; TESTPAD_B1,27
SWCLK: TESTPAD_TPSQB1,27; TESTPAD_B1,27
SWDIO: TESTPAD_TPSQB1,27; TESTPAD_B1,27
TX: TESTPAD_TPSQB1,27; TESTPAD_B1,27
U1: RP2040TR7
U2: MCP4725; SOT23-6
U3, U6: SN74AC14PWR; TSSOP14
U4: MAX9938FEUK+T; SOT95P280X145-5N
U5: W25Q64JVSSIQ; SOIC127P790X216-8N
U7: TPIC2810D; SO16
U8: LM4040C30FTA; SOT96P240X120-3N
U11: AP63203; SOT95P280X100-6N
U12: AP64501SP-13; SOIC127P600X163-9N
VBUS_SENSE: TESTPAD_TPSQB1,27; TESTPAD_B1,27
VOSEN: TESTPAD_TPSQB1,27; TESTPAD_B1,27
VOUT: TESTPAD_TPSQB1,27; TESTPAD_B1,27
X1: ABM3C-12.000MHZ-D4Y-T; ABM3C16000MHZD4YT

Connections:
1V1MCU: C32.2, C33.2, C46.1, U1.23 (DVDD_1), U1.45 (VREG_VOUT), U1.50 (DVDD_2)
3V3MCU: 3V3MCU.TP, C1.2, C2.2, C3.2, C5.2, C6.2, C7.2, C8.2, C12.2, C15.1, C16.2, C20.2, C25.2, C26.1, C31.2, C44.2, C45.1, C50.2, C51.2, C52.2, C53.2, C60.2, C62.2, D2.2 (C), D3.2 (C), D7.2 (C), DZ1.1 (K), J6.2 (VCC), JP1.1, L1.2, LS1.1 (+), R13.2, R15.1, R19.2, R35.1, R40.2, R52.2, R53.2, R54.2, R57.2, R64.2, R66.1, R67.2, U1.1 (IOVDD_1), U1.10 (IOVDD_2), U1.22 (IOVDD_3), U1.33 (IOVDD_4), U1.42 (IOVDD_5), U1.44 (VREG_VIN), U1.48 (USB_VDD), U1.49 (IOVDD_6), U2.3 (VDD), U3.14 (VCC), U5.8 (VCC), U6.14 (VCC), U7.1 (VCC)
3V_REF: C66.2, R57.1, U1.43 (ADC_AVDD), U8.1 (CATHODE)
BUZZ: R28.1, U1.32 (GPIO21)
CS: J6.7 (CS), R29.2, R66.2
D0: J6.3 (D0), R14.2
D1: J6.4 (D1), R17.2
DSP_RST: R21.1, U1.9 (GPIO7)
EN_DCDC: R27.2, R31.1, U1.4 (GPIO2)
EN_TPS54531: EN_TPS54531.TP, Q4.2 (S), R43.2, U12.3 (EN)
FB: FB_ADJ.2, U11.1 (FB)
FB_DAC: R30.1, U2.1 (VOUT)
GND: C1.1, C2.1, C3.1, C5.1, C6.1, C7.1, C8.1, C9.2, C10.1, C11.1, C12.1, C13.1, C14.1, C15.2, C16.1, C17.2, C18.2, C20.1, C21.2, C22.1, C23.1, C24.1, C25.1, C26.2, C27.1, C28.1, C30.1, C31.1, C32.1, C33.1, C34.1, C35.2, C36.1, C38.1, C39.2, C40.2, C41.2, C42.2, C44.1, C45.2, C46.2, C47.1, C48.1, C49.1, C50.1, C51.1, C53.1, C54.1, C58.1, C59.1, C60.1, C61.1, C62.1, C63.1, C64.1, C65.1, C66.1, D2.1 (A), D6.1 (A), D7.1 (A), D8.2 (A), DZ1.2 (A), GND.TP, J6.1 (GND), JP1.3, JP1.5, JP1.7, JP1.9, OP1.3 (EMIT), Q2.2 (S), Q9.2 (S), R16.2, R18.1, R22.2, R32.2, R36.2, R42.1, R43.1, R44.1, R45.1, R50.2, S2.2, S3.1 (COM), S3.C1 (COMMON), U1.19 (TESTEN), U1.57 (GND), U2.2 (VSS), U2.6 (AO), U3.7 (GND), U4.1 (GND), U4.2 (GND_2), U5.4 (GND), U6.7 (GND), U7.7 (A2), U7.8 (!G), U7.9 (A0), U7.10 (A1), U7.16 (GND), U8.2 (ANODE_1), U11.4 (GND), U12.7 (GND), U12.9 (EP), X1.2 (GND_1), X1.4 (GND_2)
IN+: C36.2, IN+.TP, PTC1.2, R51.1
IN_OVC: IN_OVC.TP, U6.13 (I)
ISENSE: ISENSE.TP, U1.39 (GPIO27_/_ADC1), U4.3 (OUT)
MISO: R24.1, U1.27 (GPIO16)
MOSI: R17.1, U1.30 (GPIO19)
unnamed: R3.1, U7.6 (DRAIN3)
unnamed: R4.1, U7.5 (DRAIN2)
unnamed: R5.1, U7.4 (DRAIN1)
unnamed: R6.1, U7.3 (DRAIN0)
unnamed: R7.1, U7.14 (DRAIN7)
unnamed: J6.6 (DC), R24.2
unnamed: R8.1, U7.13 (DRAIN6)
unnamed: R9.1, U7.12 (DRAIN5)
unnamed: R10.1, U7.11 (DRAIN4)
unnamed: C43.2, R1.1, U4.4 (RS-)
unnamed: LED1.A, R35.2
unnamed: LED1.K (C), Q2.3 (D)
unnamed: R33.1, U6.6 (O)
unnamed: R39.1, U6.12 (O)
unnamed: D5.2 (A), OP1.1 (A)
unnamed: C10.2, R13.1, R65.2, S2.4
unnamed: C47.2, R2.2, U3.9 (I)
unnamed: C19.1, C65.2, R3.2, R4.2, R5.2, R6.2, R7.2, R8.2, R9.2, R10.2, R11.1, R30.2, R45.2, U12.5 (FB)
unnamed: Q9.1 (G), R28.2, R32.1
unnamed: Q2.1 (G), R31.2
unnamed: R2.1, U3.10 (O)
unnamed: R20.1, U3.6 (O)
unnamed: R25.1, U3.2 (O)
unnamed: C49.2, R25.2, U3.13 (I)
unnamed: C48.2, R20.2, U3.3 (I)
unnamed: C11.2, R23.2, U6.3 (I)
unnamed: BZ1.2 (-), D3.3 (AC), LS1.2 (-), Q9.3 (D), R61.1
unnamed: BZ1.1 (+), C27.2, L7.2, R61.2
unnamed: R23.1, U6.2 (O)
unnamed: Q4.3 (D), R41.1
unnamed: C14.2, R33.2, U6.9 (I)
unnamed: C52.1, FB_ADJ.1, R15.2, R16.1
unnamed: C54.2, R39.2, U6.11 (I)
unnamed: L6.1, U7.2 (SDA)
unnamed: N$41.TP, OP1.2 (C), R26.2
unnamed: L3.2, R26.1
unnamed: C30.2, U12.4 (SS)
unnamed: R58.2, U2.5 (SCL)
unnamed: L4.2, R22.1
unnamed: C29.1, U12.1 (BST)
unnamed: R60.2, U2.4 (SDA)
unnamed: C29.2, D6.2 (K), L2.1, N$51.TP, U12.8 (SW)
unnamed: C37.2, C38.2, U12.6 (COMP)
unnamed: C37.1, R44.2
unnamed: L5.1, U7.15 (SCL)
unnamed: C4.2, U11.6 (BST)
unnamed: C61.2, R46.2, X1.3 (CRYSTAL_2)
unnamed: C4.1, L1.1, U11.5 (SW)
OVC_ALARM: OVC_ALARM.TP, U1.12 (GPIO9), U6.10 (O)
PDL: C9.1, R18.2, R99.2, U6.1 (I)
PEDAL: OP1.4 (COL), R19.1, R99.1
PEDAL+: L3.1, PEDAL+.TP
PEDAL-: L4.1, PEDAL-.TP
PEDAL_IP: U1.11 (GPIO8), U6.4 (O)
PUSH: R65.1, U6.5 (I)
PUSH_FILT: U1.5 (GPIO3), U6.8 (O)
QSPI_SCLK: U1.52 (QSPI_SCLK), U5.6 (CLK)
QSPI_SD0: U1.53 (QSPI_SD0), U5.5 (DI(IO0))
QSPI_SD1: U1.55 (QSPI_SD1), U5.2 (DO(IO1))
QSPI_SD2: U1.54 (QSPI_SD2), U5.3 (/WP_(IO2))
QSPI_SD3: U1.51 (QSPI_SD3), U5.7 (/HOLD_OR_/RESET_(IO3))
QSPI_SS: R40.1, U1.56 (QSPI_SS_N), U5.1 (/CS)
ROTA: C23.2, R53.1, S3.A1 (CHANNEL_A), U3.5 (I)
ROTA_FILT: U1.36 (GPIO24), U3.4 (O)
ROTB: C22.2, R52.1, S3.B1 (CHANNEL_B), U3.11 (I)
ROTB_FILT: U1.15 (GPIO12), U3.8 (O)
ROTPUSH: C24.2, R54.1, S3.2 (NO), U3.1 (I)
RPUSH_FILT: U1.8 (GPIO6), U3.12 (O)
RST: J6.5 (RST), R21.2
RUN: JP1.10, RUN.TP, U1.26 (RUN)
RX: RX.TP, U1.3 (GPIO1)
SAFETY_EN_DCDC: Q4.1 (G), R27.1, R42.2
SCK: R14.1, U1.29 (GPIO18)
SCL: L5.2, R58.1, R67.1, SCL.TP, U1.7 (GPIO5)
SDA: L6.2, R60.1, R64.1, SDA.TP, U1.6 (GPIO4)
SEL: U1.37 (GPIO25)
SS: R29.1, U1.28 (GPIO17)
SWCLK: JP1.4, SWCLK.TP, U1.24 (SWCLK)
SWDIO: JP1.2, SWDIO.TP, U1.25 (SWDIO)
SWO: JP1.6
TDI: JP1.8
TX: TX.TP, U1.2 (GPIO0)
USB_DM: U1.46 (USB_DM)
USB_DP: U1.47 (USB_DP)
VBUS_SENSE: C58.2, D7.3 (AC), R50.1, R51.2, U1.38 (GPIO26_/_ADC0), VBUS_SENSE.TP
VCC: C17.1, C18.1, C21.1, C28.2, C35.1, C63.2, C64.2, D5.1 (K), L7.1, PTC1.1, R41.2, U11.2 (EN), U11.3 (VIN), U12.2 (VIN)
VOSEN: C13.2, D2.3 (AC), R36.1, R37.2, U1.40 (GPIO28_/_ADC2), VOSEN.TP
VOUT: D8.1 (K), R1.2, R12.2, R37.1, VOUT.TP
VO_TPS: C19.2, C34.2, C39.1, C40.1, C41.1, C42.1, C43.1, L2.2, R11.2, R12.1, U4.5 (RS+)
XIN: C59.2, U1.20 (XIN), X1.1 (CRYSTAL_1)
XOUT: R46.1, U1.21 (XOUT)

Notes on the sheet:
0.5V@1A
SENSING CONDITIONING
TEST PADS
MK1-RP2040 v2-Abr-2024
(DATA/COMMAND)
Overlap buzzer assy concentric
ICSP
BUZZER
ROTARY + SWITCH
DISPLAY
FIDUCIALS
OJO!! Es el de G=25 (TEUK version)
ISENSE = Iout * 0.025 * 25 = Iout *0.625
3V @ Vi=25V
LOW PASS FILTER Fc= 7Hz
SWD PROGRAMMER CONNECTOR
3v3 DCDC Buck
OJO: Indicar en BOM que es el AP63203 !!
FLASH MEMORY
PEDAL
CURRENT SENSE
ROTARY+PUSHBUTTON FILTER
DCDC + CURRENT SENSING
MCU
Indicar esta referencia en el part number TLRP3A30CR050FTE
3v3-3v = 0.3 /330R = 900uA
proteccion del bus de 3v3 con zener de 3v9
3V @ Vi=20V
INPUT POWER
Opcional para usar con LDO que sea Ajustable

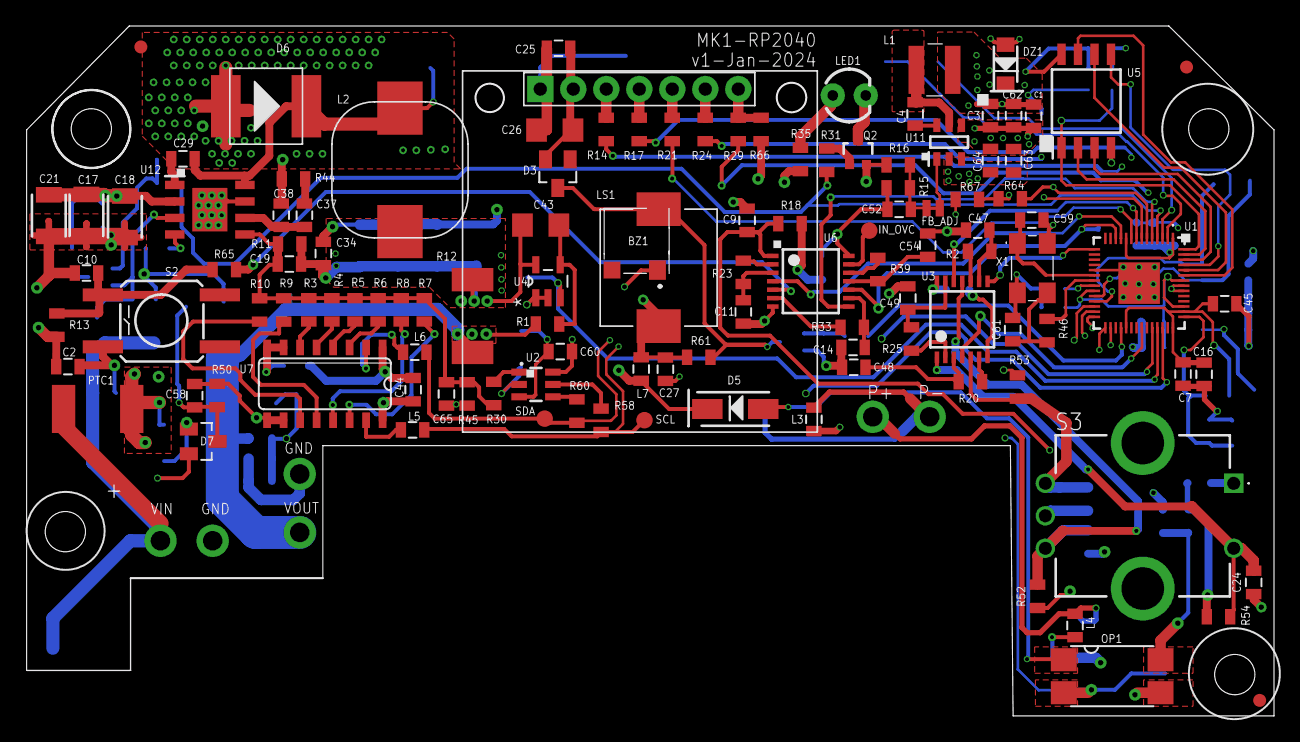
[picture p73: board EDCPSUMK1-RP2040.brd from above]

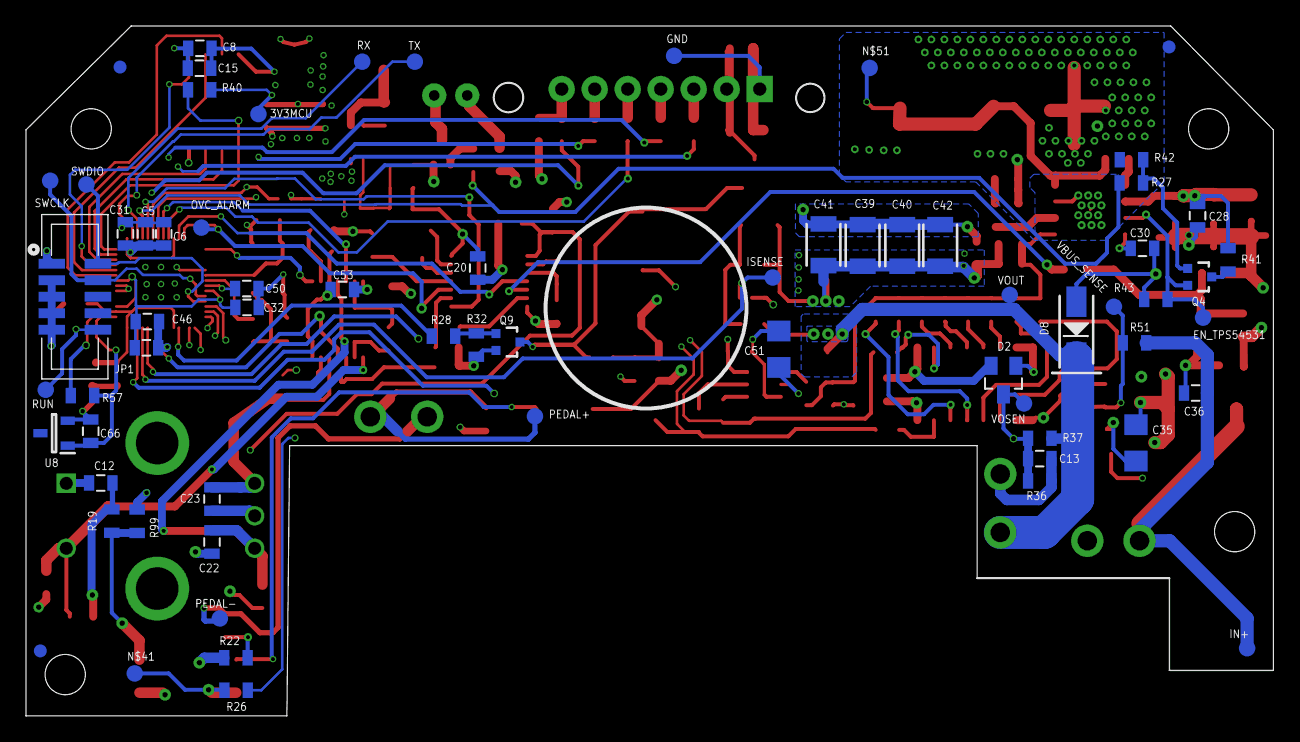
[picture p74: board EDCPSUMK1-RP2040.brd from below]

Board: 4 copper layers, 96.0 x 53.1 mm, 186 parts (67 on the bottom side), 104 nets.
