MSTKMAD/MK1/02.Hardware/MK1-RP2040/04.TEST-PLUG/Test-plug.brd

## EAGLE design 02.Hardware/MK1-RP2040/04.TEST-PLUG/Test-plug.brd (2026-01-16)

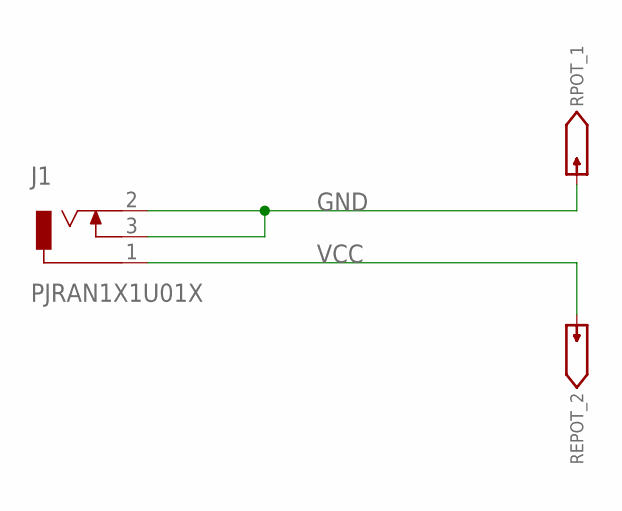
[picture p75: schematic Test-plug.sch]

Parts:
J1: PJRAN1X1U01X
REPOT_2: TESTPAD/W_HOLE_1X1; DIODE_GHI2_TESTPAD/W_HOLE_1X1
RPOT_1: TESTPAD/W_HOLE_1X1; DIODE_GHI2_TESTPAD/W_HOLE_1X1

Connections:
GND: J1.2, J1.3, RPOT_1.P$1
VCC: J1.1, REPOT_2.P$1

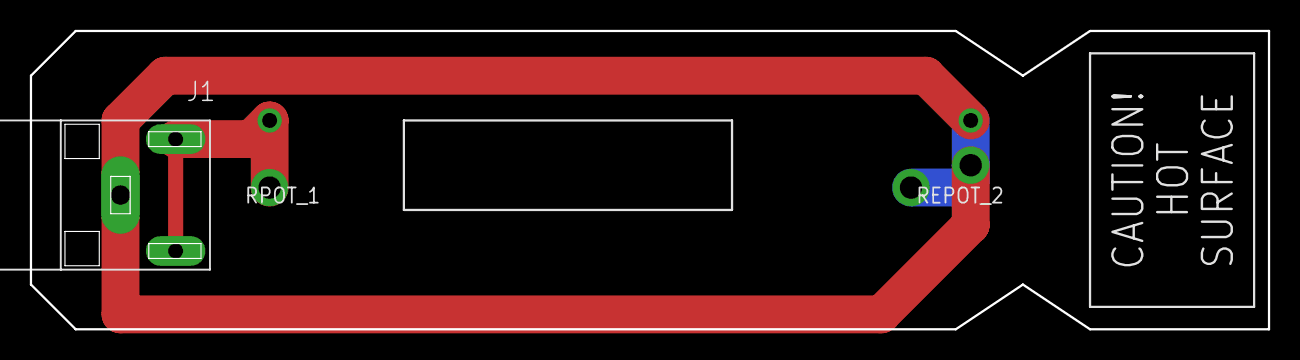
[picture p76: board Test-plug.brd from above]

Board: 2 copper layers, 83.0 x 20.0 mm, 3 parts (0 on the bottom side), 2 nets.
