MSTKMAD/MK1/02.Hardware/MK1-RP2040/02.JACKS_EDCPSU/GERBER v4/Jacks_EDCPSU.brd

## EAGLE design 02.Hardware/MK1-RP2040/02.JACKS_EDCPSU/GERBER v4/Jacks_EDCPSU.brd (2024-04-09, an earlier design)

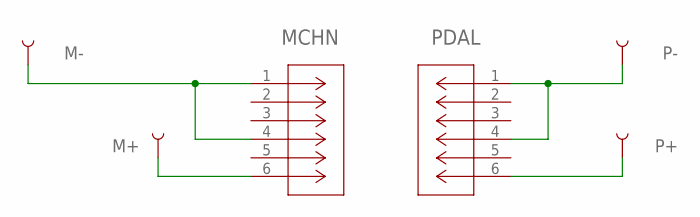
[picture p77: schematic Jacks_EDCPSU.sch]

Parts:
M+: TEST-POINT3; PAD.03X.03
M-: TEST-POINT3; PAD.03X.03
MCHN: ACJS-MHDR; CONN_MHDR_AMP
P+: TEST-POINT3; PAD.03X.03
P-: TEST-POINT3; PAD.03X.03
PDAL: ACJS-MHDR; CONN_MHDR_AMP

Connections:
unnamed: P-.P$1, PDAL.1, PDAL.4
unnamed: P+.P$1, PDAL.6
unnamed: M-.P$1, MCHN.1, MCHN.4
unnamed: M+.P$1, MCHN.6

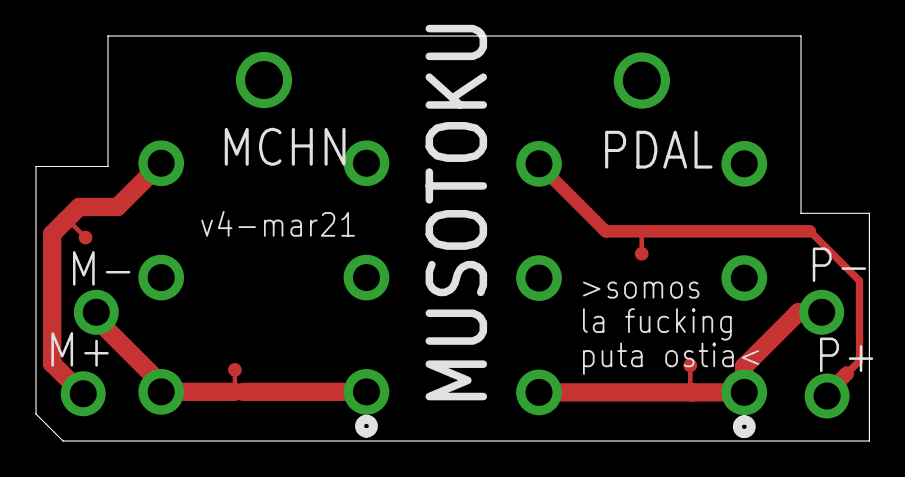
[picture p78: board 02.Hardware/MK1-RP2040/02.JACKS_EDCPSU/GERBER v4/Jacks_EDCPSU.brd from above]

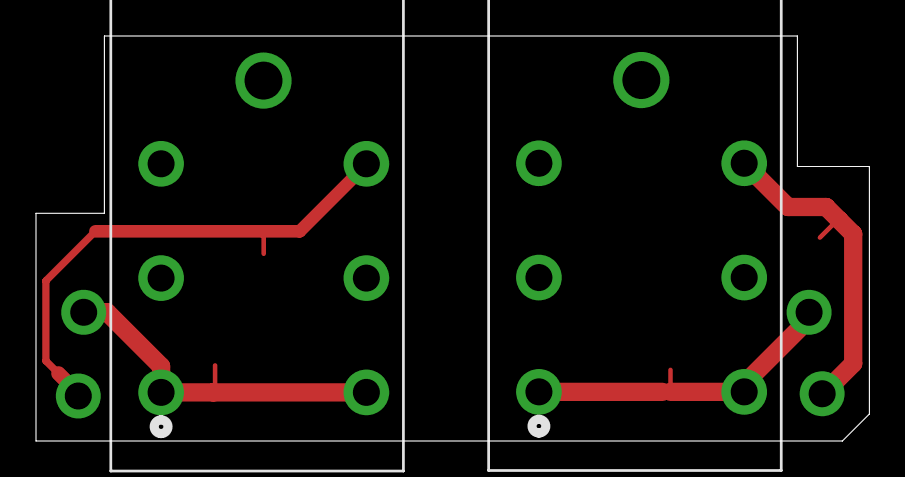
[picture p79: board 02.Hardware/MK1-RP2040/02.JACKS_EDCPSU/GERBER v4/Jacks_EDCPSU.brd from below]

Board: 2 copper layers, 46.3 x 22.5 mm, 6 parts (2 on the bottom side), 4 nets.
