MSTKMAD/MK1/02.Hardware/MK1-RP2040/02.JACKS_EDCPSU/GERBER v2/Jacks_EDCPSU.brd

## EAGLE design 02.Hardware/MK1-RP2040/02.JACKS_EDCPSU/GERBER v2/Jacks_EDCPSU.brd (2024-04-09, an earlier design)

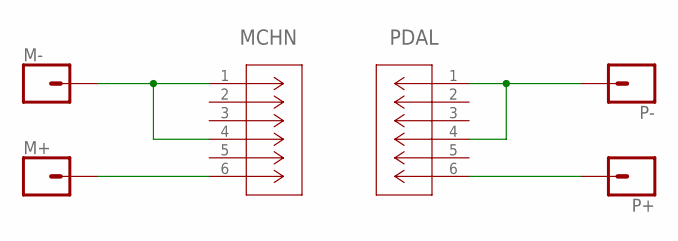
[picture p80: schematic Jacks_EDCPSU.sch]

Parts:
M+: CONN_01PTH_NO_SILK_KIT; 1X01NS_KIT
M-: CONN_01PTH_NO_SILK_KIT; 1X01NS_KIT
MCHN: ACJS-MHDR; CONN_MHDR_AMP
P+: CONN_01PTH_NO_SILK_KIT; 1X01NS_KIT
P-: CONN_01PTH_NO_SILK_KIT; 1X01NS_KIT
PDAL: ACJS-MHDR; CONN_MHDR_AMP

Connections:
unnamed: P-.1, PDAL.1, PDAL.4
unnamed: P+.1, PDAL.6
unnamed: M-.1, MCHN.1, MCHN.4
unnamed: M+.1, MCHN.6

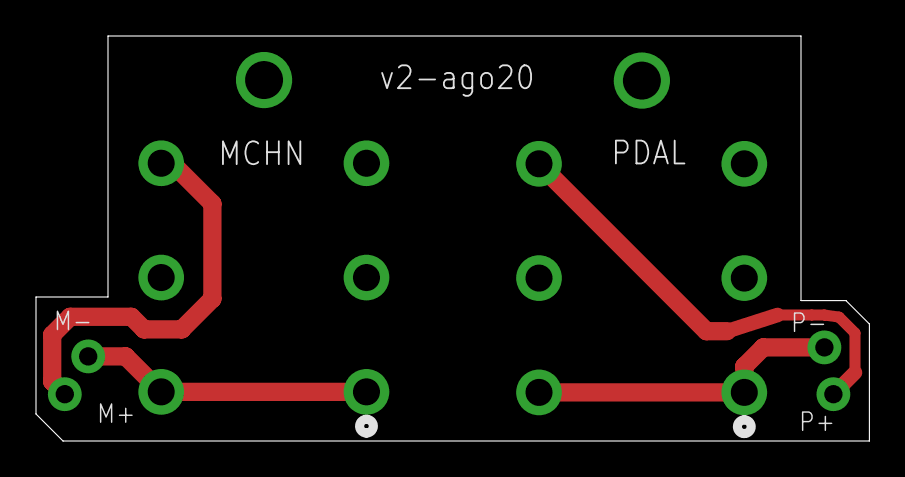
[picture p81: board 02.Hardware/MK1-RP2040/02.JACKS_EDCPSU/GERBER v2/Jacks_EDCPSU.brd from above]

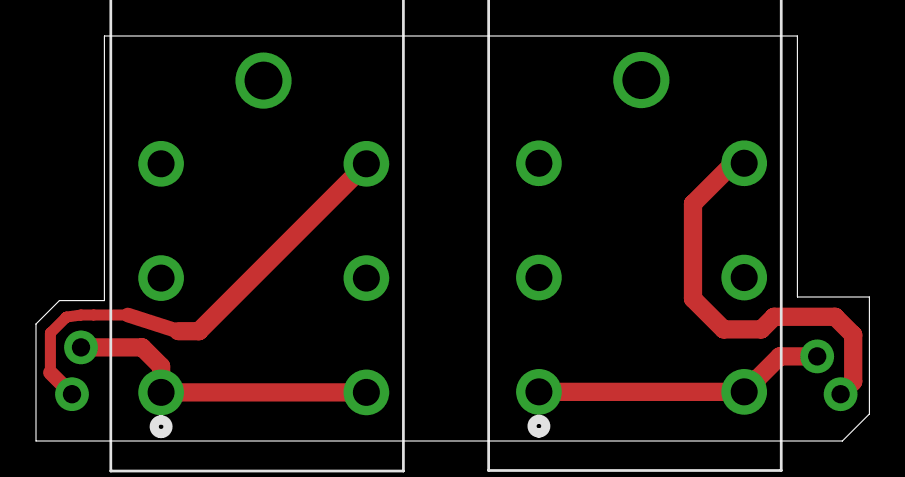
[picture p82: board 02.Hardware/MK1-RP2040/02.JACKS_EDCPSU/GERBER v2/Jacks_EDCPSU.brd from below]

Board: 2 copper layers, 46.3 x 22.5 mm, 6 parts (6 on the bottom side), 4 nets.
