MSTKMAD/MK1/02.Hardware/MK1-ATMEGA/EDCPSU_DUAL_MSTK_M1/01. DUAL_M1_LEDS/HISTORY/V2/DUAL_M2_LEDS.brd

## EAGLE design 02.Hardware/MK1-ATMEGA/EDCPSU_DUAL_MSTK_M1/01. DUAL_M1_LEDS/HISTORY/V2/DUAL_M2_LEDS.brd (2023-06-05, an earlier design)

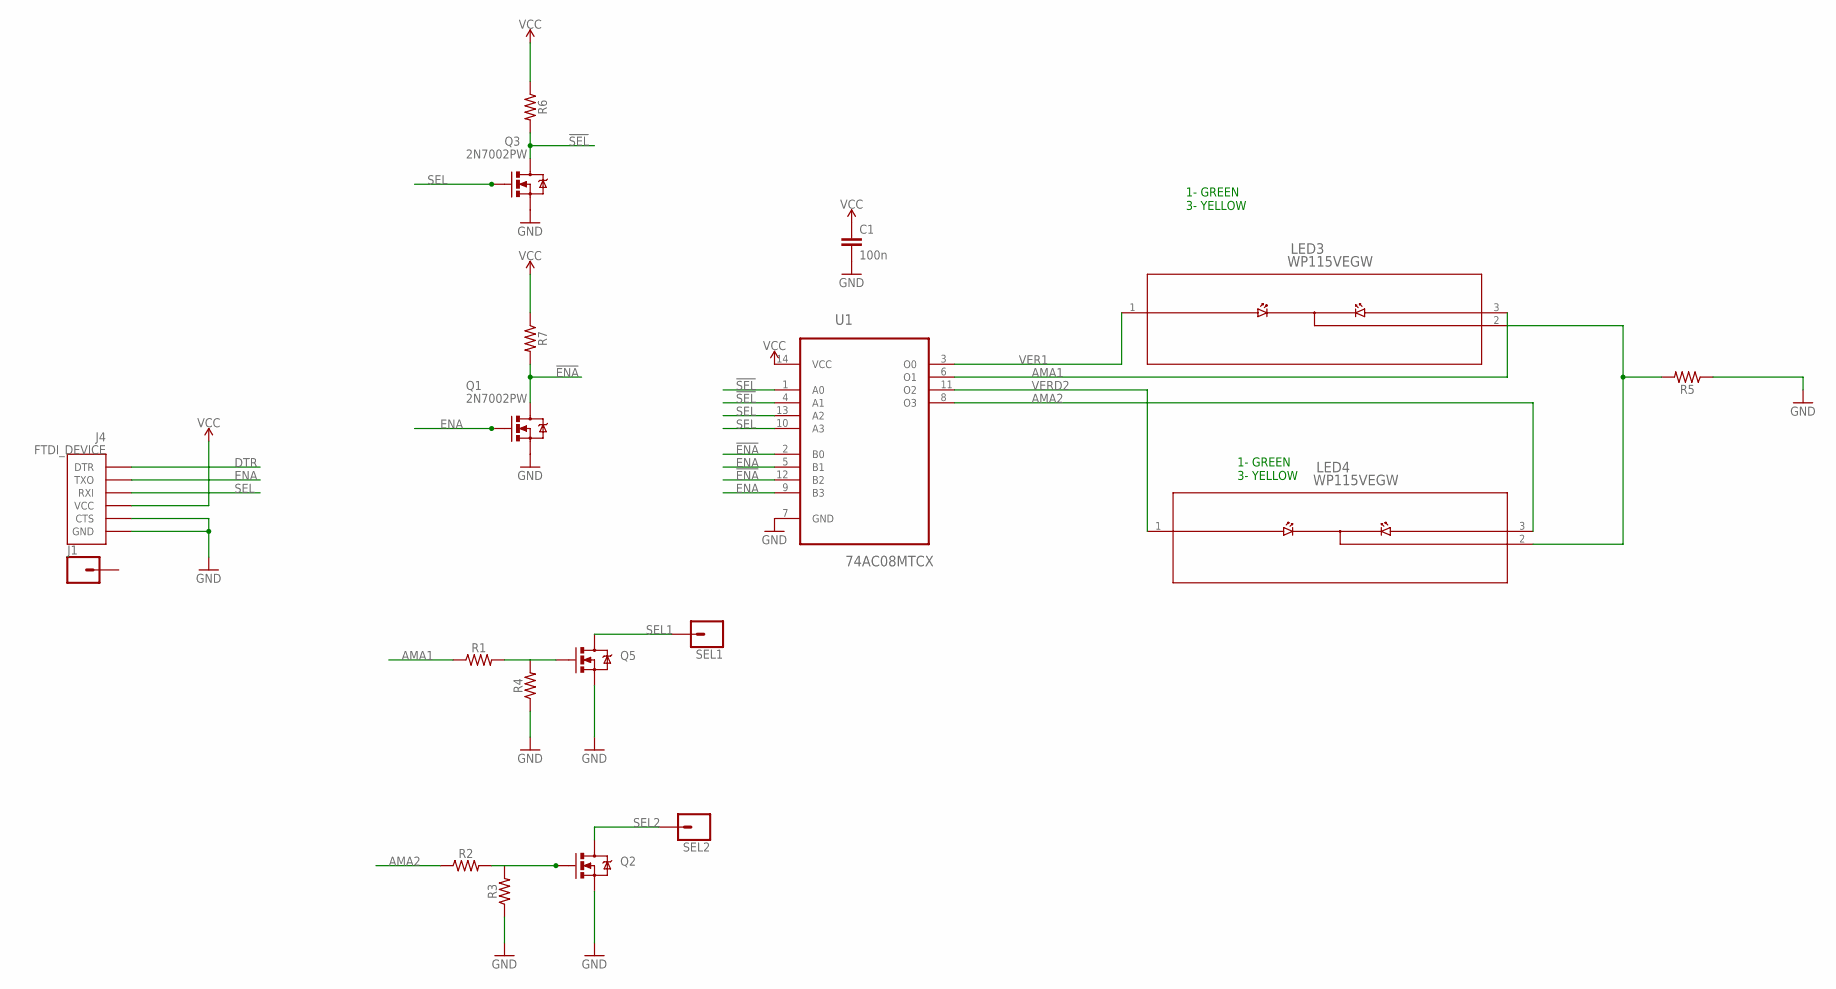
[picture p83: schematic DUAL_M2_LEDS.sch]

Parts:
C1: 100n; 0805
J1: CONN_01; 1X01
J4: FTDI_DEVICE; FTDI_DEVICE_SIDE
LED3, LED4: WP115VEGW; WP115VEGW_KNB
Q1, Q2, Q3, Q5: 2N7002PW; SOT323
R1, R2, R3, R4, R5, R6, R7: 0805
SEL1, SEL2: CONN_01; 1X01
U1: 74AC08MTCX; SOP65P640X120-14N

Connections:
!ENA!: Q1.3 (D), R7.2, U1.2 (B0), U1.12 (B2)
!SEL!: Q3.3 (D), R6.2, U1.1 (A0), U1.4 (A1)
AMA1: LED3.3, R1.1, U1.6 (O1)
AMA2: LED4.3, R2.1, U1.8 (O3)
DTR: J4.P$1 (DTR)
ENA: J4.P$2 (TXO), Q1.1 (G), U1.5 (B1), U1.9 (B3)
GND: C1.2, J4.P$5 (CTS), J4.P$6 (GND), Q1.2 (S), Q2.2 (S), Q3.2 (S), Q5.2 (S), R3.1, R4.1, R5.1, U1.7 (GND)
unnamed: Q2.1 (G), R2.2, R3.2
unnamed: Q5.1 (G), R1.2, R4.2
unnamed: LED3.2, LED4.2, R5.2
SEL: J4.P$3 (RXI), Q3.1 (G), U1.10 (A3), U1.13 (A2)
SEL1: Q5.3 (D), SEL1.1
SEL2: Q2.3 (D), SEL2.1
VCC: C1.1, J4.P$4 (VCC), R6.1, R7.1, U1.14 (VCC)
VER1: LED3.1, U1.3 (O0)
VERD2: LED4.1, U1.11 (O2)

Notes on the sheet:
1- GREEN 3- YELLOW

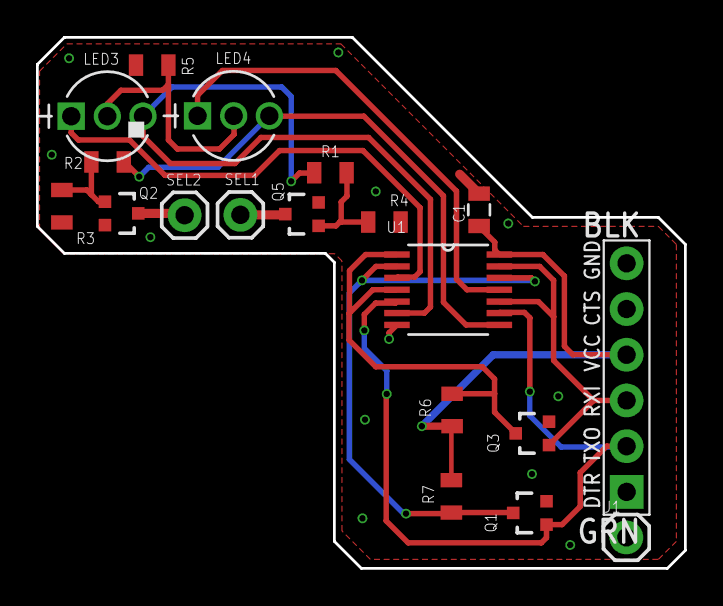
[picture p84: board DUAL_M2_LEDS.brd from above]

Board: 2 copper layers, 36.0 x 29.5 mm, 19 parts (0 on the bottom side), 15 nets.
