MSTKMAD/MK1/02.Hardware/MK1-ATMEGA/EDCPSUr15/EDCPSU.brd

## EAGLE design 02.Hardware/MK1-ATMEGA/EDCPSUr15/EDCPSU.brd (2023-06-05)

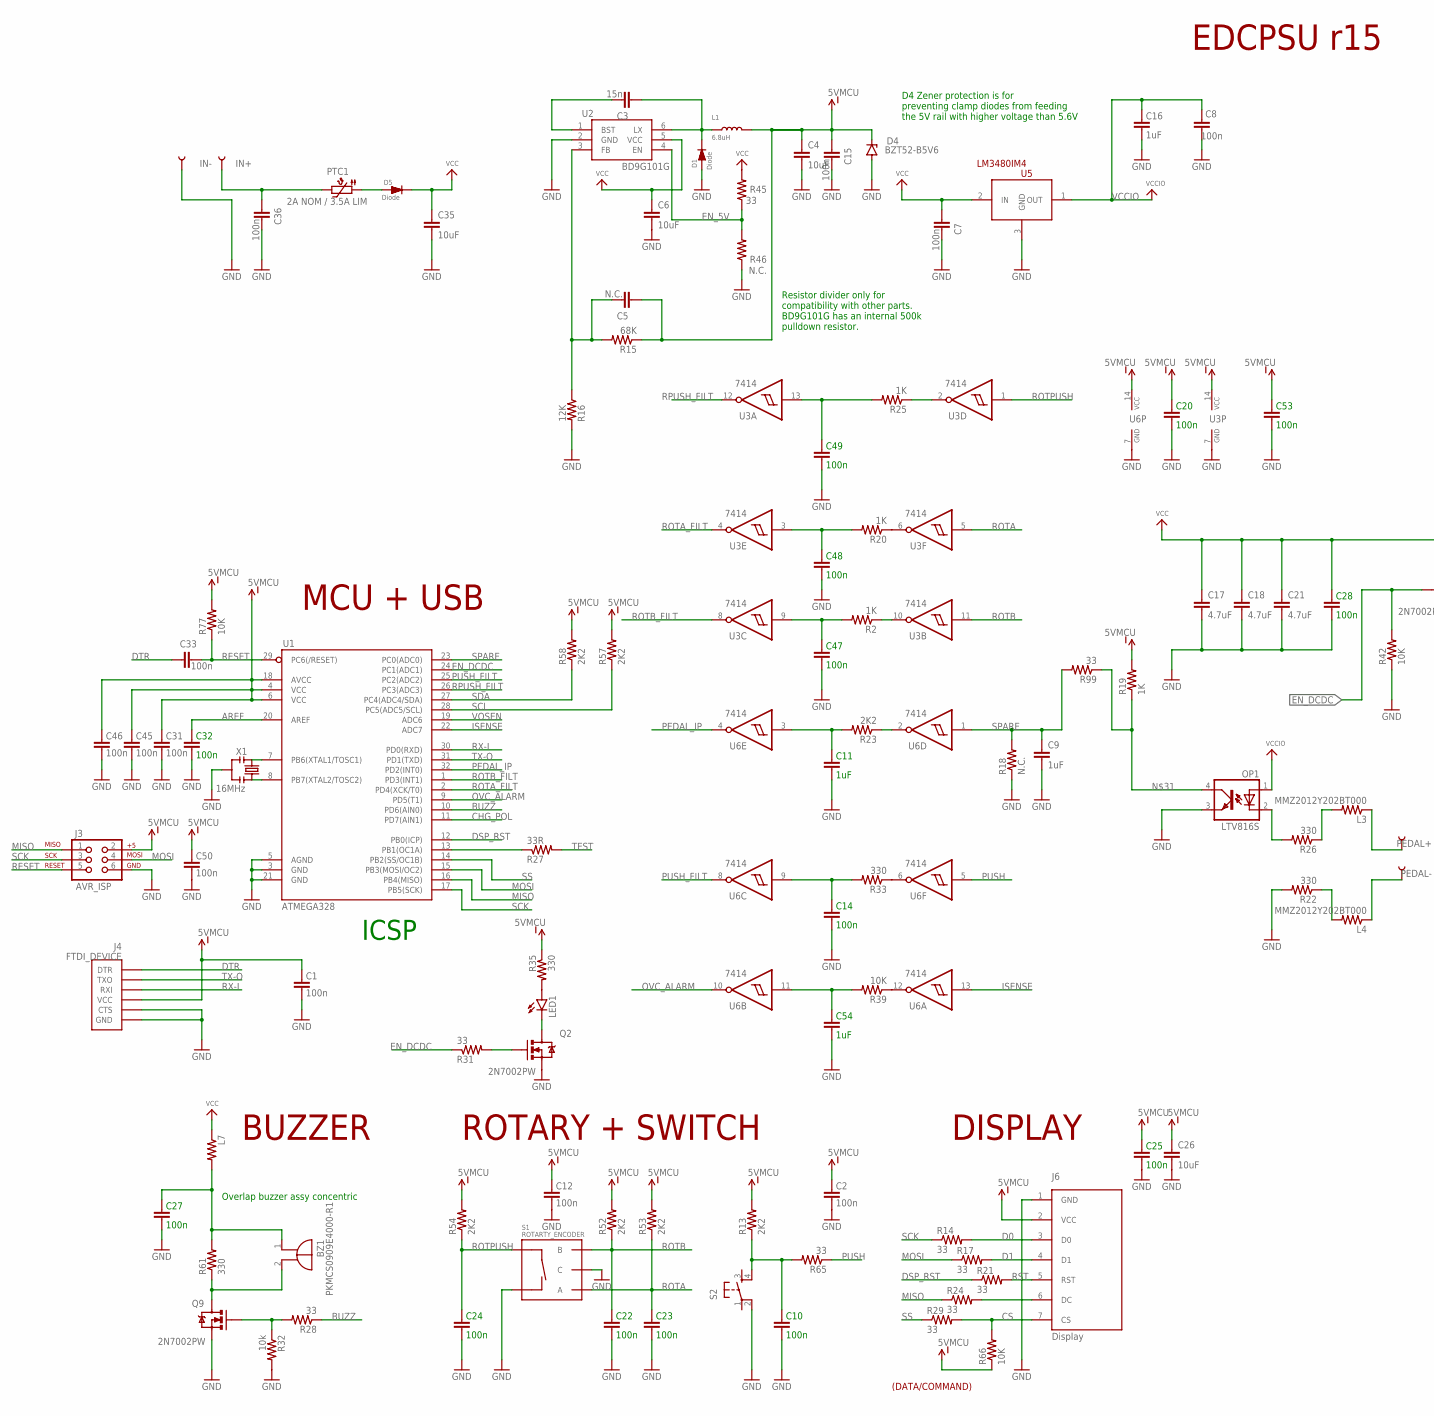
[picture p85: schematic EDCPSU.sch, part in row 1, column 1]

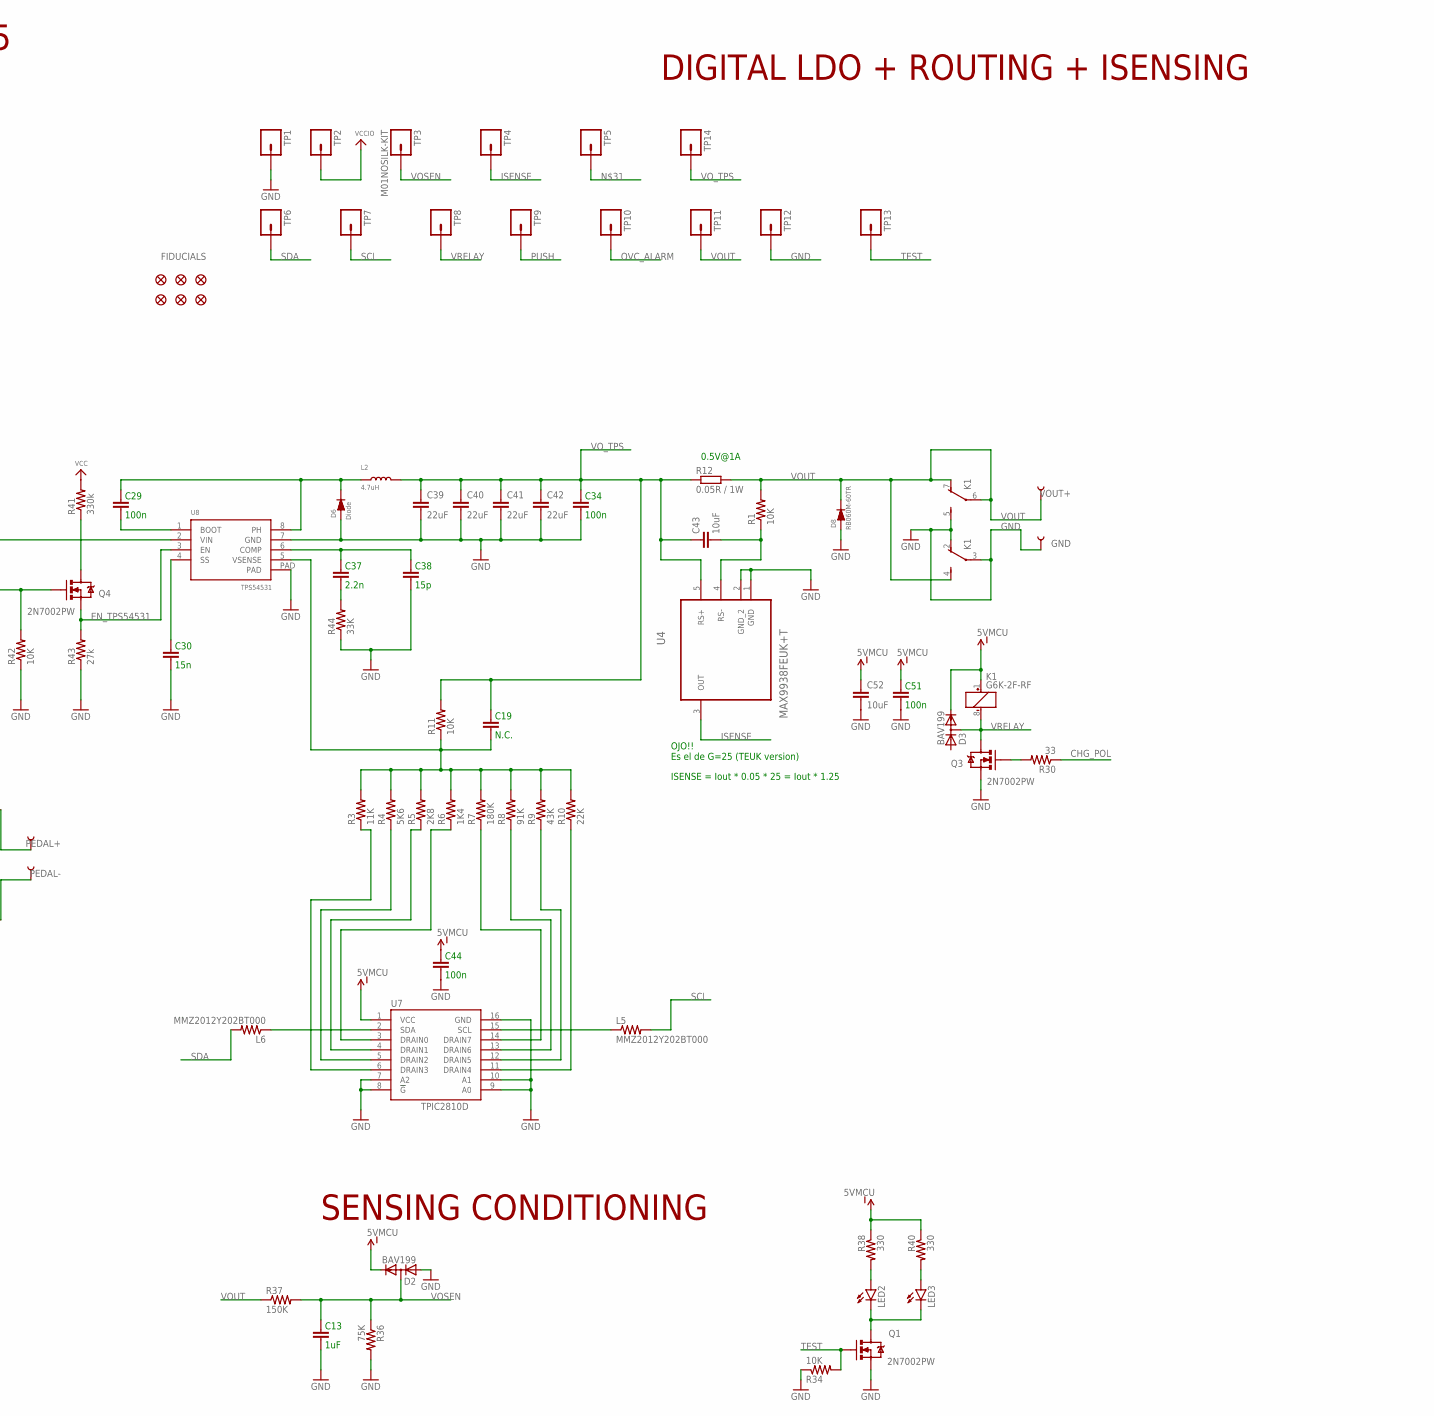
[picture p86: schematic EDCPSU.sch, part in row 1, column 2]

Parts:
BZ1: PKMCS0909E4000-R1; PKMCS0909
C1, C2, C7, C8, C10, C12, C14, C15, C20, C22, C23, C24, C25, C27, C28, C29, C31, C32, C33, C34, C36, C44, C45, C46, C47, C48, C49, C50, C51, C53: 100n; 0805
C3, C30: 15n; 0805
C4, C6, C26, C35, C43, C52: 10uF; 1206
C5, C19: N.C.; 0805
C9: 1uF; 1206
C11, C13, C16, C54: 1uF; 0805
C17, C18, C21: 4.7uF; 1210
C37: 2.2n; 0805
C38: 15p; 0805
C39, C40, C41, C42: 22uF; 1210
D1: Diode; SOD123
D2, D3: BAV199; SOT23
D4: BZT52-B5V6; SODFL3718X115
D5, D6: Diode; DO-214AB
D8: RB060M-60TR; SMADIODE
FID1, FID2, FID3, FID4, FID5, FID6: FIDUCIAL1X2; FIDUCIAL-1X2
GND: TEST-POINT3; PAD.03X.03
IN+: TEST-POINT3; PAD.03X.03
IN-: TEST-POINT3; PAD.03X.03
J3: AVR_ISP; 2X3
J4: FTDI_DEVICE; FTDI_DEVICE_SIDE
J6: Display; OLED_LCD
K1: G6K-2F-RF; G6K-RF
L1: 6.8uH; NR4018T100M
L2: 4.7uH; WE-LHMI
L3, L4, L5, L6, L7: MMZ2012Y202BT000; 0805
LED1: LED3MM
LED2, LED3: LED5MM
OP1: LTV816S; SMD4
PEDAL+: TEST-POINT3; PAD.03X.03
PEDAL-: TEST-POINT3; PAD.03X.03
PTC1: 2A NOM / 3.5A LIM; 1812L
Q1, Q2, Q3, Q4, Q9: 2N7002PW; SOT323
R1, R11, R34, R39, R42, R66, R77: 10K; 0805
R2, R19, R20, R25: 1K; 0805
R3: 11K; 0805
R4: 5K6; 0805
R5: 2K8; 0805
R6: 1K4; 0805
R7: 180K; 0805
R8: 91K; 0805
R9: 43K; 0805
R10: 22K; 0805
R12: 0.05R / 1W; R2512
R13, R23, R52, R53, R54, R57, R58: 2K2; 0805
R14, R17, R21, R24, R28, R29, R30, R31, R45, R65, R99: 33; 0805
R15: 68K; 0805
R16: 12K; 0805
R18, R46: N.C.; 0805
R22, R26: 330; 1206
R27: 33R; 0805
R32: 10k; 0805
R33, R35, R38, R40, R61: 330; 0805
R36: 75K; 0805
R37: 150K; 0805
R41: 330k; 0805
R43: 27k; 0805
R44: 33K; 0805
S1: ROTARTY_ENCODER; ROTARY_ENC_PLAIN
S2: TAC_SWITCH_KSC931G-SMD; TAC_SW_SMD_KSC931G
TP1, TP2, TP4, TP5, TP6, TP7, TP8, TP9, TP10, TP11, TP12, TP13, TP14: M01POGOPIN_HOLE_LARGE; 1X01_POGOPIN_HOLE_LARGE
TP3: M01NOSILK-KIT; 1X01NS-KIT
U1: ATMEGA328; TQFP32-08
U2: BD9G101G; SSOP6
U3, U6: 7414; TSSOP14
U4: MAX9938FEUK+T; SOT95P280X145-5N
U5: LM3480IM4; SOT23-3
U7: TPIC2810D; SO16
U8: TPS54531; SOIC8
VOUT+: TEST-POINT3; PAD.03X.03
X1: 16MHz; RESONATOR-SMD

Connections:
AREF: C32.2, U1.20 (AREF)
BUZZ: R28.1, U1.10 (PD6(AIN0))
CHG_POL: R30.1, U1.11 (PD7(AIN1))
CS: J6.7 (CS), R29.2, R66.2
D0: J6.3 (D0), R14.2
D1: J6.4 (D1), R17.2
DSP_RST: R21.1, U1.12 (PB0(ICP))
DTR: C33.2, J4.P$1 (DTR)
EN_5V: R45.1, R46.2, U2.4 (EN)
EN_DCDC: Q4.1 (G), R31.1, R42.2, U1.24 (PC1(ADC1))
EN_TPS54531: Q4.2 (S), R43.2, U8.3 (EN)
GND: C1.1, C2.1, C4.2, C6.2, C7.1, C8.1, C9.2, C10.1, C11.1, C12.1, C13.1, C14.1, C15.1, C16.1, C17.2, C18.2, C20.1, C21.2, C22.1, C23.1, C24.1, C25.1, C26.2, C27.1, C28.1, C30.1, C31.1, C32.1, C34.1, C35.2, C36.1, C38.1, C39.2, C40.2, C41.2, C42.2, C44.1, C45.1, C46.1, C47.1, C48.1, C49.1, C50.1, C51.1, C52.2, C53.1, C54.1, D1.+ (A), D2.1 (A), D4.1 (A), D6.1 (A), D8.A, GND.P$1, IN-.P$1, J3.6, J4.P$5 (CTS), J4.P$6 (GND), J6.1 (GND), K1.2 (O), K1.3, K1.5 (S), OP1.3 (EMIT), Q1.2 (S), Q2.2 (S), Q3.2 (S), Q9.2 (S), R16.2, R18.1, R22.2, R32.2, R34.1, R36.2, R42.1, R43.1, R44.1, R46.1, S1.C, S1.SW-, S2.2, TP1.1, TP12.1, U1.3 (GND), U1.5 (AGND), U1.21 (GND), U2.2 (GND), U3.7 (GND), U4.1 (GND), U4.2 (GND_2), U5.3 (GND), U6.7 (GND), U7.7 (A2), U7.8 (!G), U7.9 (A0), U7.10 (A1), U7.16 (GND), U8.7 (GND), U8.PAD, X1.2
IN+: C36.2, IN+.P$1, PTC1.2
ISENSE: TP4.1, U1.22 (ADC7), U4.3 (OUT), U6.13 (I)
MISO: J3.1, R24.1, U1.16 (PB4(MISO))
MOSI: J3.4, R17.1, U1.15 (PB3(MOSI/OC2))
unnamed: R3.1, U7.6 (DRAIN3)
unnamed: R4.1, U7.5 (DRAIN2)
unnamed: R5.1, U7.4 (DRAIN1)
unnamed: R6.1, U7.3 (DRAIN0)
unnamed: R7.1, U7.14 (DRAIN7)
unnamed: J6.6 (DC), R24.2
unnamed: R8.1, U7.13 (DRAIN6)
unnamed: R9.1, U7.12 (DRAIN5)
unnamed: R10.1, U7.11 (DRAIN4)
unnamed: C43.2, R1.1, U4.4 (RS-)
unnamed: LED1.A, R35.2
unnamed: LED1.K (C), Q2.3 (D)
unnamed: R33.1, U6.6 (O)
unnamed: D5.1 (A), PTC1.1
unnamed: R39.1, U6.12 (O)
unnamed: C3.1, U2.1 (BST)
unnamed: C10.2, R13.1, R65.2, S2.4
unnamed: C47.2, R2.2, U3.9 (I)
unnamed: C3.2, D1.- (K), L1.1, U2.6 (LX)
unnamed: Q9.1 (G), R28.2, R32.1
unnamed: Q2.1 (G), R31.2
unnamed: R2.1, U3.10 (O)
unnamed: R20.1, U3.6 (O)
unnamed: U1.8 (PB7(XTAL2/TOSC2)), X1.1
unnamed: R25.1, U3.2 (O)
unnamed: C49.2, R25.2, U3.13 (I)
unnamed: C5.1, R15.2, R16.1, U2.3 (FB)
unnamed: C48.2, R20.2, U3.3 (I)
unnamed: C11.2, R23.2, U6.3 (I)
unnamed: R27.1, U1.13 (PB1(OC1A))
unnamed: OP1.4 (COL), R19.1, R99.1, TP5.1
unnamed: BZ1.1 (+), C27.2, L7.2, R61.2
unnamed: R23.1, U6.2 (O)
unnamed: Q4.3 (D), R41.1
unnamed: U1.7 (PB6(XTAL1/TOSC1)), X1.3
unnamed: C14.2, R33.2, U6.9 (I)
unnamed: LED2.A, R38.2
unnamed: C54.2, R39.2, U6.11 (I)
unnamed: L6.1, U7.2 (SDA)
unnamed: OP1.2 (C), R26.2
unnamed: Q3.1 (G), R30.2
unnamed: L3.2, R26.1
unnamed: C30.2, U8.4 (SS)
unnamed: L4.2, R22.1
unnamed: C29.1, U8.1 (BOOT)
unnamed: C19.1, R3.2, R4.2, R5.2, R6.2, R7.2, R8.2, R9.2, R10.2, R11.1, U8.5 (VSENSE)
unnamed: LED3.A, R40.2
unnamed: C29.2, D6.2 (K), L2.1, U8.8 (PH)
unnamed: C37.2, C38.2, U8.6 (COMP)
unnamed: C37.1, R44.2
unnamed: L5.1, U7.15 (SCL)
unnamed: L3.1, PEDAL+.P$1
unnamed: L4.1, PEDAL-.P$1
unnamed: LED2.K (C), LED3.K (C), Q1.3 (D)
unnamed: BZ1.2 (-), Q9.3 (D), R61.1
OVC_ALARM: TP10.1, U1.9 (PD5(T1)), U6.10 (O)
PEDAL_IP: U1.32 (PD2(INT0)), U6.4 (O)
PUSH: R65.1, TP9.1, U6.5 (I)
PUSH_FILT: U1.25 (PC2(ADC2)), U6.8 (O)
RESET: C33.1, J3.5, R77.1, U1.29 (PC6(/RESET))
ROTA: C23.2, R53.1, S1.A, U3.5 (I)
ROTA_FILT: U1.2 (PD4(XCK/T0)), U3.4 (O)
ROTB: C22.2, R52.1, S1.B, U3.11 (I)
ROTB_FILT: U1.1 (PD3(INT1)), U3.8 (O)
ROTPUSH: C24.2, R54.1, S1.SW+, U3.1 (I)
RPUSH_FILT: U1.26 (PC3(ADC3)), U3.12 (O)
RST: J6.5 (RST), R21.2
RX-I: J4.P$3 (RXI), U1.30 (PD0(RXD))
SCK: J3.3, R14.1, U1.17 (PB5(SCK))
SCL: L5.2, R57.1, TP7.1, U1.28 (PC5(ADC5/SCL))
SDA: L6.2, R58.1, TP6.1, U1.27 (PC4(ADC4/SDA))
SPARE: C9.1, R18.2, R99.2, U1.23 (PC0(ADC0)), U6.1 (I)
SS: R29.1, U1.14 (PB2(SS/OC1B))
TEST: Q1.1 (G), R27.2, R34.2, TP13.1
TX-O: J4.P$2 (TXO), U1.31 (PD1(TXD))
VCC: C6.1, C7.2, C17.1, C18.1, C21.1, C28.2, C35.1, D5.2 (K), L7.1, R41.2, R45.2, U2.5 (VCC), U5.2 (IN), U8.2 (VIN)
VCC-ISO: C1.2, C2.2, C4.1, C5.2, C12.2, C15.2, C20.2, C25.2, C26.1, C31.2, C44.2, C45.2, C46.2, C50.2, C51.2, C52.1, C53.2, D2.2 (C), D3.2 (C), D4.2 (C), J3.2, J4.P$4 (VCC), J6.2 (VCC), K1.1 (+), L1.2, R13.2, R15.1, R19.2, R35.1, R38.1, R40.1, R52.2, R53.2, R54.2, R57.2, R58.2, R66.1, R77.2, U1.4 (VCC), U1.6 (VCC), U1.18 (AVCC), U3.14 (VCC), U6.14 (VCC), U7.1 (VCC)
VCCIO: C8.2, C16.2, OP1.1 (A), TP2.1, U5.1 (OUT)
VOSEN: C13.2, D2.3 (AC), R36.1, R37.2, TP3.1, U1.19 (ADC6)
VOUT: D8.C (K), K1.4 (S), K1.6, K1.7 (O), R1.2, R12.2, R37.1, TP11.1, VOUT+.P$1
VO_TPS: C19.2, C34.2, C39.1, C40.1, C41.1, C42.1, C43.1, L2.2, R11.2, R12.1, TP14.1, U4.5 (RS+)
VRELAY: D3.3 (AC), K1.8 (-), Q3.3 (D), TP8.1

Notes on the sheet:
0.5V@1A
SENSING CONDITIONING
DIGITAL LDO + ROUTING + ISENSING
MCU + USB
EDCPSU r15
(DATA/COMMAND)
Overlap buzzer assy concentric
ICSP
BUZZER
ROTARY + SWITCH
DISPLAY
FIDUCIALS
Resistor divider only for compatibility with other parts. BD9G101G has an internal 500k pulldown resistor.
D4 Zener protection is for preventing clamp diodes from feeding the 5V rail with higher voltage than 5.6V
OJO!! Es el de G=25 (TEUK version)
ISENSE = Iout * 0.05 * 25 = Iout * 1.25

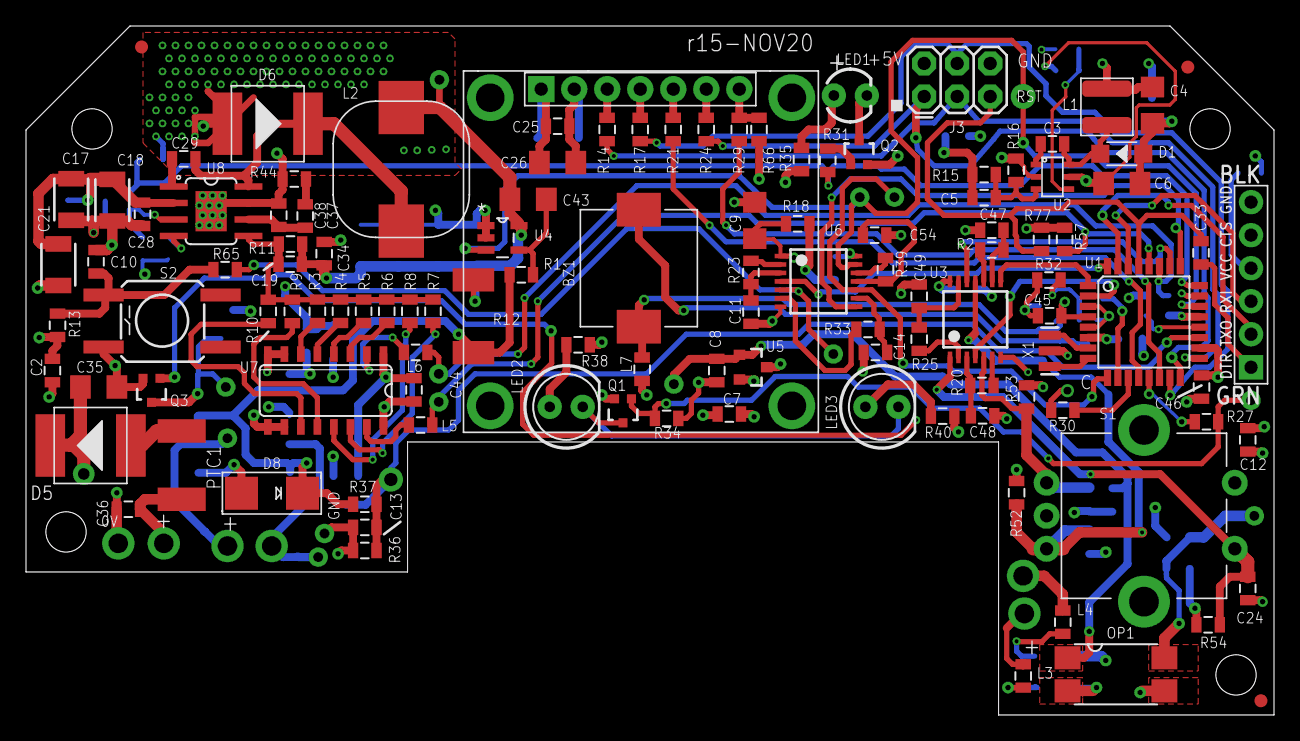
[picture p87: board EDCPSU.brd from above]

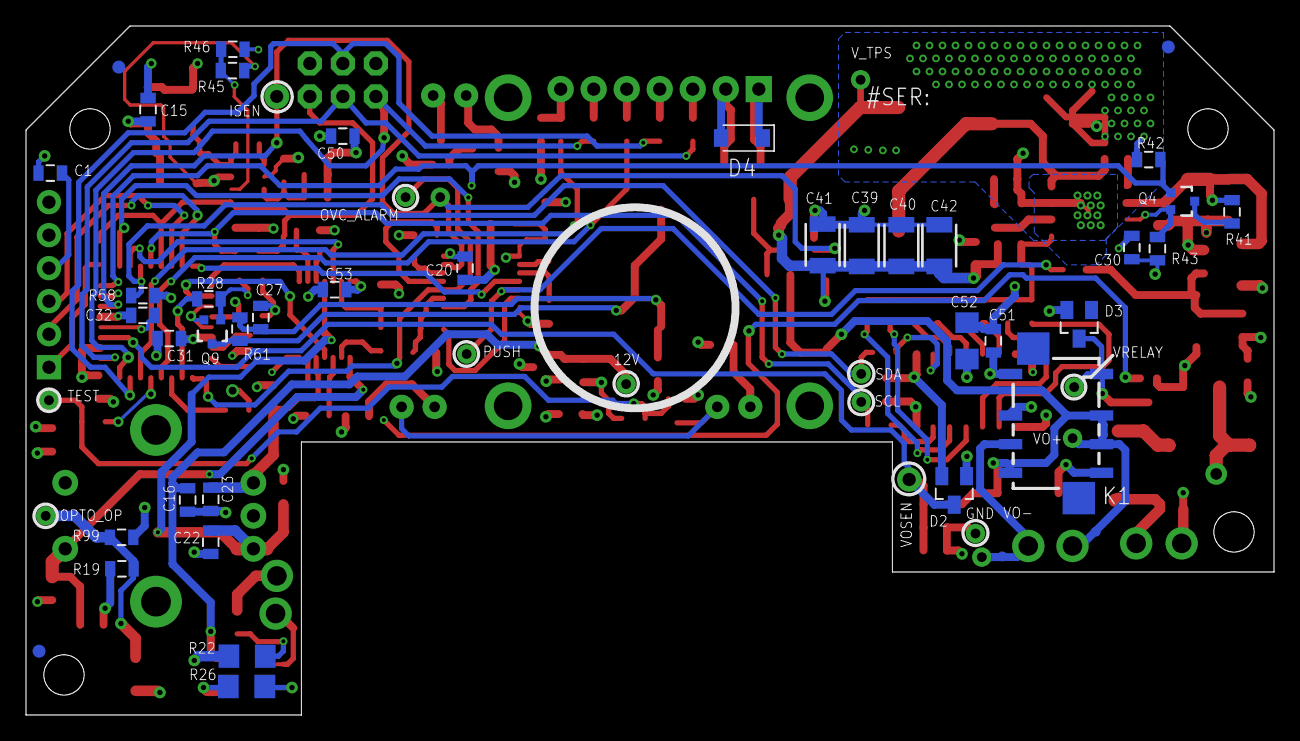
[picture p88: board EDCPSU.brd from below]

Board: 4 copper layers, 96.0 x 53.0 mm, 176 parts (41 on the bottom side), 98 nets.
