MSTKMAD/MK1/02.Hardware/MK1-ATMEGA/EDCPSU_DUAL_MSTK_M1/02. JACK_DUAL_M1/HISTORY/v1/JACK_DUAL_M2.brd

## EAGLE design 02.Hardware/MK1-ATMEGA/EDCPSU_DUAL_MSTK_M1/02. JACK_DUAL_M1/HISTORY/v1/JACK_DUAL_M2.brd (2023-06-05, an earlier design)

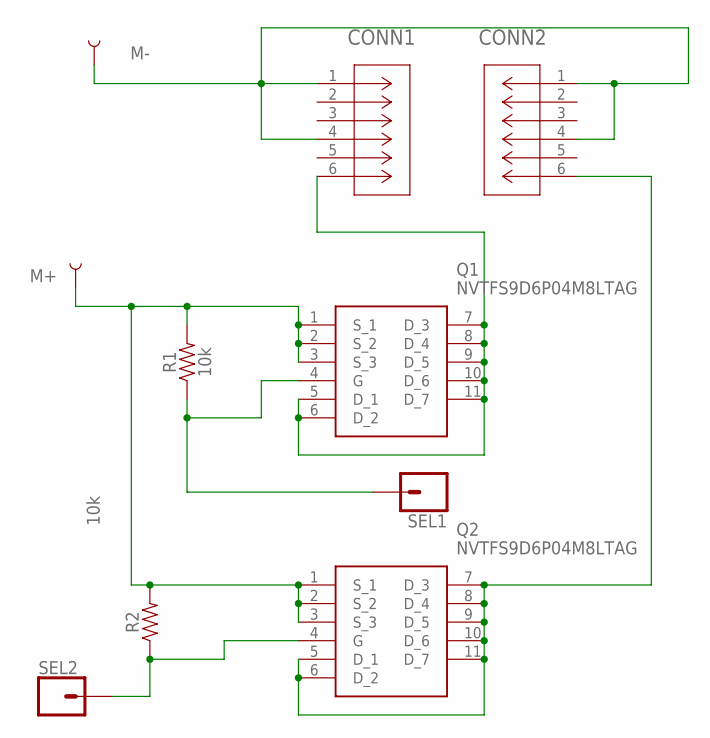
[picture p89: schematic JACK_DUAL_M2.sch]

Parts:
CONN1, CONN2: ACJS-MHDR; CONN_MHDR_AMP
M+: TEST-POINT3; PAD.03X.03
M-: TEST-POINT3; PAD.03X.03
Q1, Q2: NVTFS9D6P04M8LTAG; NVTFS5124PLTWG
R1, R2: 10k; 0805
SEL1, SEL2: CONN_01; 1X01

Connections:
GND: CONN1.1, CONN1.4, CONN2.1, CONN2.4, M-.P$1
M+: M+.P$1, Q1.1 (S_1), Q1.2 (S_2), Q1.3 (S_3), Q2.1 (S_1), Q2.2 (S_2), Q2.3 (S_3), R1.2, R2.2
unnamed: CONN1.6, Q1.5 (D_1), Q1.6 (D_2), Q1.7 (D_3), Q1.8 (D_4), Q1.9 (D_5), Q1.10 (D_6), Q1.11 (D_7)
unnamed: CONN2.6, Q2.5 (D_1), Q2.6 (D_2), Q2.7 (D_3), Q2.8 (D_4), Q2.9 (D_5), Q2.10 (D_6), Q2.11 (D_7)
unnamed: Q1.4 (G), R1.1, SEL1.1
unnamed: Q2.4 (G), R2.1, SEL2.1

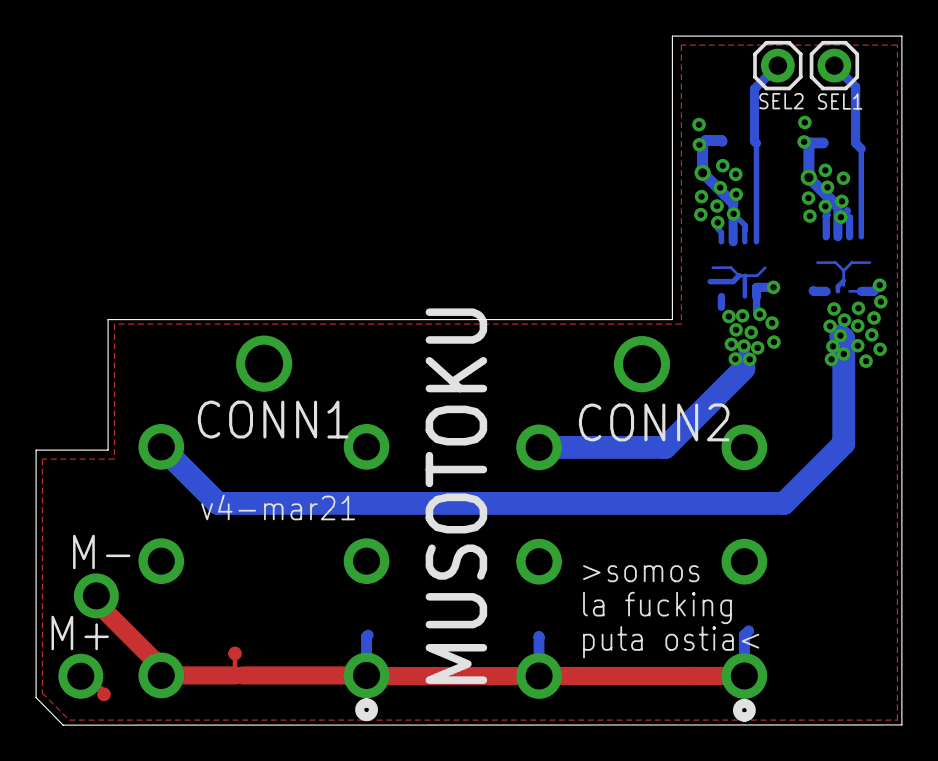
[picture p90: board JACK_DUAL_M2.brd from above]

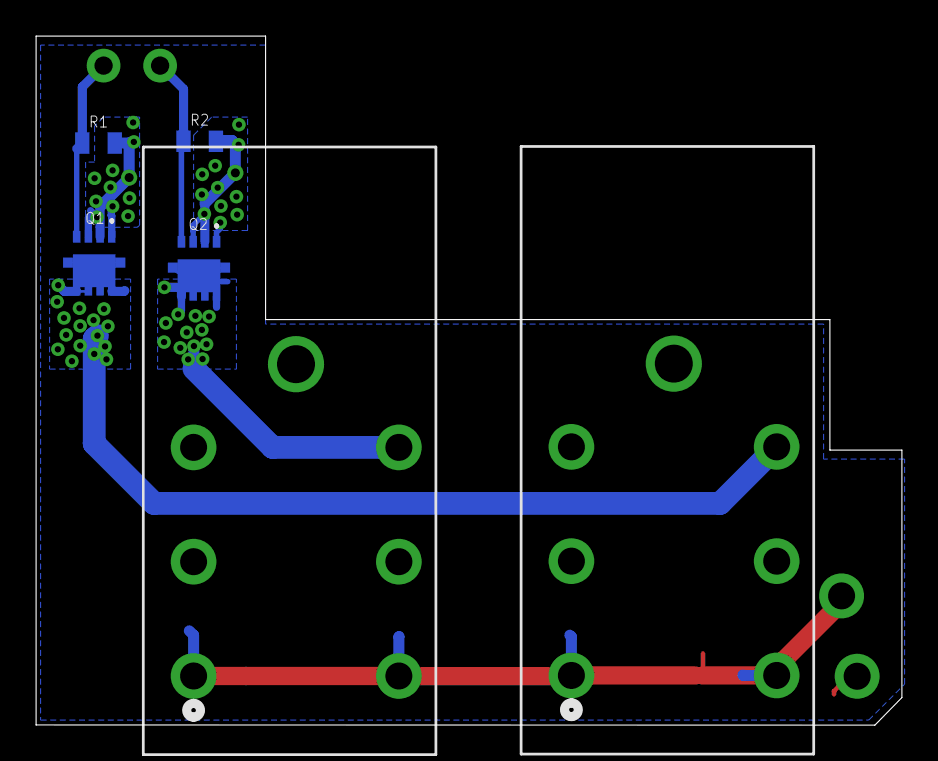
[picture p91: board JACK_DUAL_M2.brd from below]

Board: 4 copper layers, 48.1 x 38.3 mm, 10 parts (6 on the bottom side), 6 nets.
