MSTKMAD/MK1/(commit log)

2023-06-05 Initial Commit.
    Subido y volcado de todos los archivos relacionados con el repositorio de la machete MK1, sin introducir ningún cambio.
    [BOM-DUAL-MCHT.xlsx, DUAL_M2_LEDS.brd, DUAL_M2_LEDS.sch, DUAL_OUT_LEDs.brd, DUAL_OUT_LEDs.dxf, DUAL_OUT_LEDs.sch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]
2023-06-06 Migracion inicial de Atmega a RP2040. Basada en version 805 de la MK2.
2023-06-06 Formateo de espacio y saltos de linea
2023-08-10 Archivos necesarios para la compilacion.
    Compile.bat
    Upload2RP
    Librerias
    [Lookup table TPIC.xlsx]
2023-10-04 Creacion de Version RP2040
    [EDCPSUMK1-RP2040.brd, EDCPSUMK1-RP2040.sch, EDCPSU_MK2_RP2040_BOM-SETI.xlsx, EDCPSU_MK2_RP2040_BOM.xlsx]
2023-10-04 Conectores v4 compatibles con version rp2040
    [Jacks_EDCPSU.GBL, Jacks_EDCPSU.GBO, Jacks_EDCPSU.GBP, Jacks_EDCPSU.GBS, Jacks_EDCPSU.GTL, Jacks_EDCPSU.GTO, Jacks_EDCPSU.GTP, Jacks_EDCPSU.GTS]
2023-10-05 Creación de BOM v1 MK1-RP2040
    [EDCPSUMK1-RP2040.csv, EDCPSU_MK1_RP2040_BOM-SETI.xlsx, EDCPSU_MK2_RP2040_BOM-SETI.xlsx, EDCPSU_MK2_RP2040_BOM.xlsx]
2023-11-16 Update Gitignore
    Exclusion de los archivos redundantes de Eagle.
    Exclusion Carpeta /buils
2023-11-16 Actualizacion BOM MK1 RP2040
    [EDCPSUMK1-RP2040.brd, EDCPSUMK1-RP2040.sch, EDCPSU_MK1_RP2040_BOM-SETI.xlsx]
2023-11-16 Actualizacion BOM MK1 RP2040 y cambios menores
    Se agranda los agujeros laterales del rotary.
    Intercambio de posición de las vías del pedal.
    Acortamiento de la peninsula.
    [EDCPSUMK1-RP2040.brd, EDCPSUMK1-RP2040.sch, EDCPSU_MK1_RP2040_BOM-SETI.xlsx]
2023-11-16 actualizacion csv BOM MK1 RP2040
    [EDCPSUMK1-RP2040.csv]
2023-12-13 Ajuste del tiempo de pulsacion larga
2023-12-13 Ajustes de la proteccion UnderVoltaje
2023-12-13 Nuevo Nitro Ajustado
    Se alarga la escalera de subida del nitro de 50ms a 200ms
2023-12-13 Actualización de Archivo de programacion
2023-12-13 Actualizacion de librerias
2023-12-13 Ajuste del limite de corriente.
    Debido al aumento de la resistencia por el trazo en la PCB en la resistencia de sensado, es necesario reajustar el limite de corriente.
2023-12-14 Nueva deteccion de cortocircuito
2023-12-14 Nuevo Nitro para RP2040
    50ms a 5v.
    Escalera de 200 ms a 12v.
    Escalera de descenso de 60ms a Voltaje deseado.
2024-01-22 Cierra issue #2 y revision general para peticion de fabricacion SETI
    Revision general.
    Se añade detalles menores.
    Cierra issue #2
    [EDCPSUMK1-RP2040.brd, EDCPSUMK1-RP2040.sch, EDCPSU_MK1_RP2040_BOM-SETI.xlsx]
2024-01-22 Ficheros de fabricacion para SETI. Produccion Enero 2024 (1ra)
    Produccion Enero 2024 (1ra)
    [EDCPSU_MK1_RP2040_BOM-SETI.xlsx]
2024-04-02 Fix error
    Debido a un error de indexacion. La proteccion se Undervoltage se habia quedado supeditada y no iba a cotejarse nunca.
    [EDCPSU-TATTOO.ino]
2024-04-02 Revert "Fix error"
    This reverts commit 3b57b25a1eaec21b558d9d443407cf5f91aafbc8.
    [EDCPSU-TATTOO.ino]
2024-04-09 Cierra el issue #4
    Cambio en el temporizador de la proteccion de cortocircuito
    [EDCPSU-TATTOO.ino]
2024-04-09 Actualizacion de Version
    Version 750: Proviene de la version 805 de la MK2 debido al cambio de microcontrolador con respecto a la version 740.
2024-10-21 Actualizacion con el ADC externo de 4 canales
2024-10-30 Actualizacion Test Plug v2. Solo Resistencia de 6Ohm
    [Test-plug.brd, Test-plug.sch]
2025-02-11 PCB Test plug v1
    [Test-plug.brd, Test-plug.sch]
2025-02-11 Driver ADC
2025-02-11 PCB MK1 RP2040- Pines RX TX
    [EDCPSUMK1-RP2040.brd, EDCPSUMK1-RP2040.sch]
2025-04-22 New USBC MK1
    [EDCPSUMK1-RP2040-USBC.brd, EDCPSUMK1-RP2040-USBC.sch, EDCPSU_MK1_RP2040_USBC_BOM-SETI.xlsx]
2025-07-03 Version 1 para Seti Mk1 USBC Rp2040
    [EDCPSUMK1-RP2040-USBC.brd, EDCPSUMK1-RP2040-USBC.csv, EDCPSUMK1-RP2040-USBC.sch, EDCPSU_MK1_RP2040_USBC_BOM-SETI.xlsx]
2025-10-07 FIXBUG: Display
    Se cambia la libreria del ssd1306 a la de la MK2 para solucionar el bug de que no se encienda la pantalla.
    [EDCPSU-TATTOO.ino]
2025-10-07 FIXBUG: Borrado EEPROM
    Se mueve la inicializacion despues de los 2 segundos del icono para prevenir que debido a malc ontacto del conector de entrada, la lectura de la eeprom se pueda corromper
    [EDCPSU-TATTOO.ino]
